valrek-sol/analog-perceptron-gf180mcu/pex/disclosure.md

okay this pex script started with me
manually writing the script and injecting to magic and netgen
got tired,

and i wanted to finish this project properly with full pex results

not possible with my other commitments.

want to learn tcl and python-matplot full power later.

so, just used claude to make a tcl file 
it did! wonderfully so. i couldnt have done this myself. obv supplied initial scripts i made and had to have a small back and forth.

so ai is used in this pex script alone

the rest of the work is all me and my worn out hands toiling away 

but i wanted to give credit to ai where it was due.

wanted to let people know that this pex sscript is not my skill level yet!

focus of this project is a tapeout, and i was selected!

learning full-custom analog design on a non-standard block and FOSS was the goal.

that is done!

next goals related are to actually learn tcl and python-matplot its so powerful. look at what it just did?

just 800 lines of tcl, and it does that! wow!
