valrek-sol/analog-perceptron-gf180mcu/pex/out/summary.md

# PEX / LVS summary — perceptron (gf180mcuD)

Generated by `pex/pex.tcl`. Provenance: [`env.txt`](env.txt).
