valrek-sol/analog-perceptron-gf180mcu/docs/images/black_perceptron_block_diagram.png

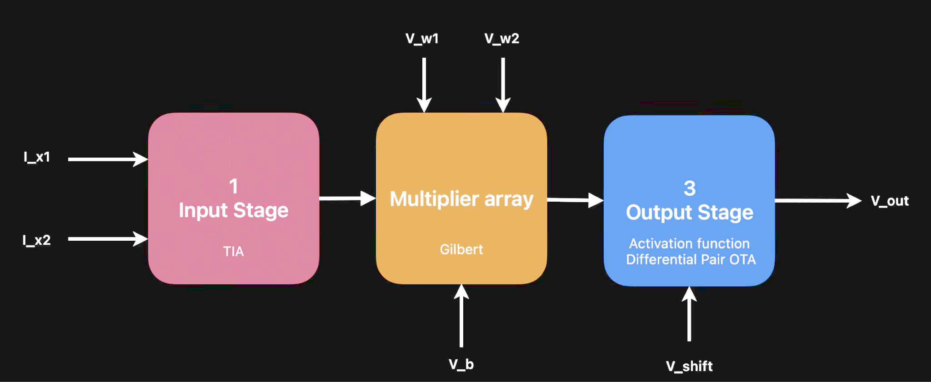
docs/images/black_perceptron_block_diagram.png
