valrek-sol/analog-perceptron-gf180mcu/docs/images/black_perceptron_sketch.png

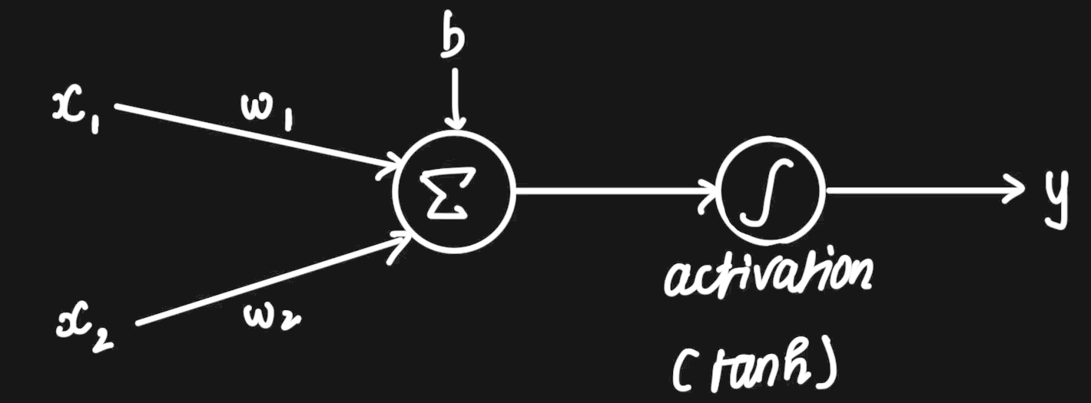
docs/images/black_perceptron_sketch.png
