valrek-sol/analog-perceptron-gf180mcu/layout/visual/black_cg_amp_tia.png

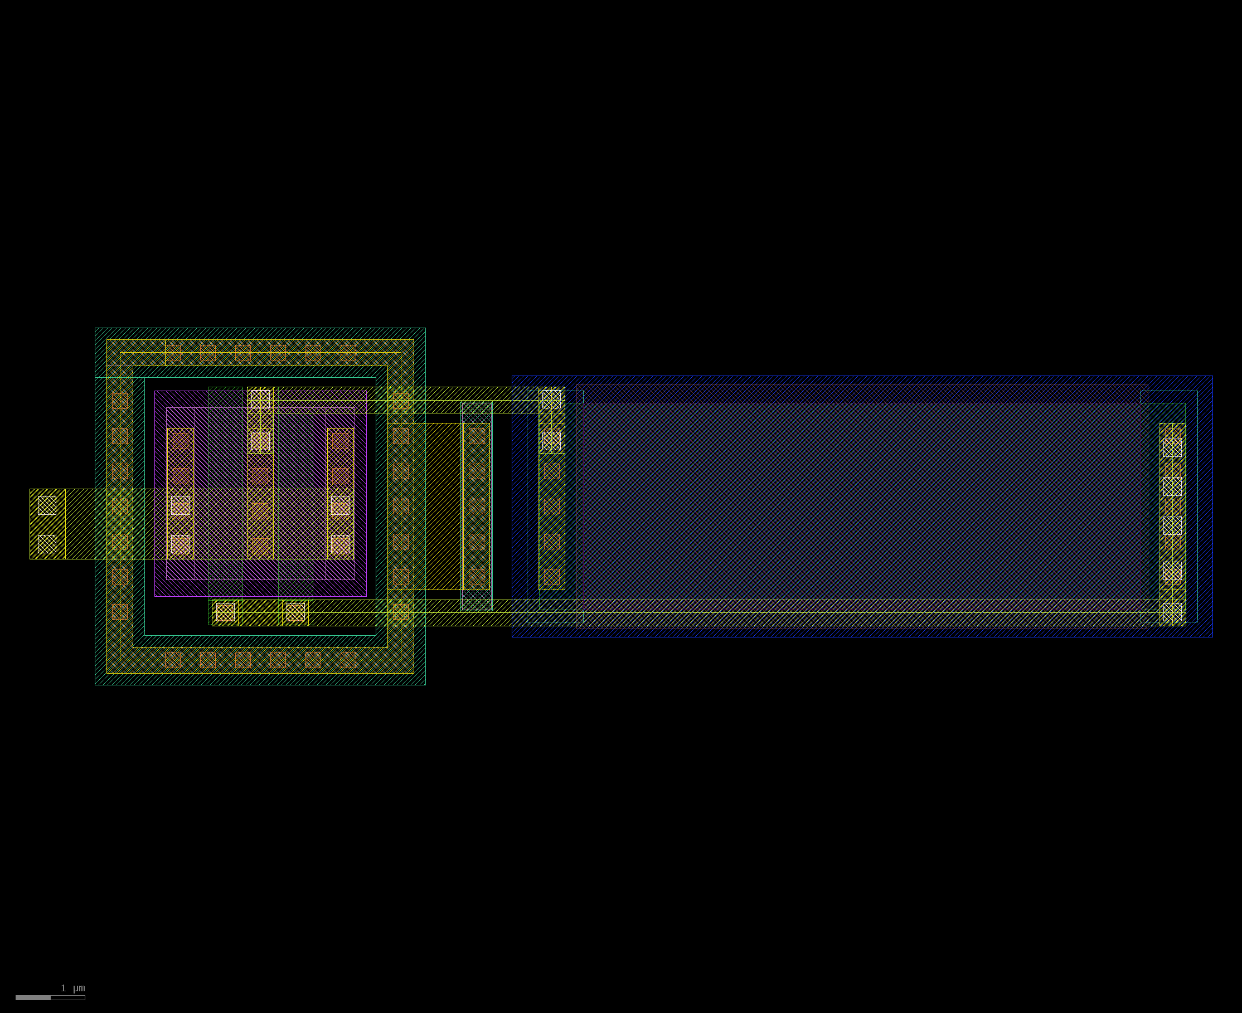
layout/visual/black_cg_amp_tia.png
