valrek-sol/analog-perceptron-gf180mcu/layout/visual/black_gilbert_multiplier_current.png

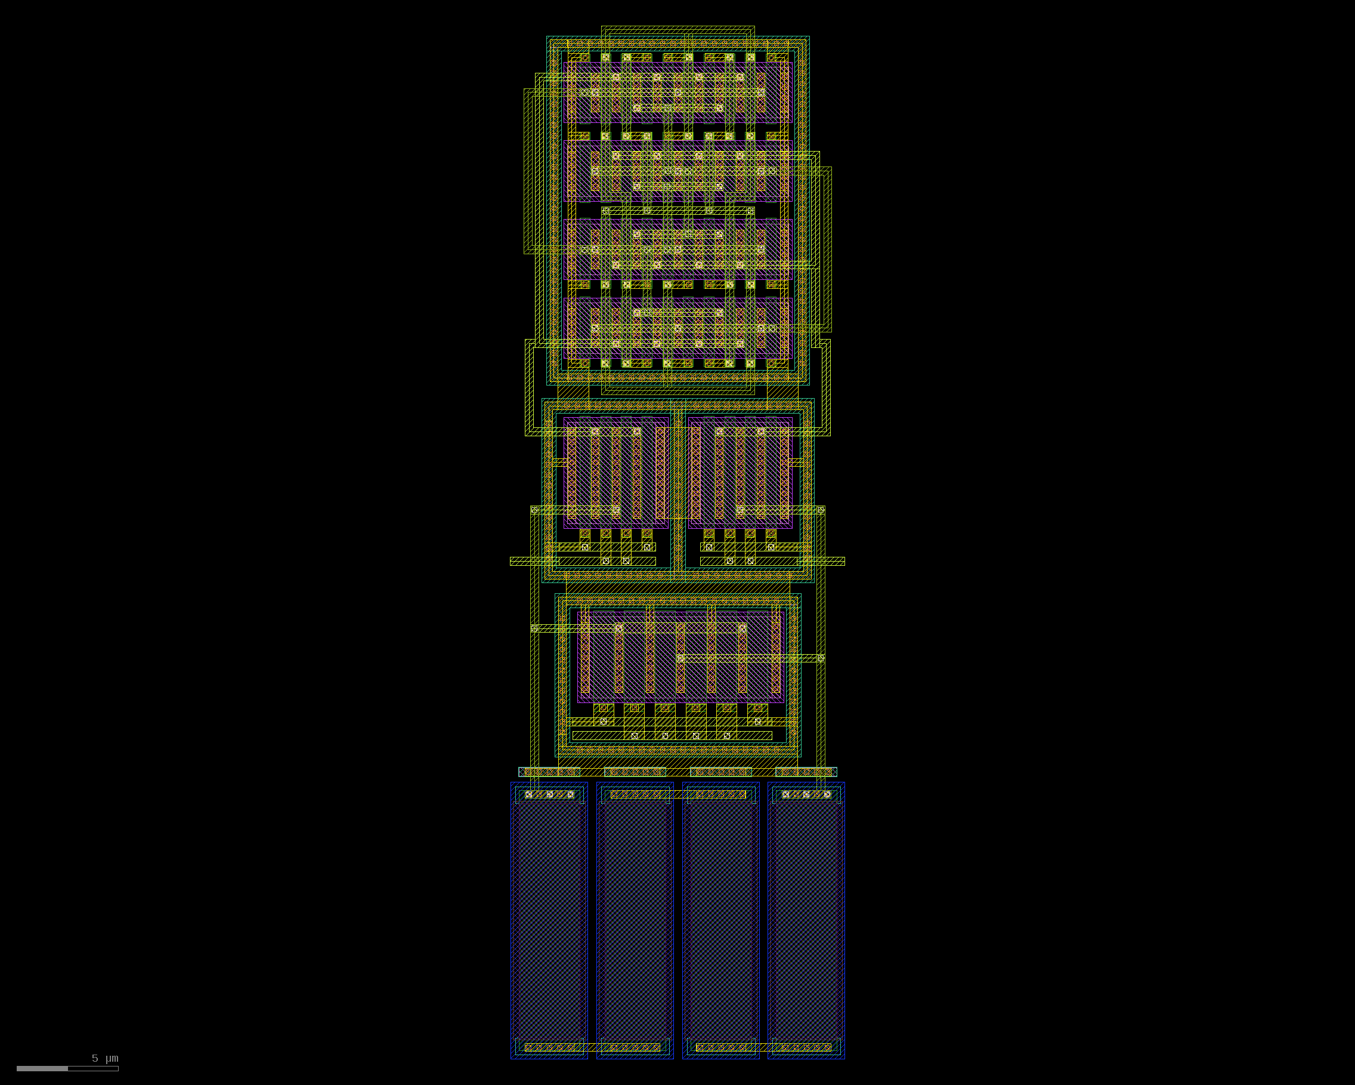
layout/visual/black_gilbert_multiplier_current.png
