valrek-sol/analog-perceptron-gf180mcu/layout/visual/black_gilbert_multiplier_current_detail.png

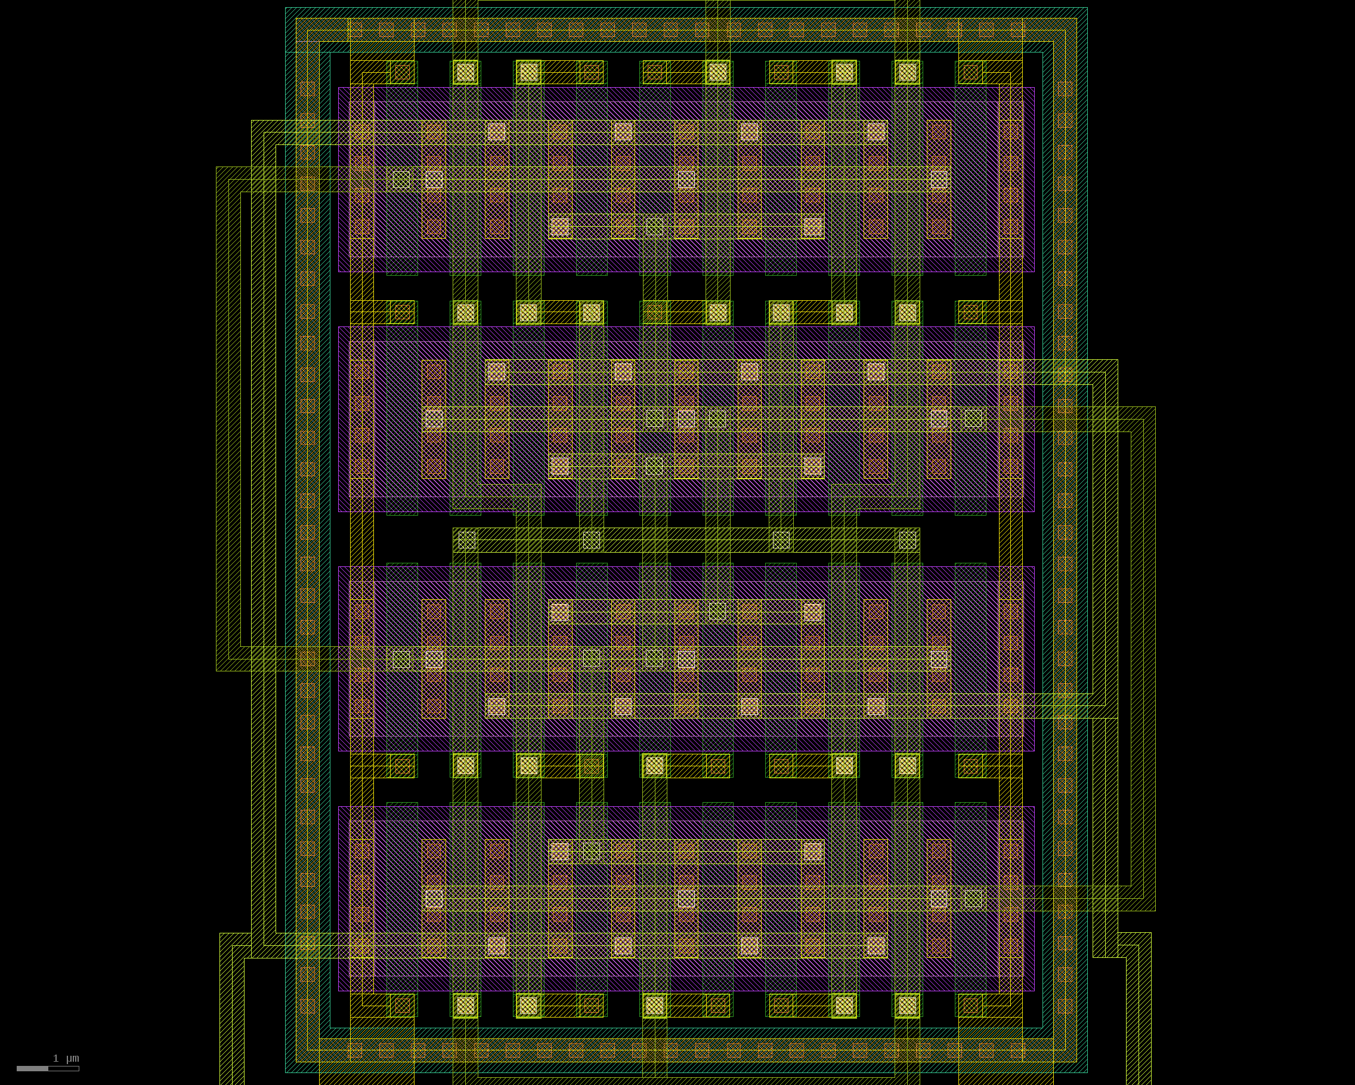
layout/visual/black_gilbert_multiplier_current_detail.png
