valrek-sol/analog-perceptron-gf180mcu/layout/visual/black_io_secondary_5p0.png

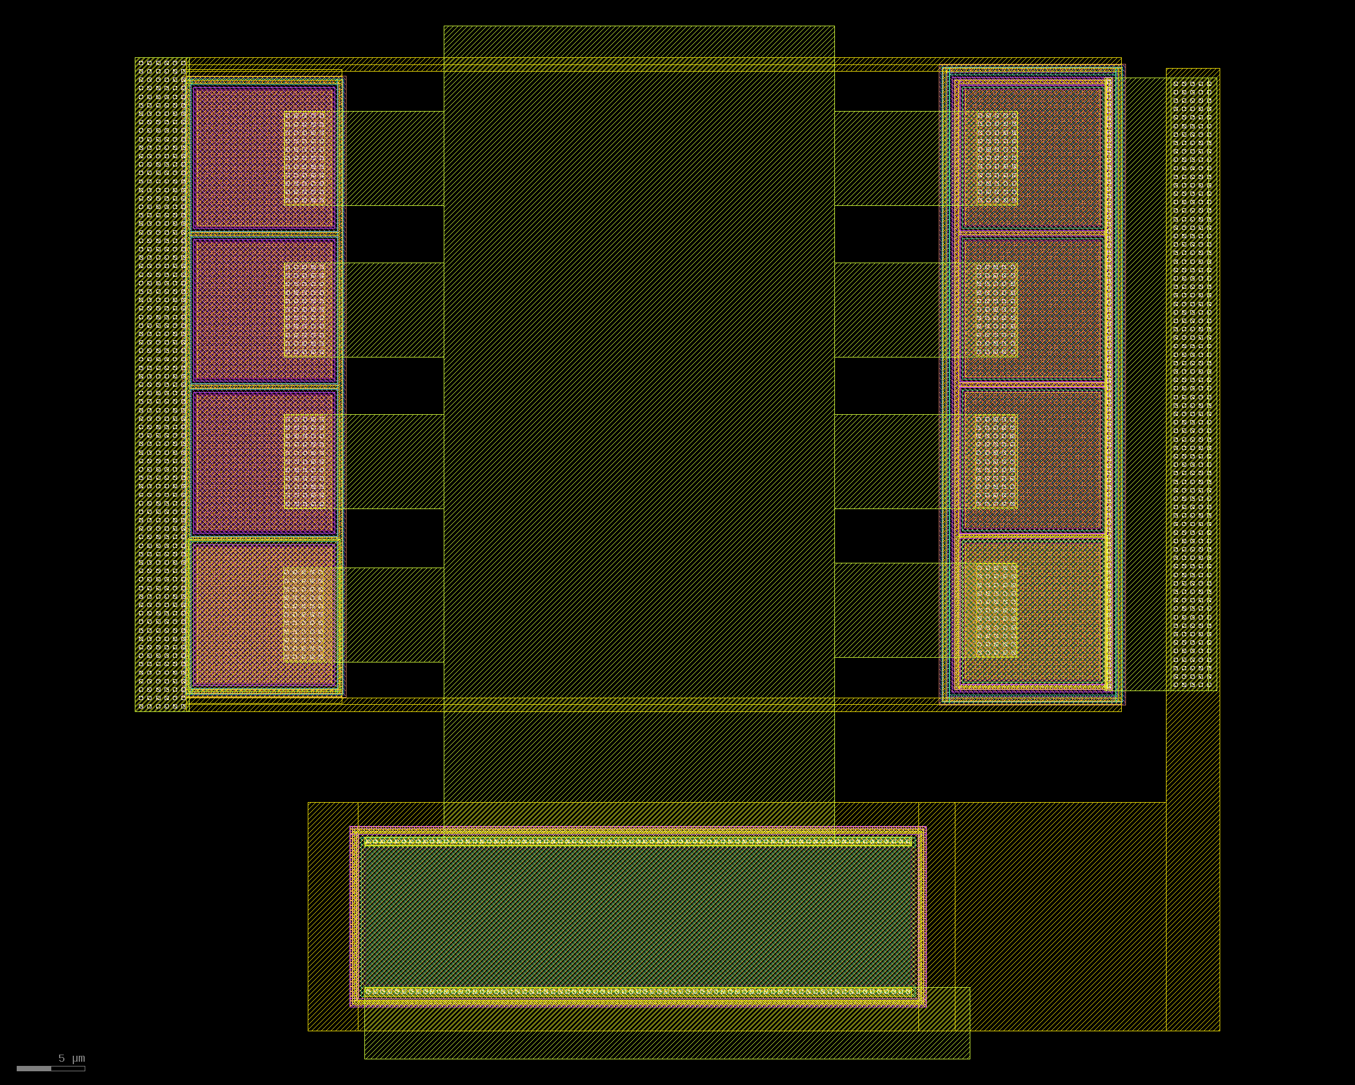
layout/visual/black_io_secondary_5p0.png
