valrek-sol/analog-perceptron-gf180mcu/layout/visual/black_perceptron.png

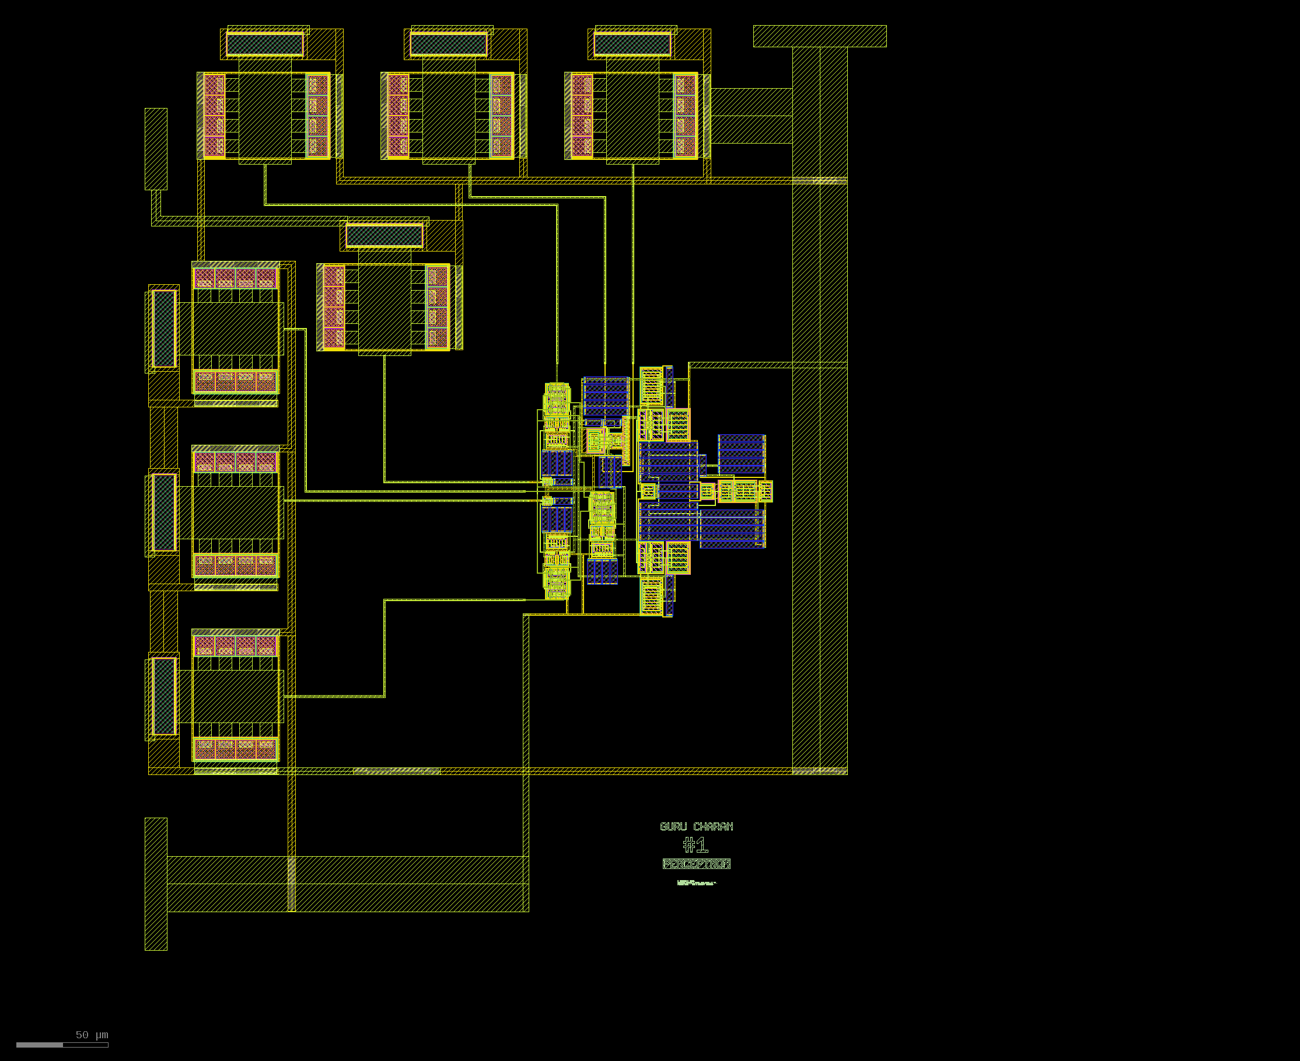
layout/visual/black_perceptron.png
