valrek-sol/analog-perceptron-gf180mcu/layout/visual/black_perceptron_core.png

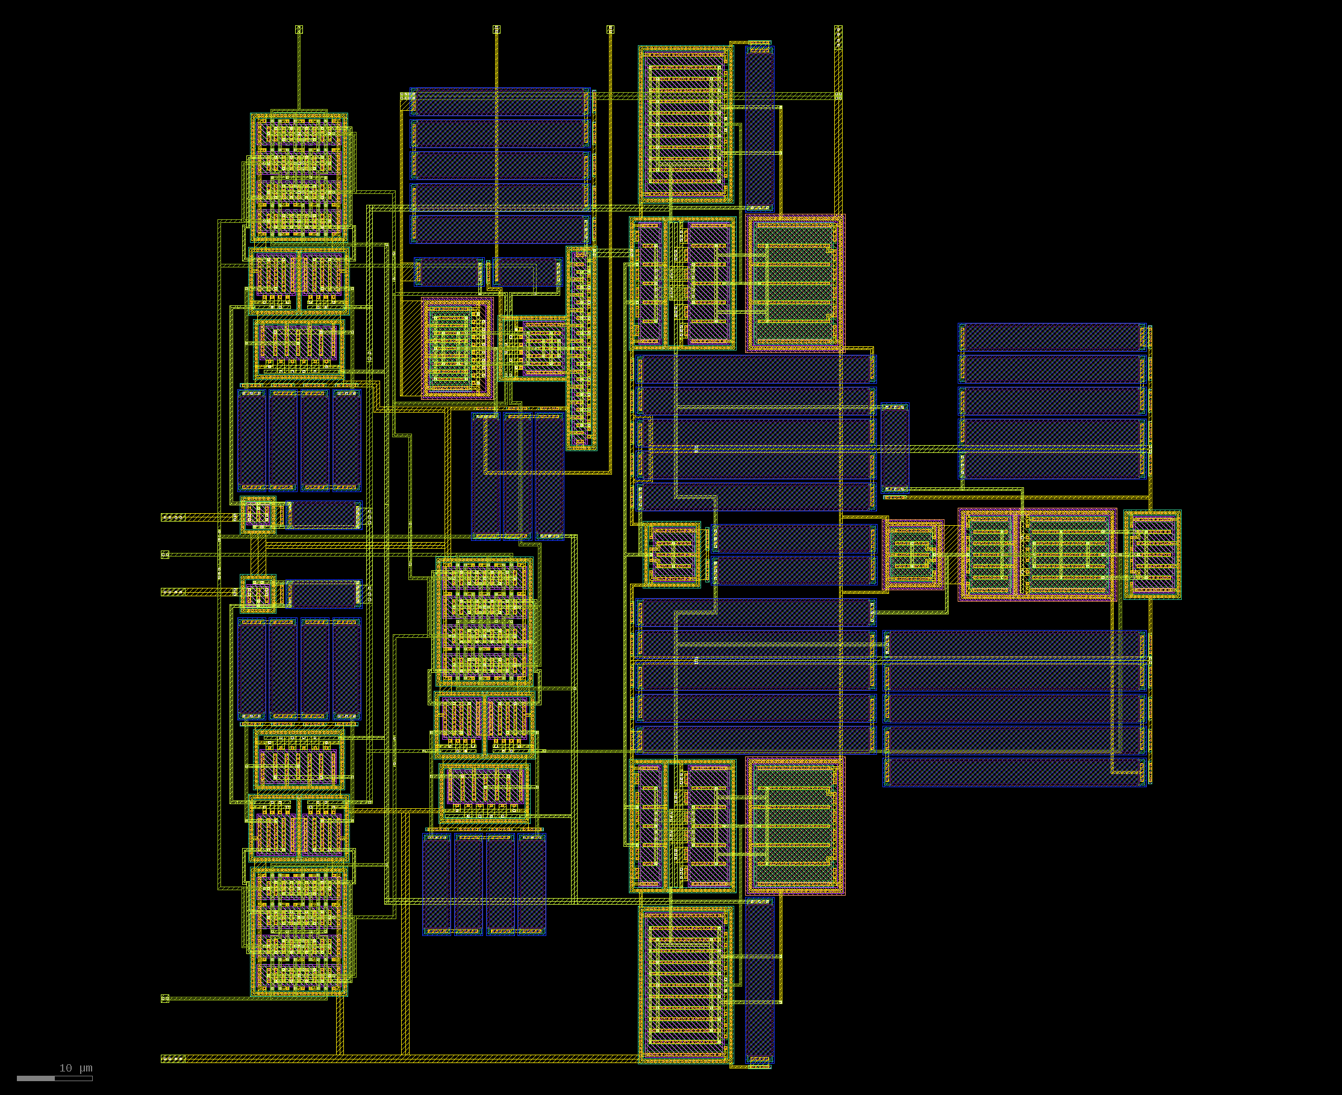
layout/visual/black_perceptron_core.png
