valrek-sol/analog-perceptron-gf180mcu/layout/visual/black_tanh_ota.png

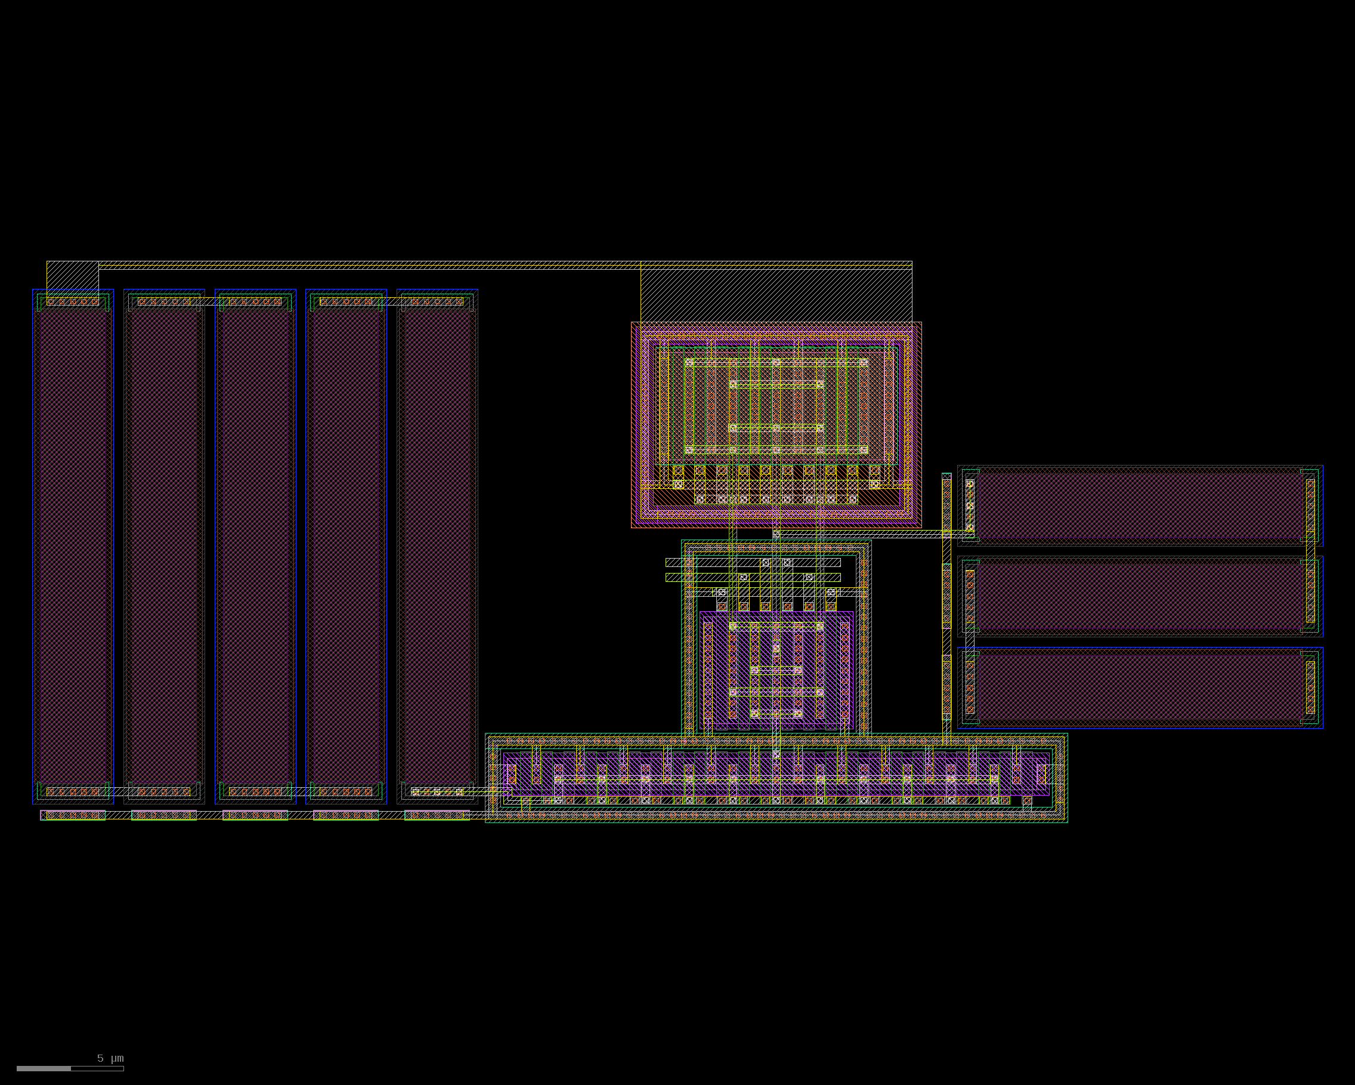
layout/visual/black_tanh_ota.png
