valrek-sol/analog-perceptron-gf180mcu/layout/visual/black_voltage_reference.png

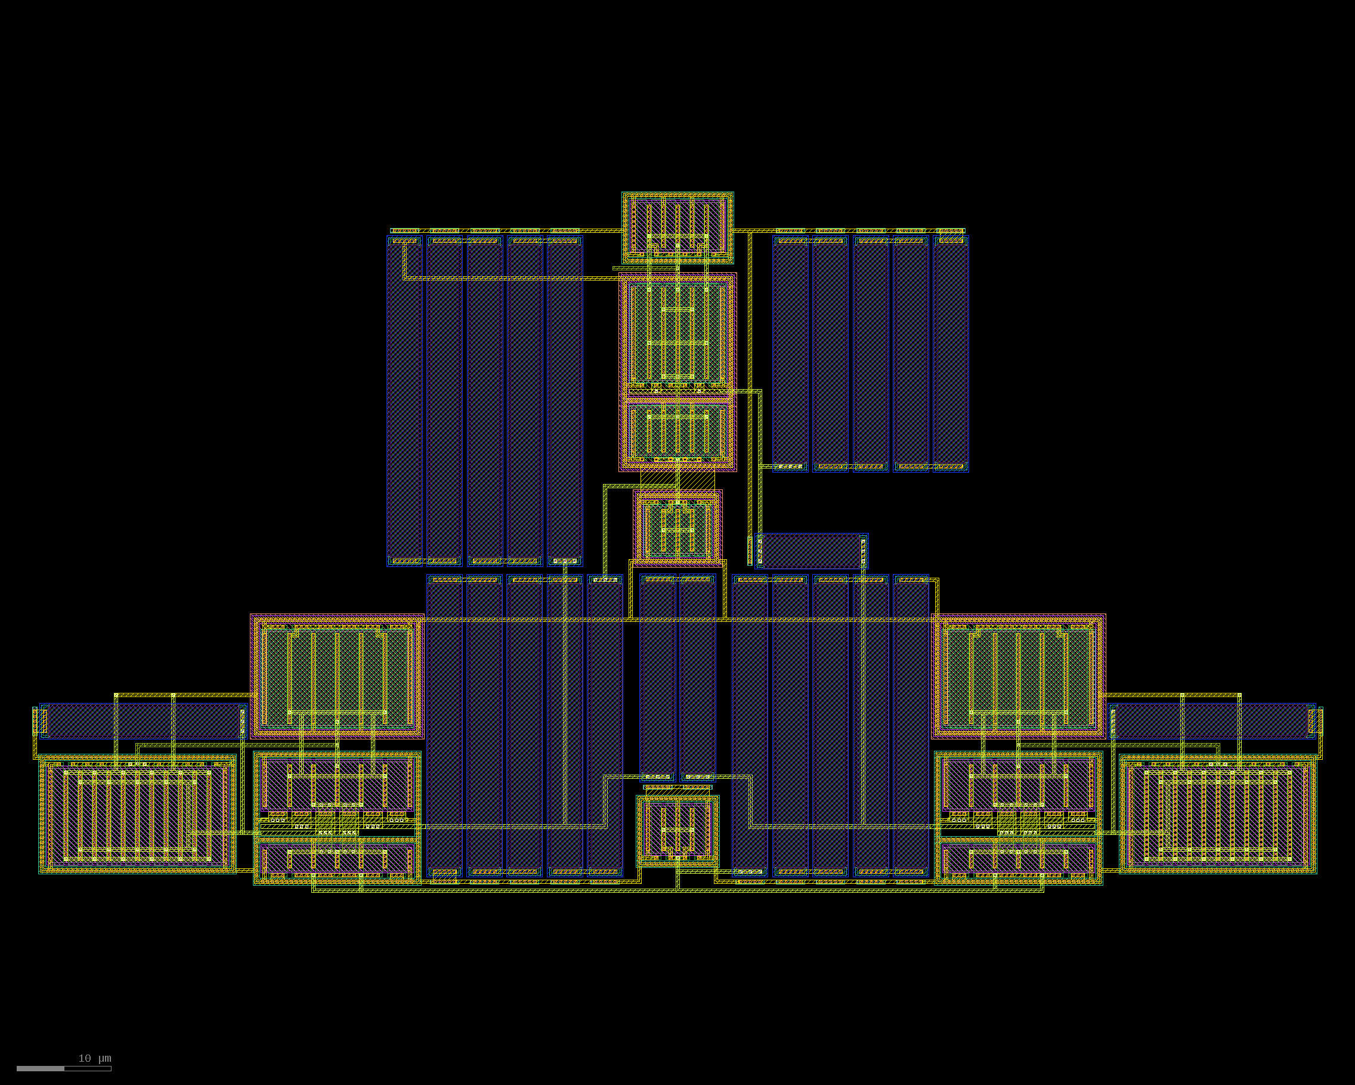
layout/visual/black_voltage_reference.png
