valrek-sol/analog-perceptron-gf180mcu/layout/visual/cg_amp_tia.png

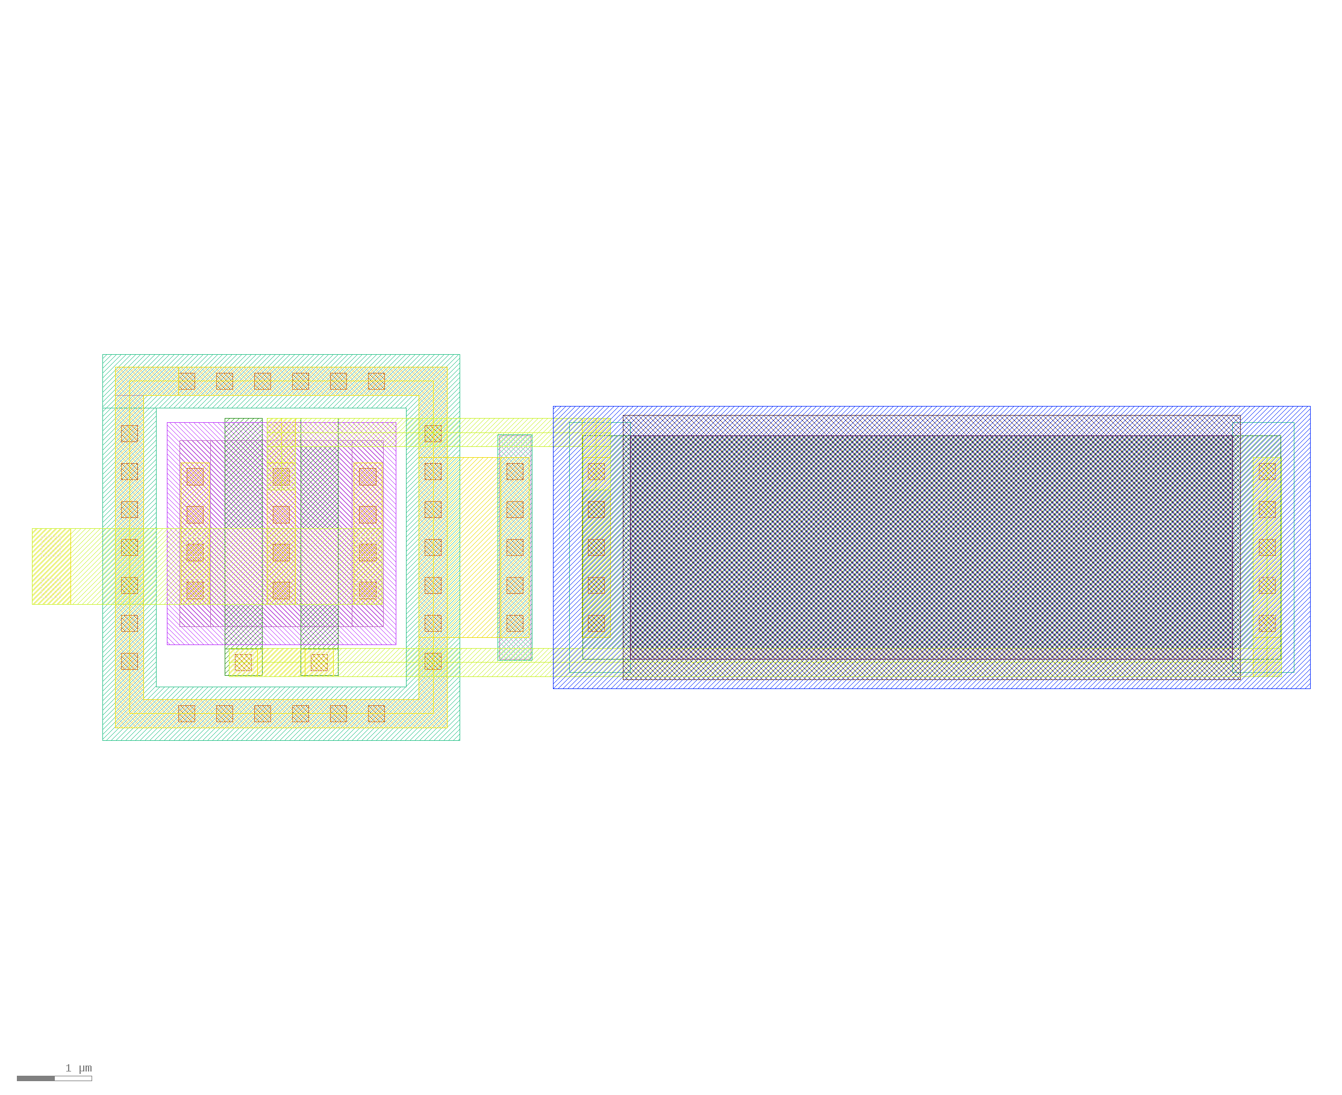
layout/visual/cg_amp_tia.png
