valrek-sol/analog-perceptron-gf180mcu/layout/visual/gilbert_multiplier_current.png

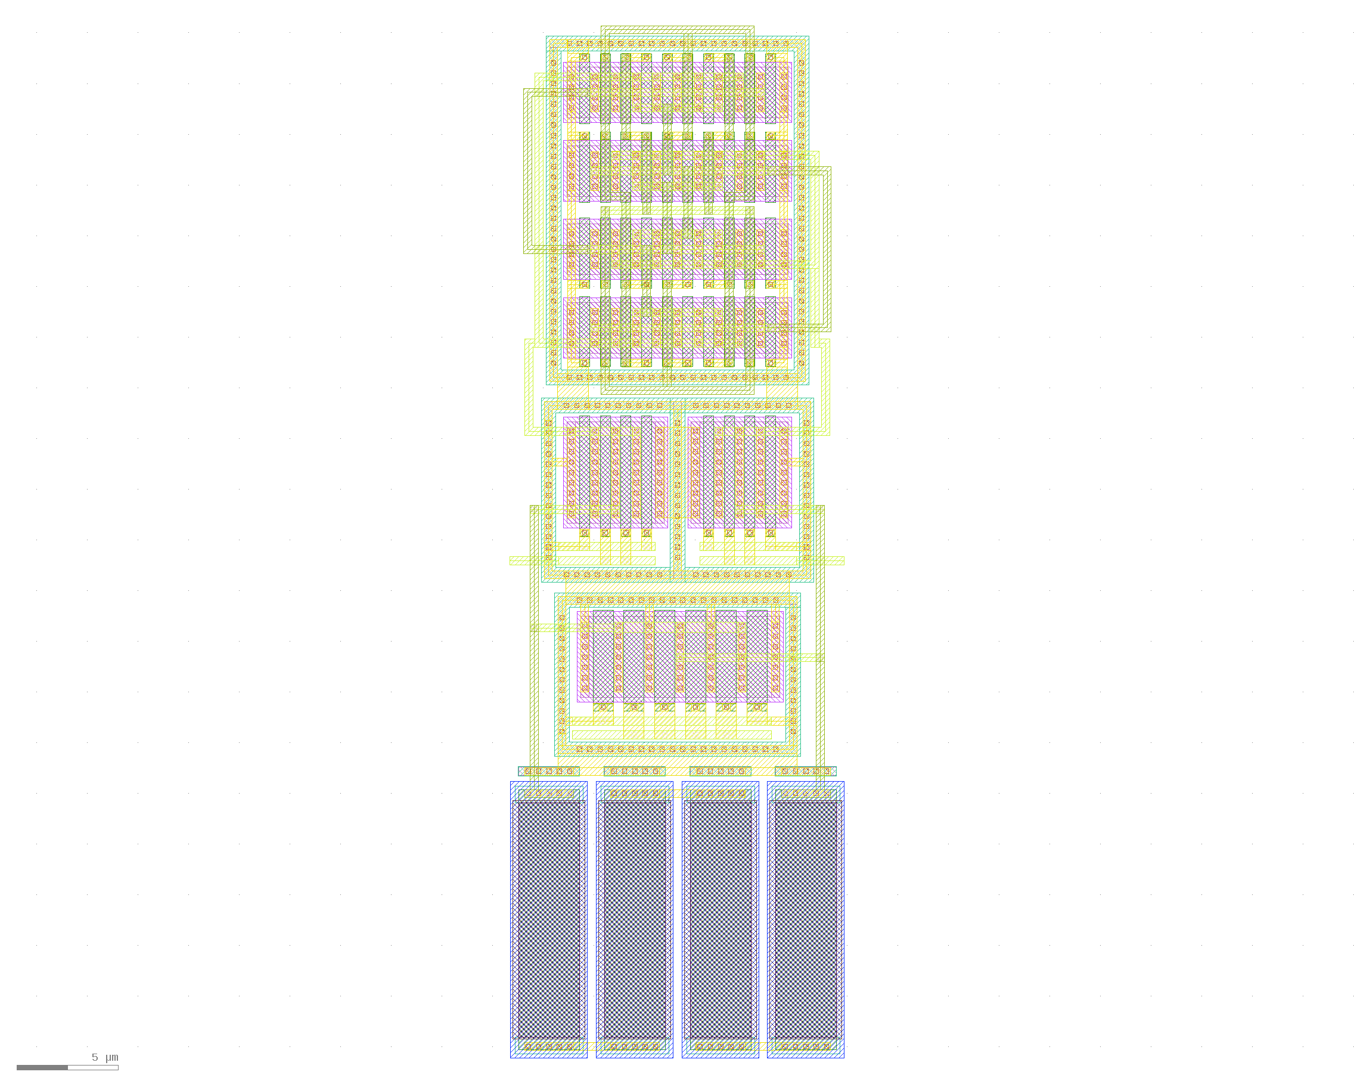
layout/visual/gilbert_multiplier_current.png
