valrek-sol/analog-perceptron-gf180mcu/layout/visual/io_secondary_5p0.png

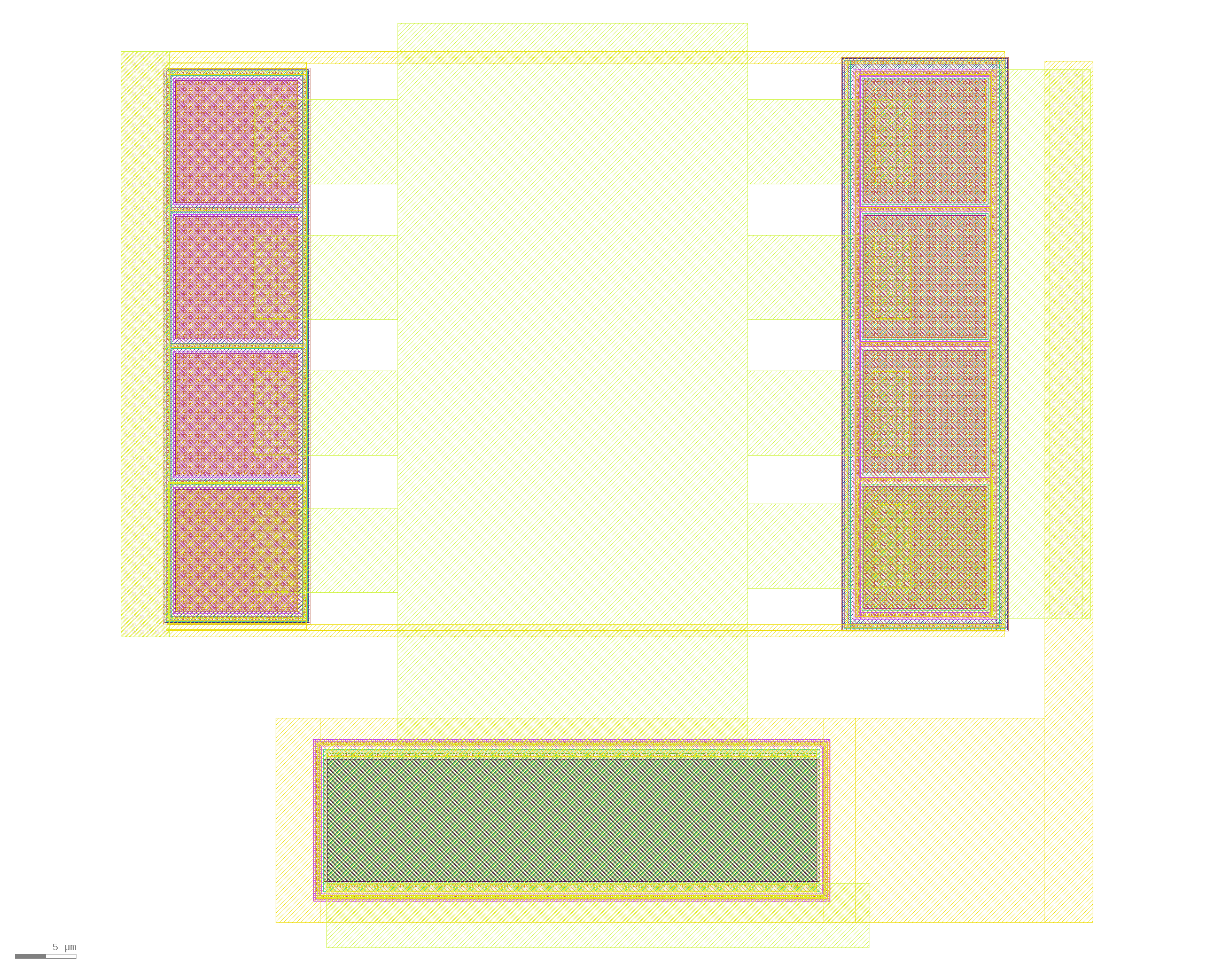
layout/visual/io_secondary_5p0.png
