valrek-sol/analog-perceptron-gf180mcu/layout/visual/perceptron.png

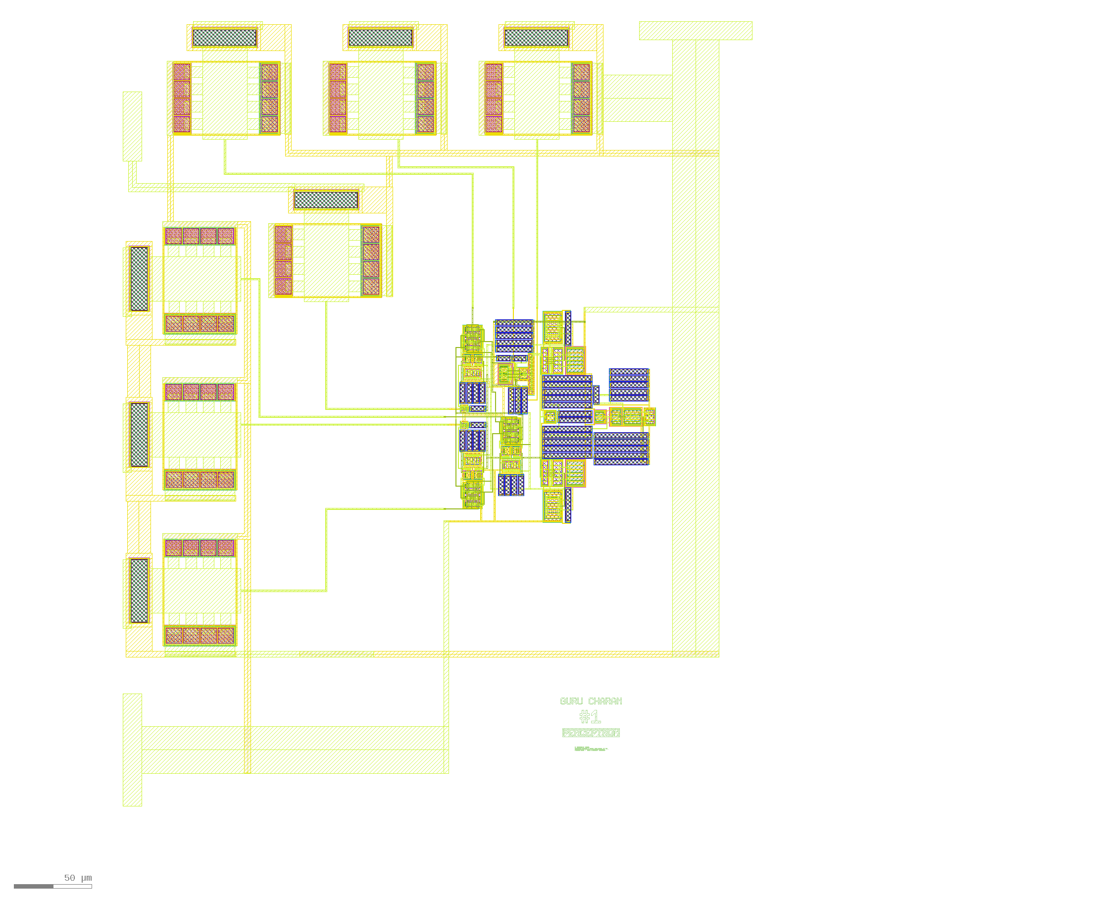
layout/visual/perceptron.png
