valrek-sol/analog-perceptron-gf180mcu/layout/visual/tanh_ota.png

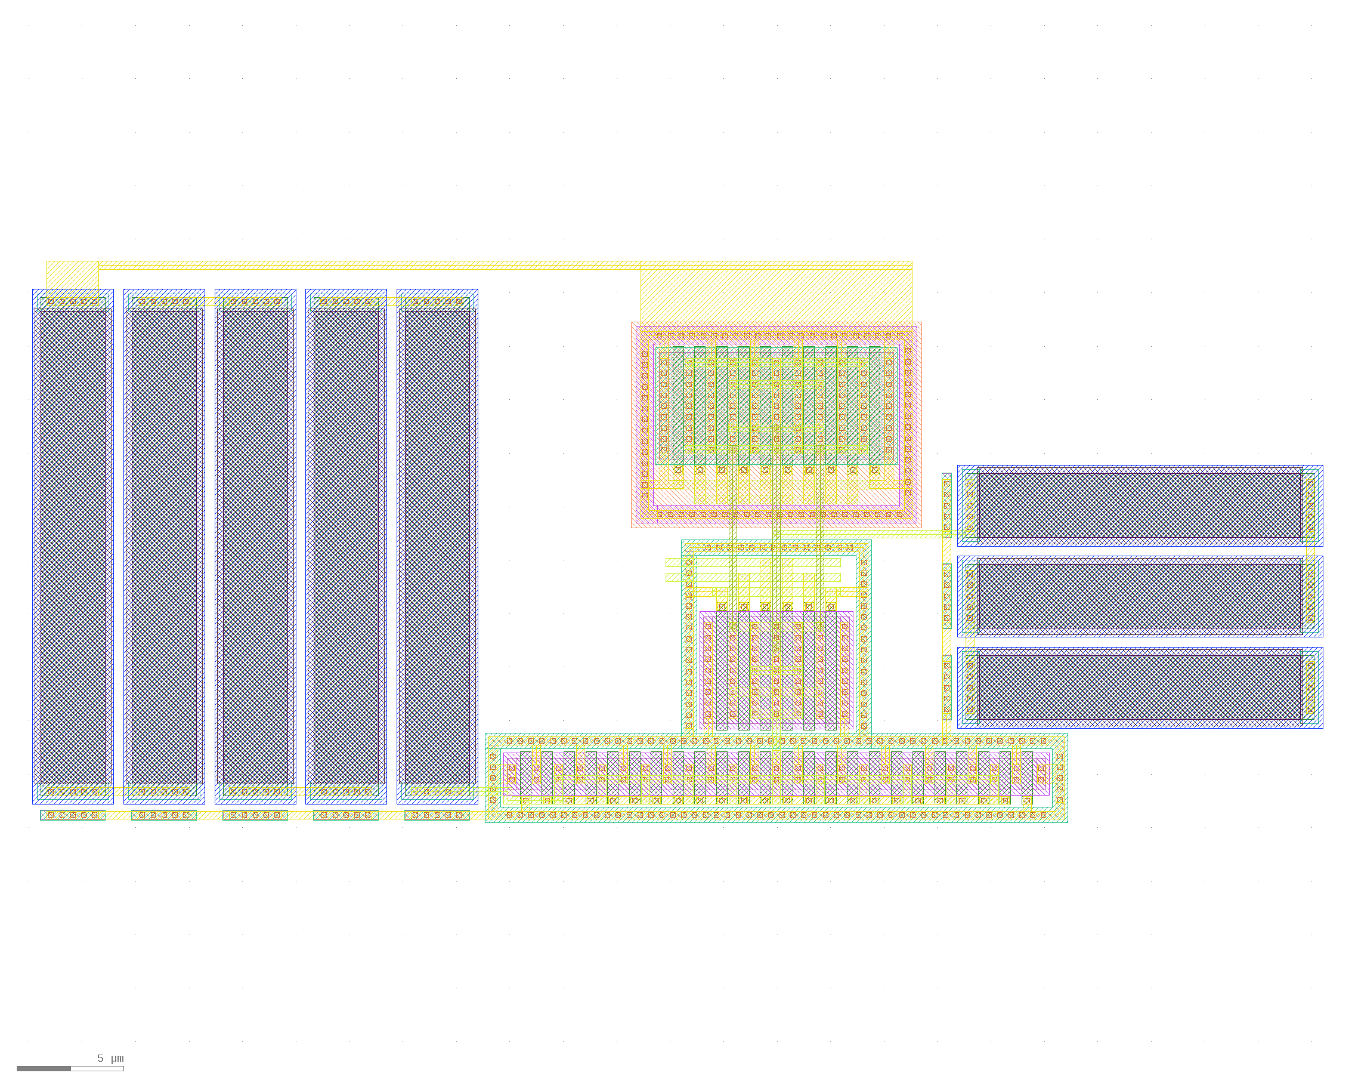
layout/visual/tanh_ota.png
