valrek-sol/analog-perceptron-gf180mcu/layout/visual/voltage_reference.png

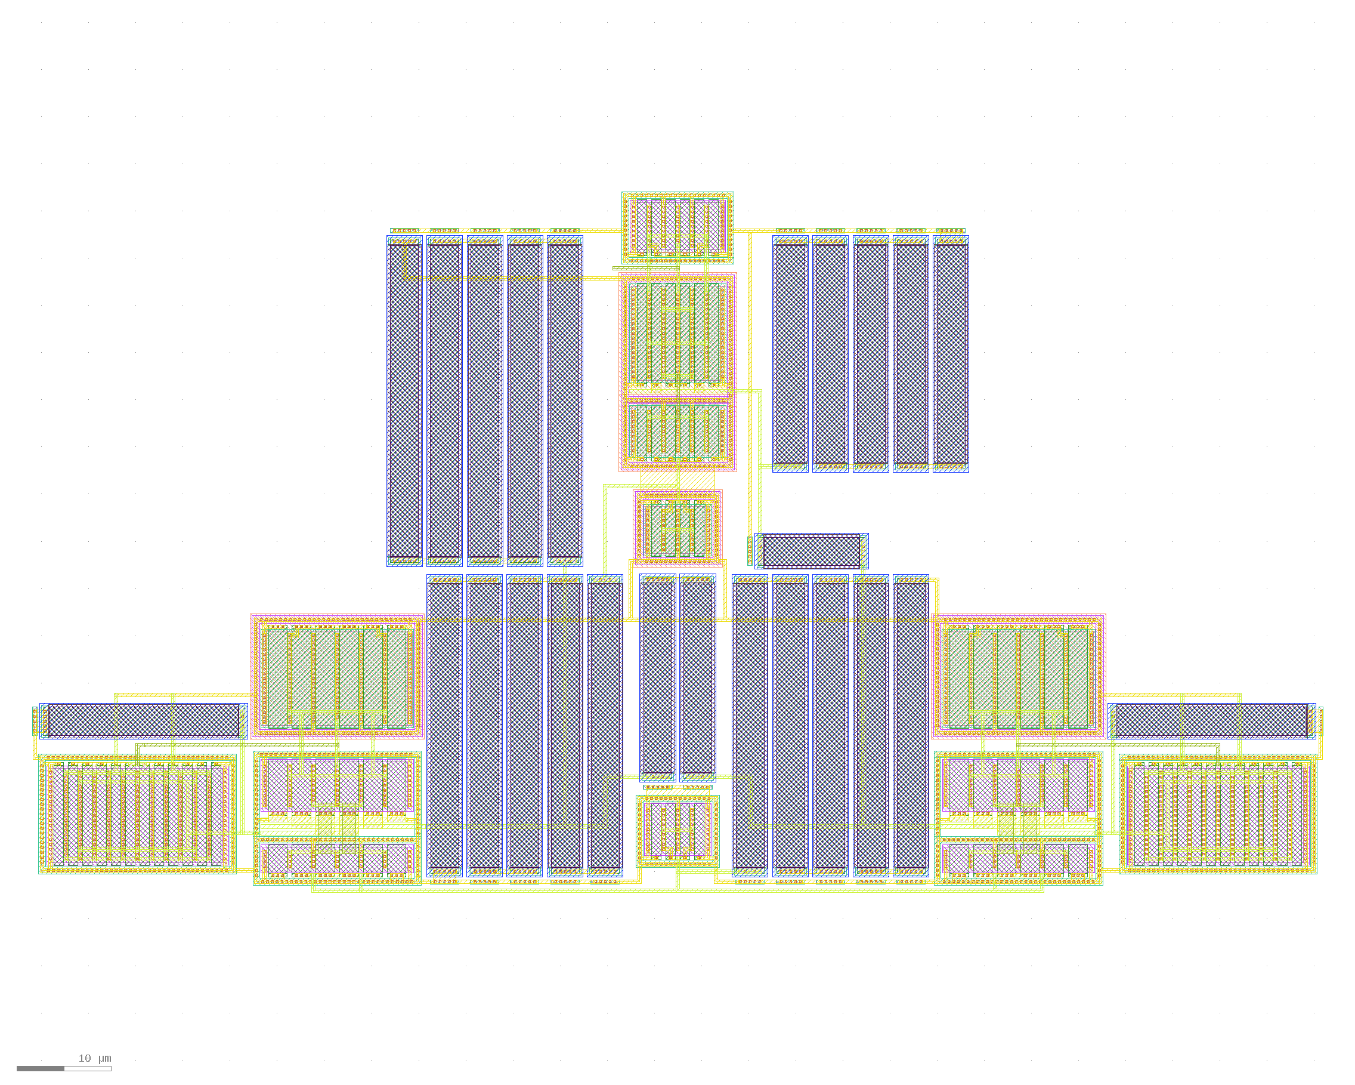
layout/visual/voltage_reference.png
