valrek-sol/analog-perceptron-gf180mcu/pex/out/sim/compare/tb_perceptron/3d_sensors.png

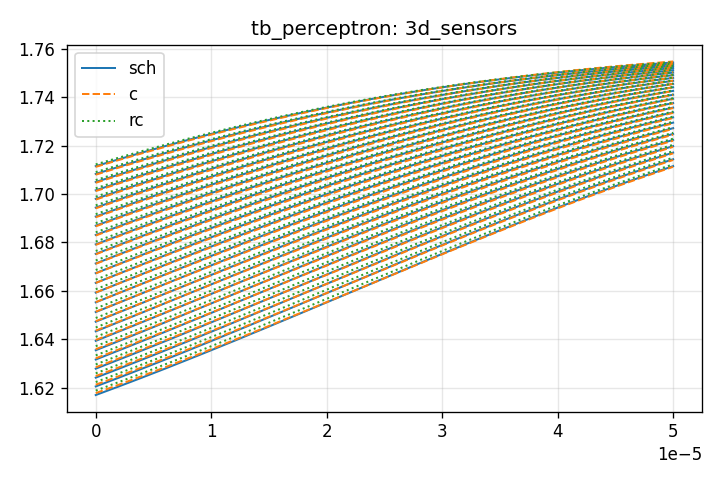
pex/out/sim/compare/tb_perceptron/3d_sensors.png
