valrek-sol/analog-perceptron-gf180mcu/pex/out/sim/compare/tb_perceptron/perceptron_graph1_weights.png

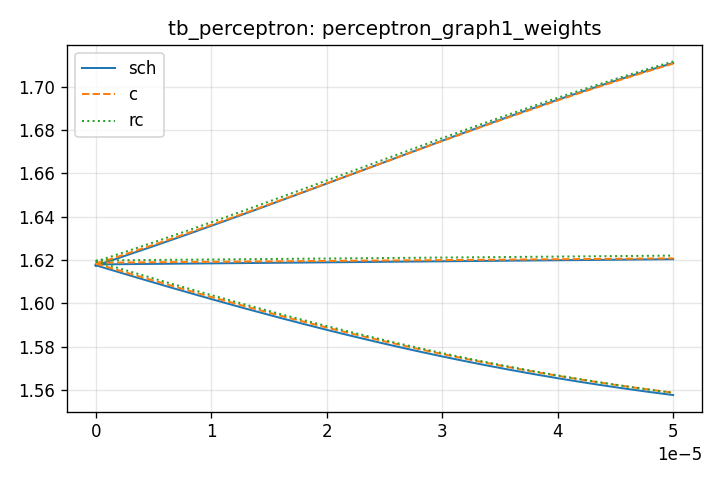
pex/out/sim/compare/tb_perceptron/perceptron_graph1_weights.png
