valrek-sol/analog-perceptron-gf180mcu/pex/out/sim/compare/tb_perceptron_core/3d_sensors.png

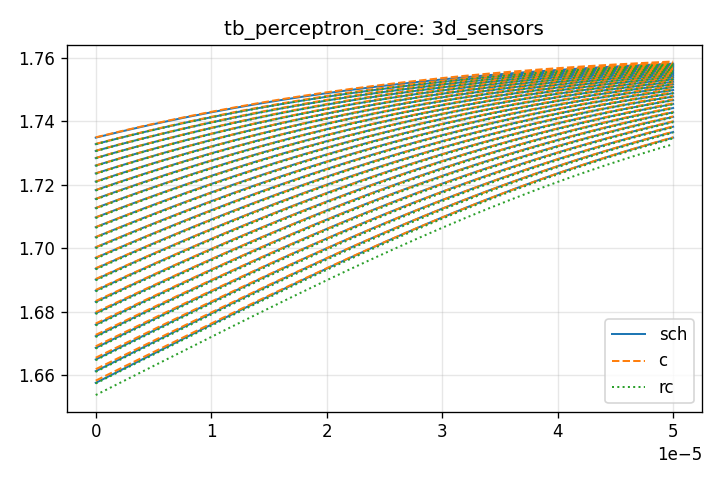
pex/out/sim/compare/tb_perceptron_core/3d_sensors.png
