valrek-sol/analog-perceptron-gf180mcu/pex/out/sim/compare/tb_perceptron_core/opsweep_perceptron_chain_ix2.png

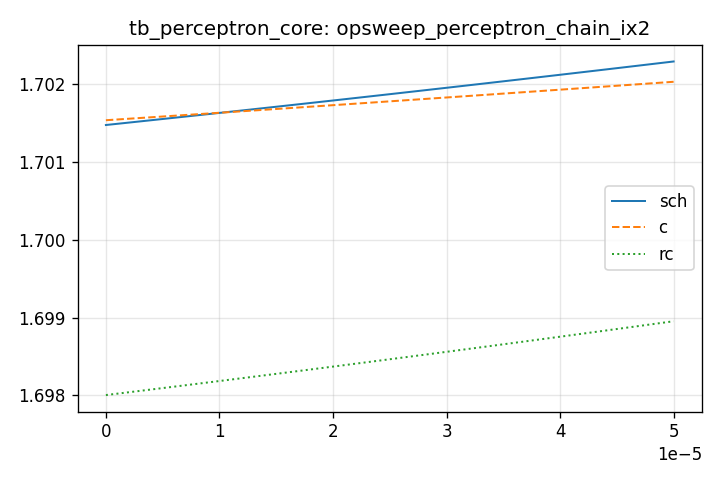
pex/out/sim/compare/tb_perceptron_core/opsweep_perceptron_chain_ix2.png
