valrek-sol/analog-perceptron-gf180mcu/pex/out/sim/compare/tb_perceptron_core/perceptron_graph3_bias.png

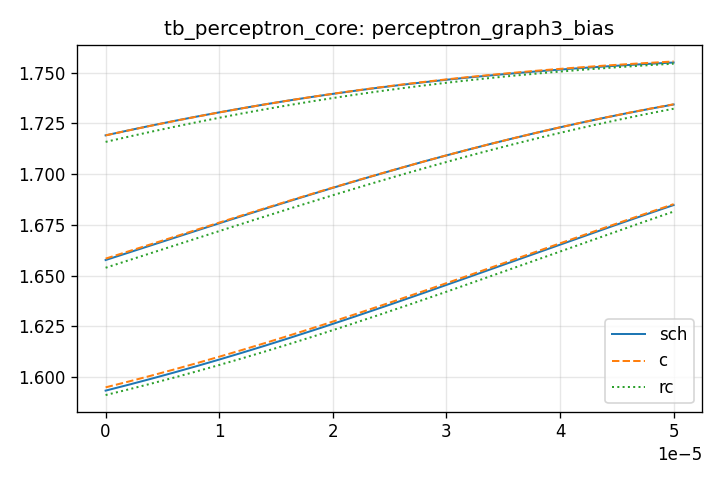
pex/out/sim/compare/tb_perceptron_core/perceptron_graph3_bias.png
