valrek-sol/analog-perceptron-gf180mcu/pex/out/sim/compare/tb_perceptron_core/perceptron_graph4_vshift.png

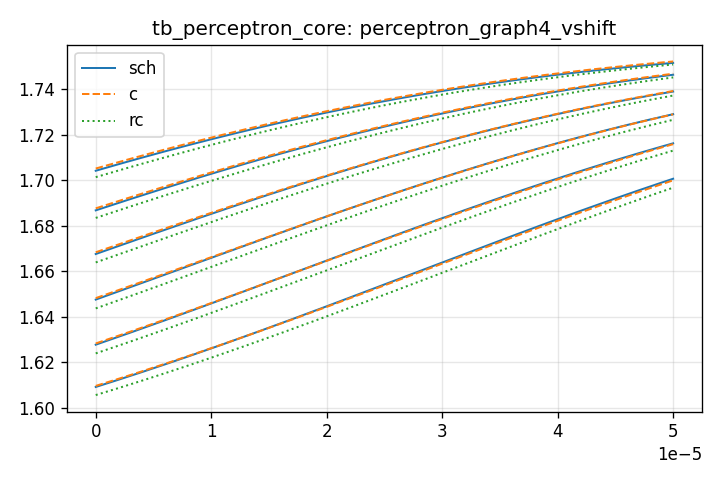
pex/out/sim/compare/tb_perceptron_core/perceptron_graph4_vshift.png
