valrek-sol/analog-perceptron-gf180mcu/pex/out/sim/compare/tb_realistic_perceptron_core/real_perceptron_graph2_sensors.png

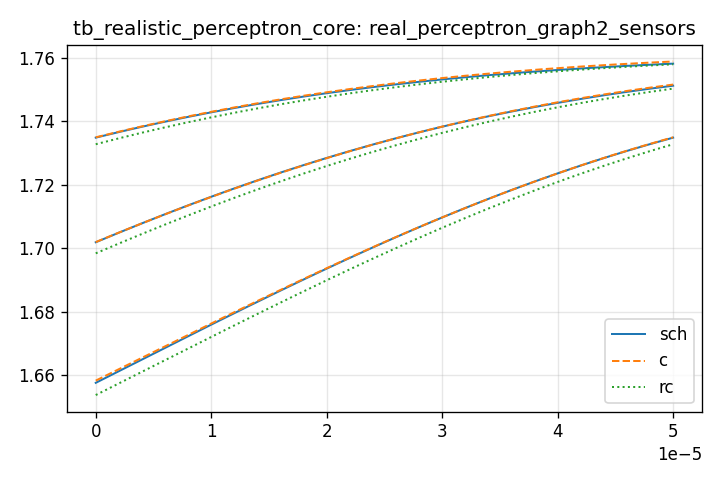
pex/out/sim/compare/tb_realistic_perceptron_core/real_perceptron_graph2_sensors.png
