valrek-sol/analog-perceptron-gf180mcu/pex/out/sim/compare/tb_realistic_perceptron_core/real_tran_perceptron.png

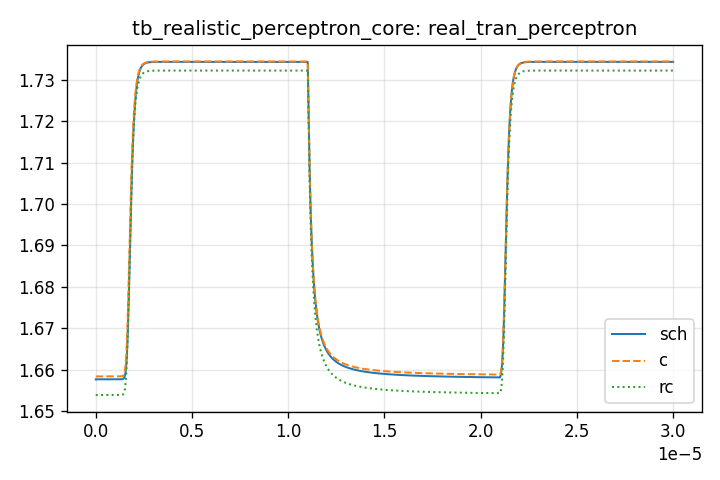
pex/out/sim/compare/tb_realistic_perceptron_core/real_tran_perceptron.png
