valrek-sol/analog-perceptron-gf180mcu/pex/out/sim/tb_perceptron_c/plots/plots_generated/05_perceptron_weights.png

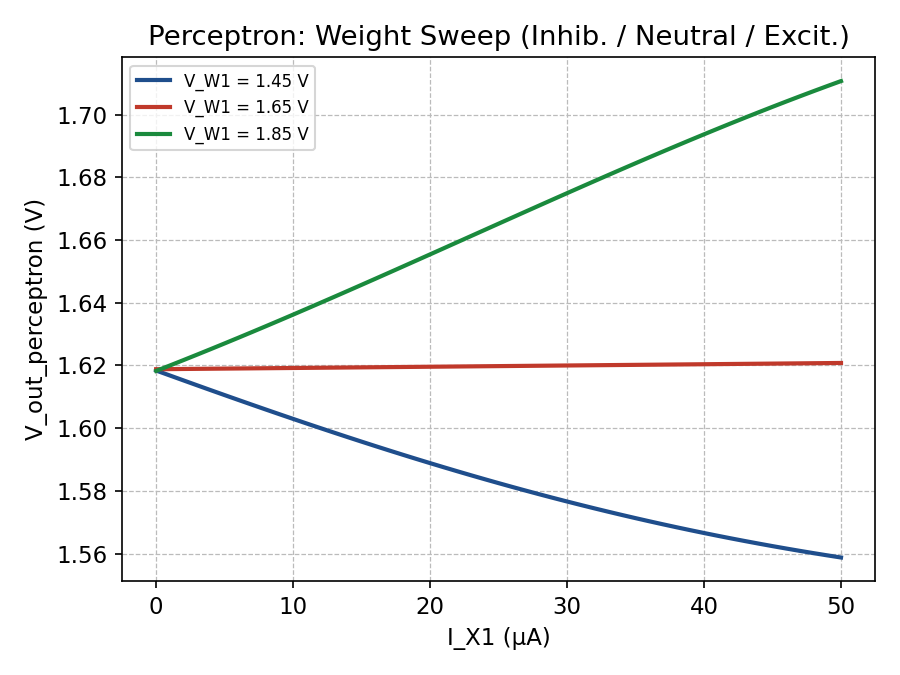
pex/out/sim/tb_perceptron_c/plots/plots_generated/05_perceptron_weights.png
