valrek-sol/analog-perceptron-gf180mcu/pex/out/sim/tb_perceptron_c/plots/plots_generated/07_perceptron_bias.png

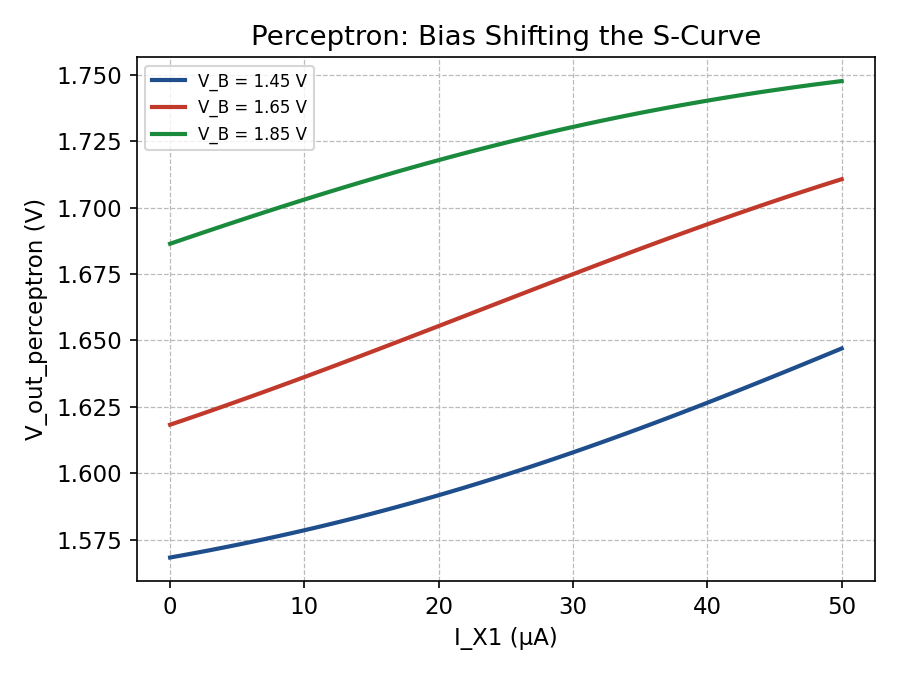
pex/out/sim/tb_perceptron_c/plots/plots_generated/07_perceptron_bias.png
