valrek-sol/analog-perceptron-gf180mcu/pex/out/sim/tb_perceptron_c/plots/plots_generated/08_perceptron_3d_sensors.png

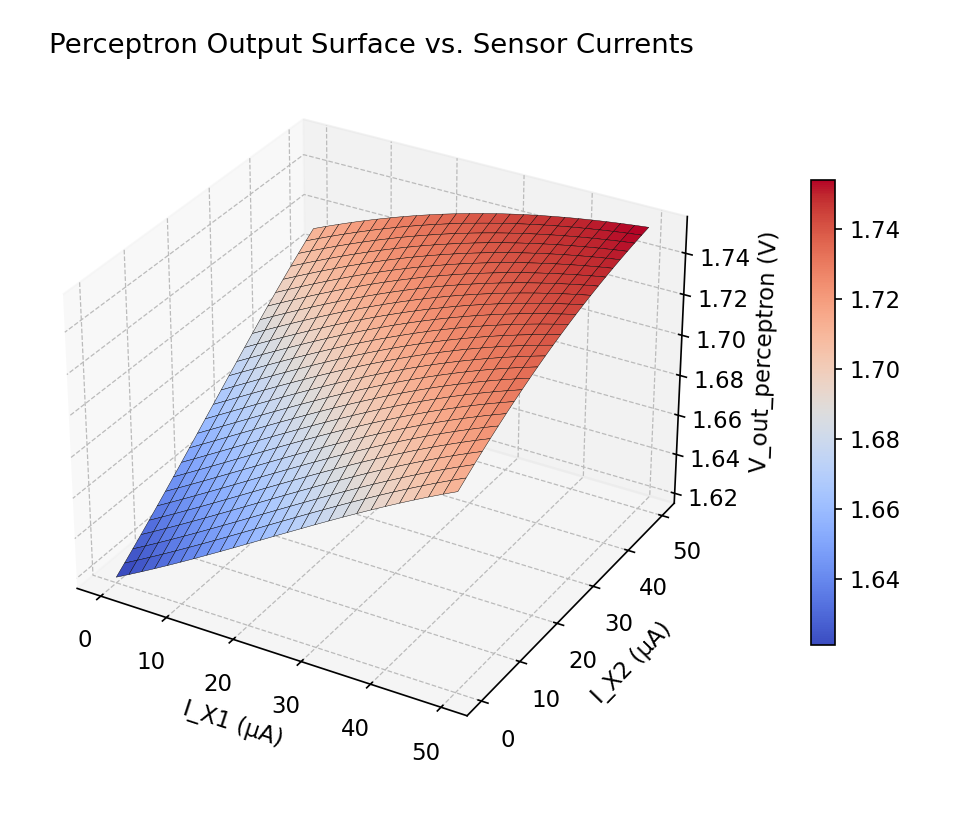
pex/out/sim/tb_perceptron_c/plots/plots_generated/08_perceptron_3d_sensors.png
