valrek-sol/analog-perceptron-gf180mcu/pex/out/sim/tb_perceptron_core_c/plots/plots_generated/06_perceptron_sensors.png

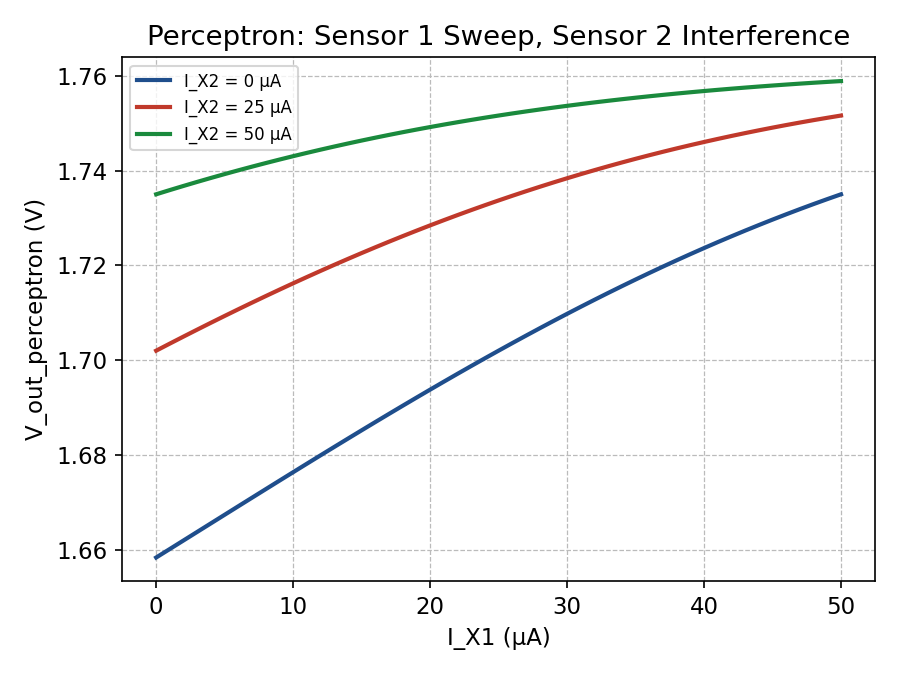
pex/out/sim/tb_perceptron_core_c/plots/plots_generated/06_perceptron_sensors.png
