valrek-sol/analog-perceptron-gf180mcu/pex/out/sim/tb_perceptron_sch/plots/plots_generated/10_perceptron_vshift.png

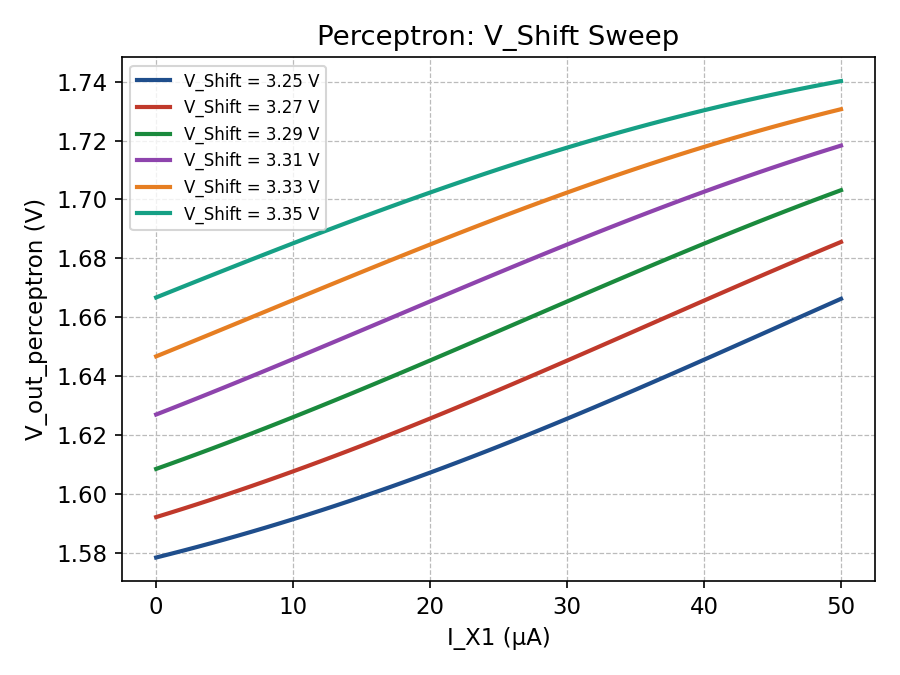
pex/out/sim/tb_perceptron_sch/plots/plots_generated/10_perceptron_vshift.png
