valrek-sol/analog-perceptron-gf180mcu/pex/out/sim/tb_realistic_perceptron_core_c/plots/plots_generated_real/08_real_3d_weights.png

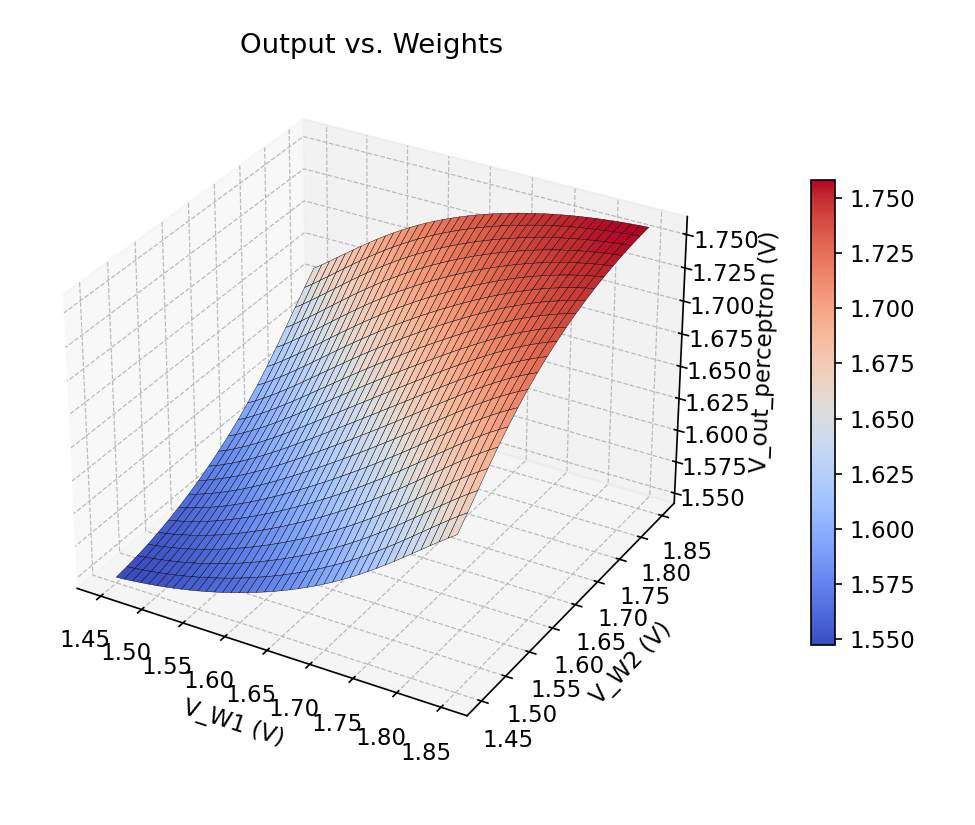
pex/out/sim/tb_realistic_perceptron_core_c/plots/plots_generated_real/08_real_3d_weights.png
