valrek-sol/analog-perceptron-gf180mcu/pex/out/sim/tb_realistic_perceptron_core_sch/plots/plots_generated_real/02_real_ac_response.png

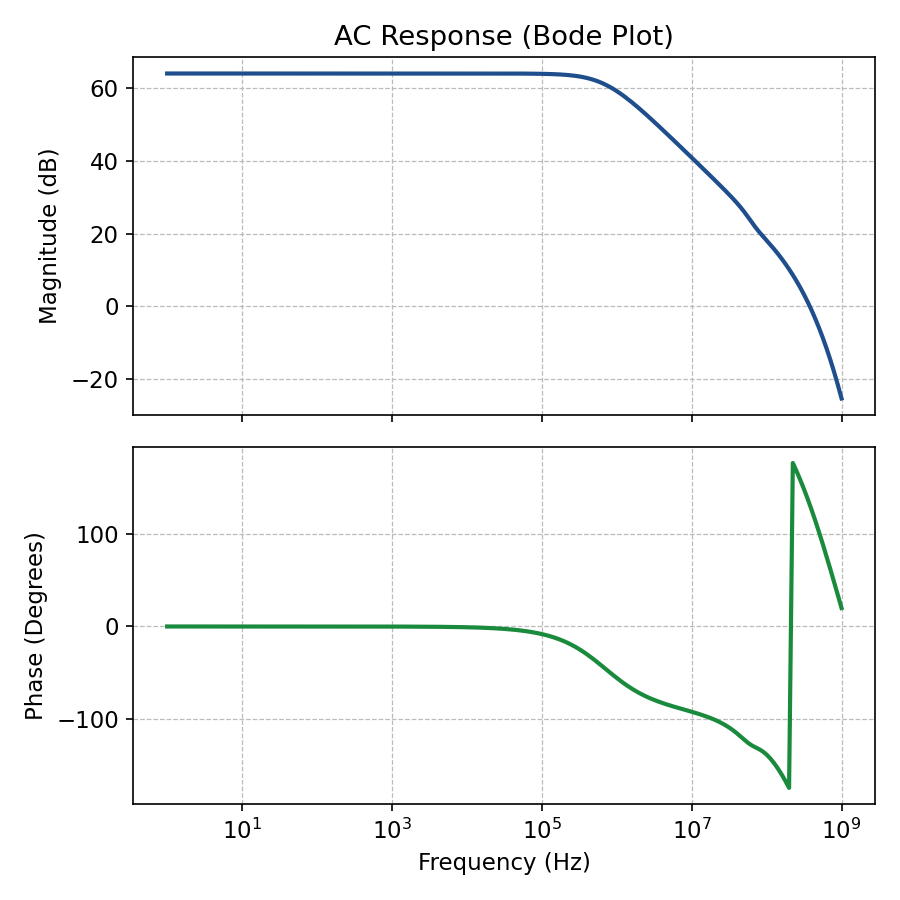
pex/out/sim/tb_realistic_perceptron_core_sch/plots/plots_generated_real/02_real_ac_response.png
