valrek-sol/analog-perceptron-gf180mcu/plots/opsweep_generated/opsweep_01_tia_vov.png

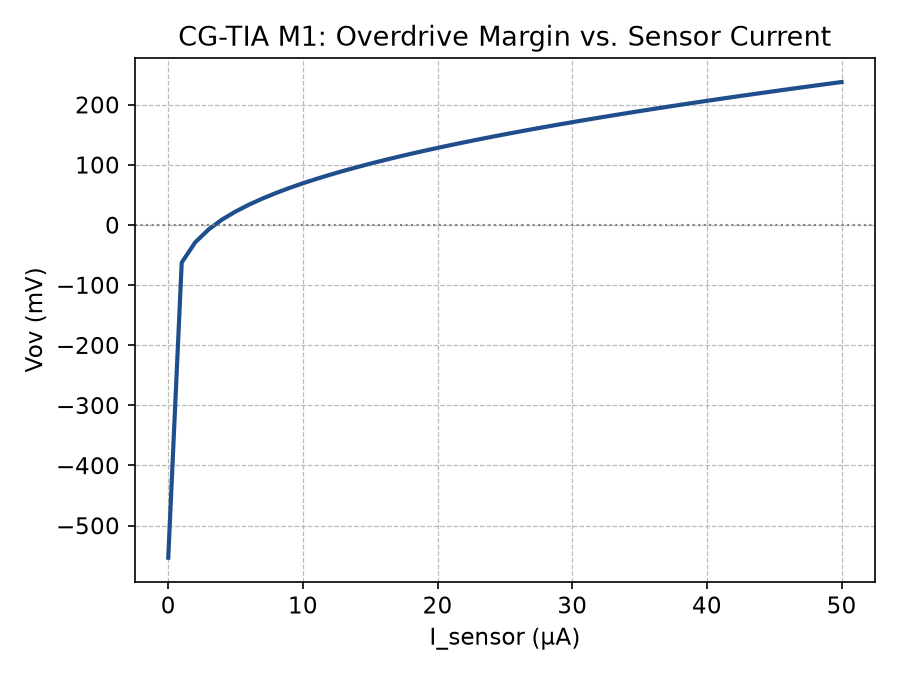
plots/opsweep_generated/opsweep_01_tia_vov.png
