valrek-sol/analog-perceptron-gf180mcu/plots/opsweep_generated/opsweep_02_gilbert_vov.png

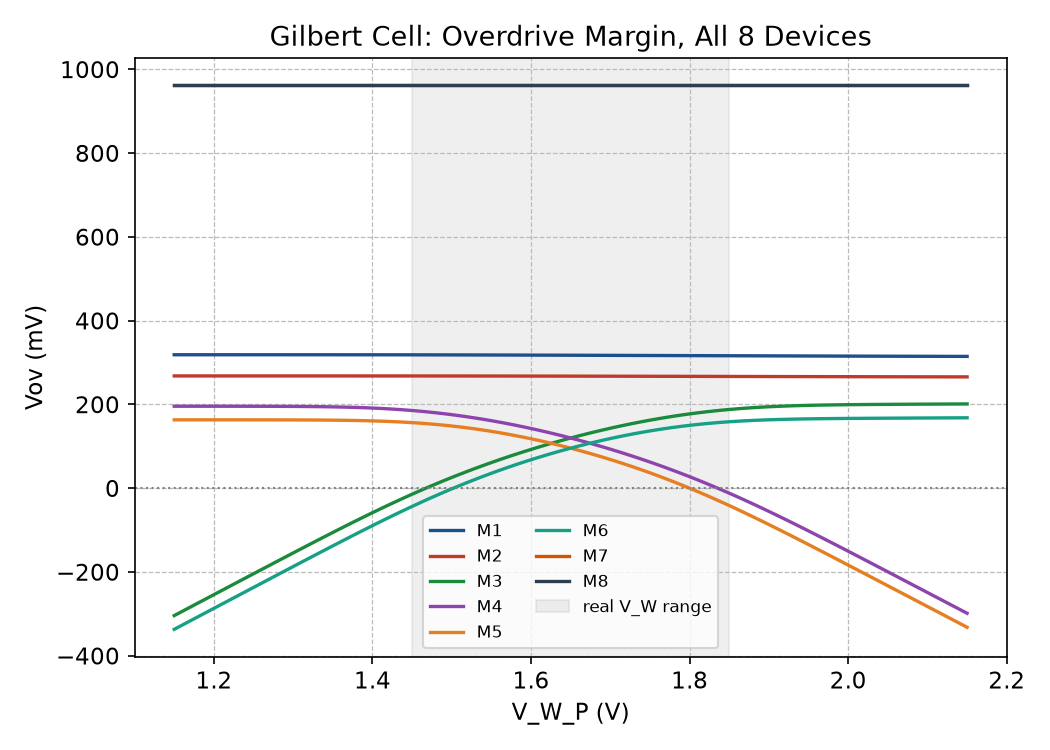
plots/opsweep_generated/opsweep_02_gilbert_vov.png
