valrek-sol/analog-perceptron-gf180mcu/plots/opsweep_generated/opsweep_03_tanh_vov.png

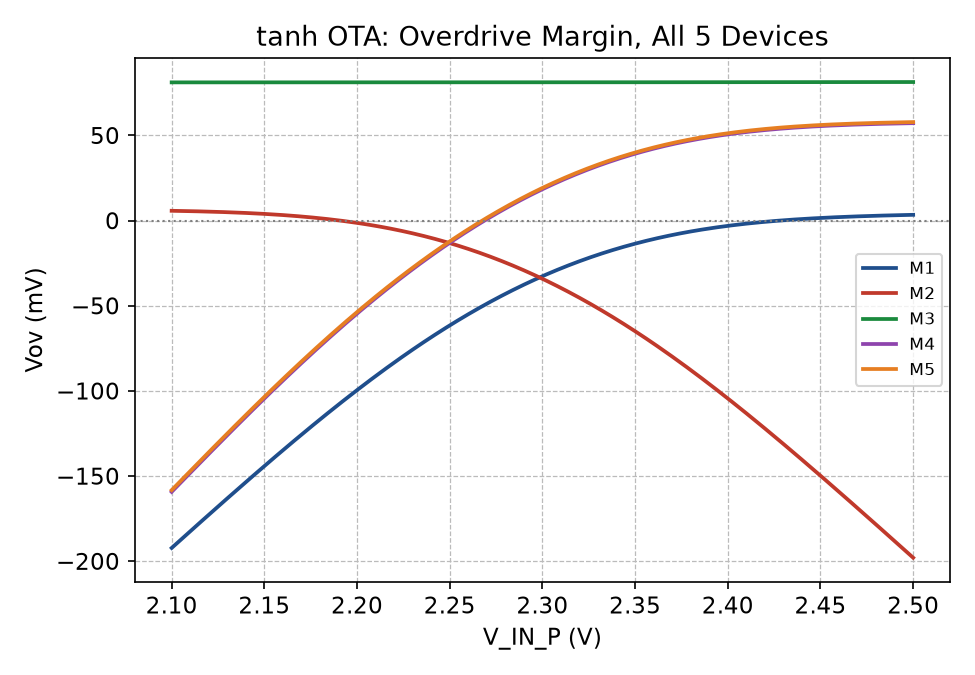
plots/opsweep_generated/opsweep_03_tanh_vov.png
