valrek-sol/analog-perceptron-gf180mcu/plots/opsweep_generated/opsweep_04_chain_vov.png

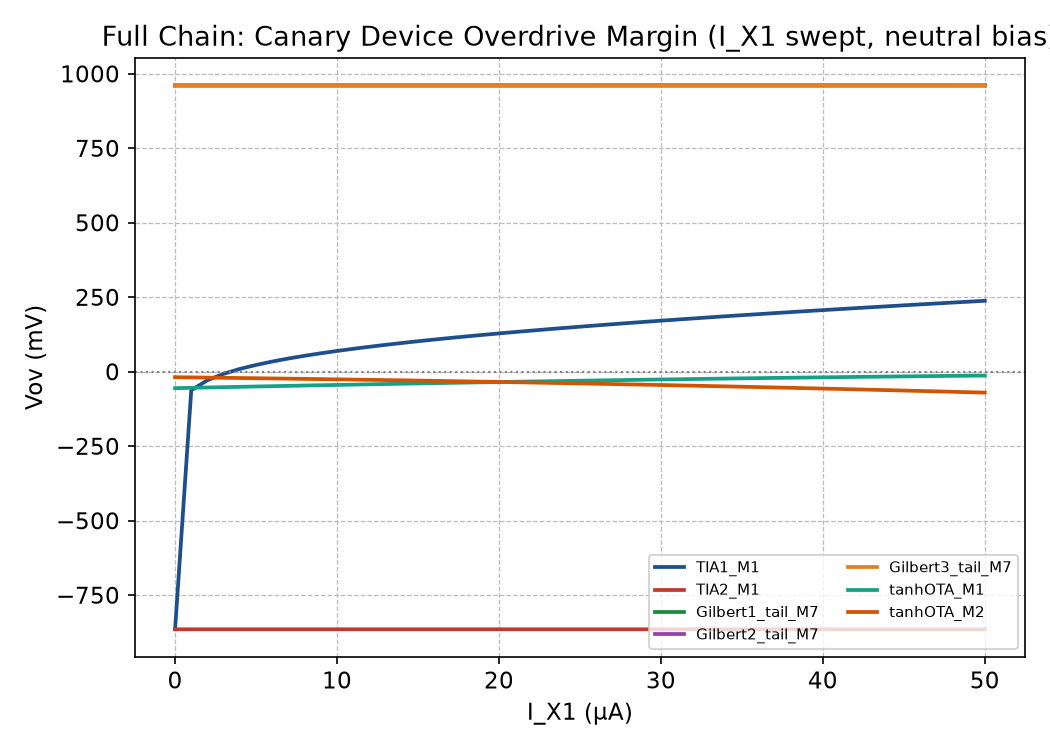
plots/opsweep_generated/opsweep_04_chain_vov.png
