valrek-sol/analog-perceptron-gf180mcu/plots/opsweep_generated/opsweep_05_chain_ix2_vov.png

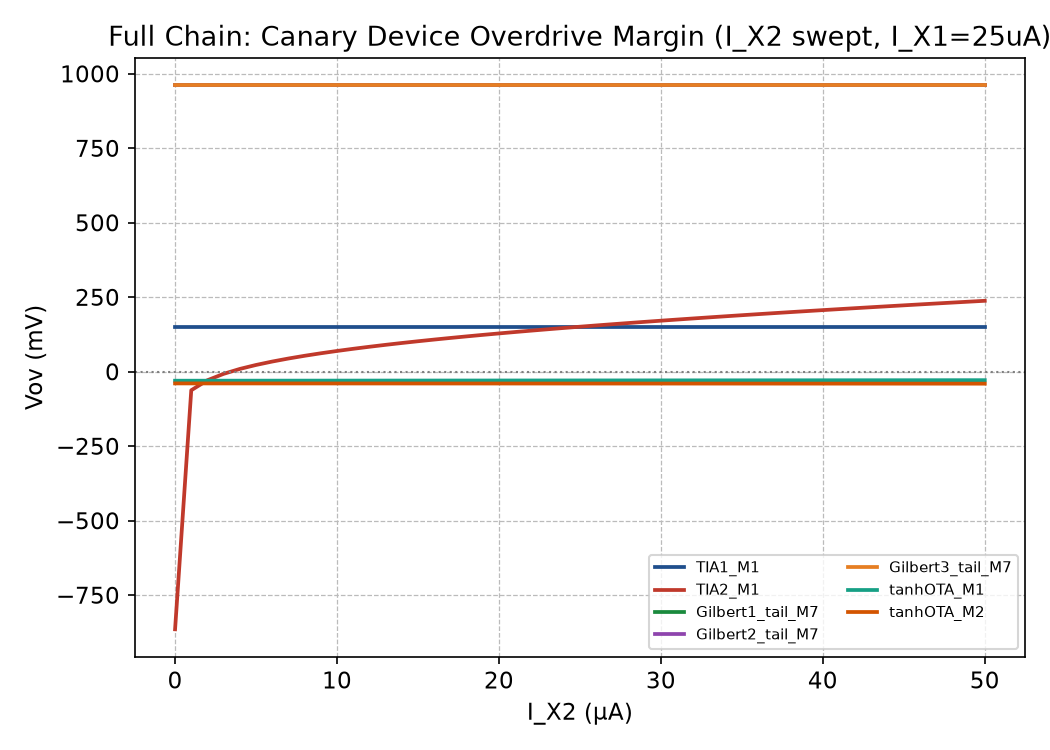
plots/opsweep_generated/opsweep_05_chain_ix2_vov.png
