valrek-sol/analog-perceptron-gf180mcu/plots/plots_generated/01_tia_linear.png

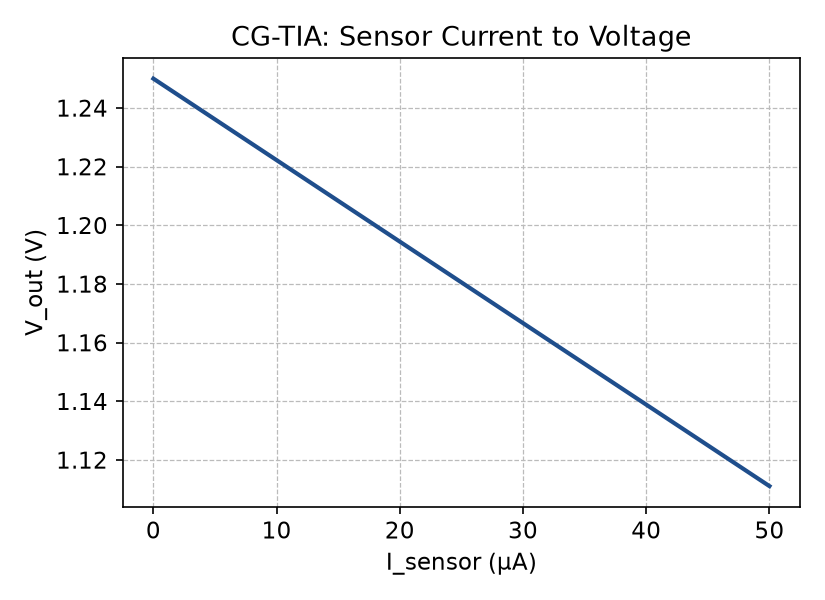
plots/plots_generated/01_tia_linear.png
