valrek-sol/analog-perceptron-gf180mcu/plots/plots_generated/02_gilbert_single.png

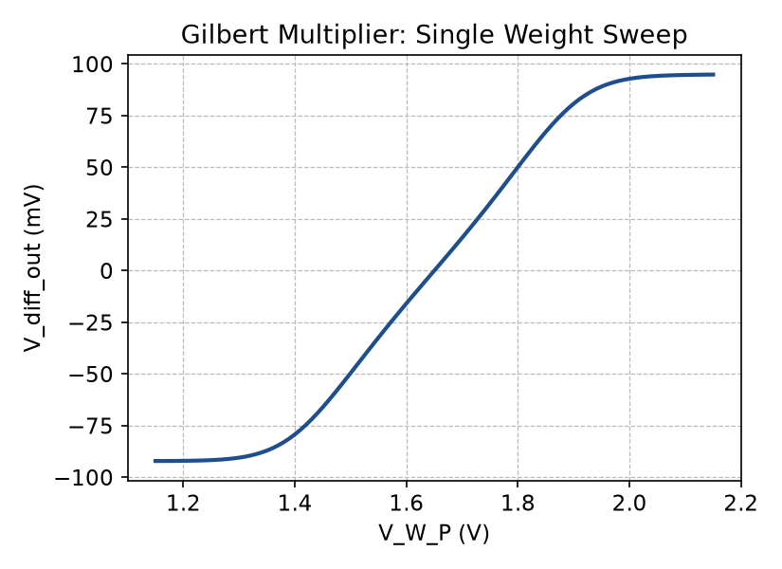
plots/plots_generated/02_gilbert_single.png
