valrek-sol/analog-perceptron-gf180mcu/plots/plots_generated/03_gilbert_family.png

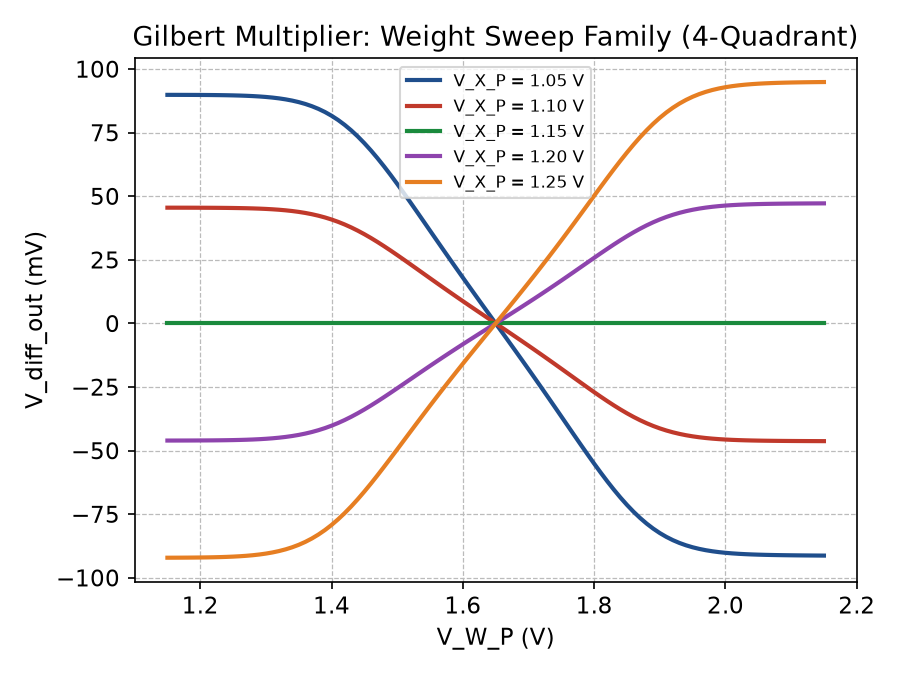
plots/plots_generated/03_gilbert_family.png
