valrek-sol/analog-perceptron-gf180mcu/plots/plots_generated/04_tanh_ota.png

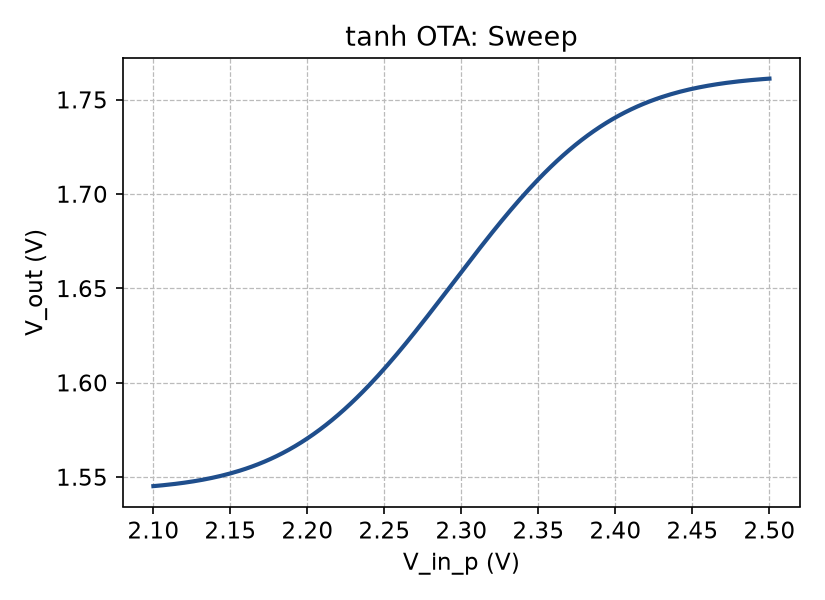
plots/plots_generated/04_tanh_ota.png
