valrek-sol/analog-perceptron-gf180mcu/plots/plots_generated_real/02_real_ac_response.png

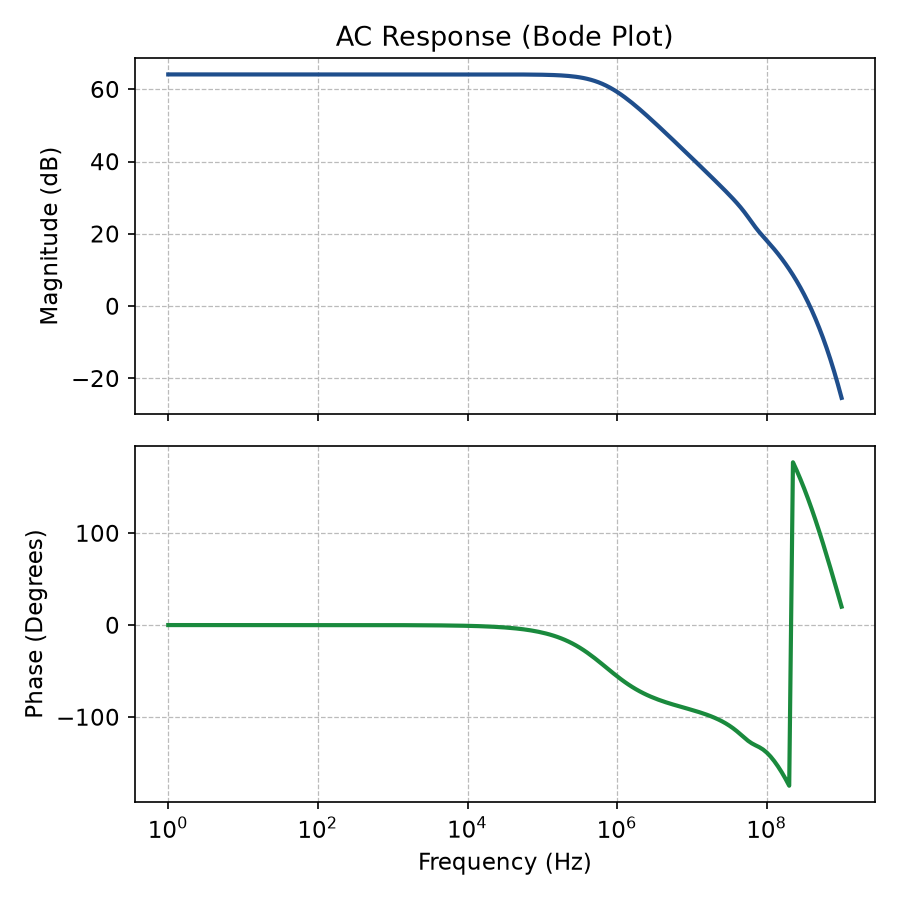
plots/plots_generated_real/02_real_ac_response.png
