valrek-sol/analog-perceptron-gf180mcu/schematics/diagrams/black_cg_amp_tia.png

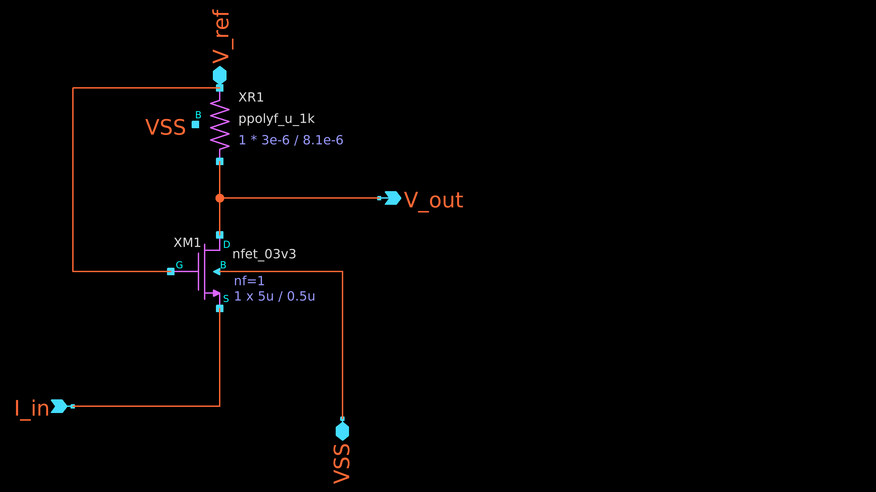
schematics/diagrams/black_cg_amp_tia.png
