valrek-sol/analog-perceptron-gf180mcu/schematics/diagrams/black_gilbert_multiplier_current.png

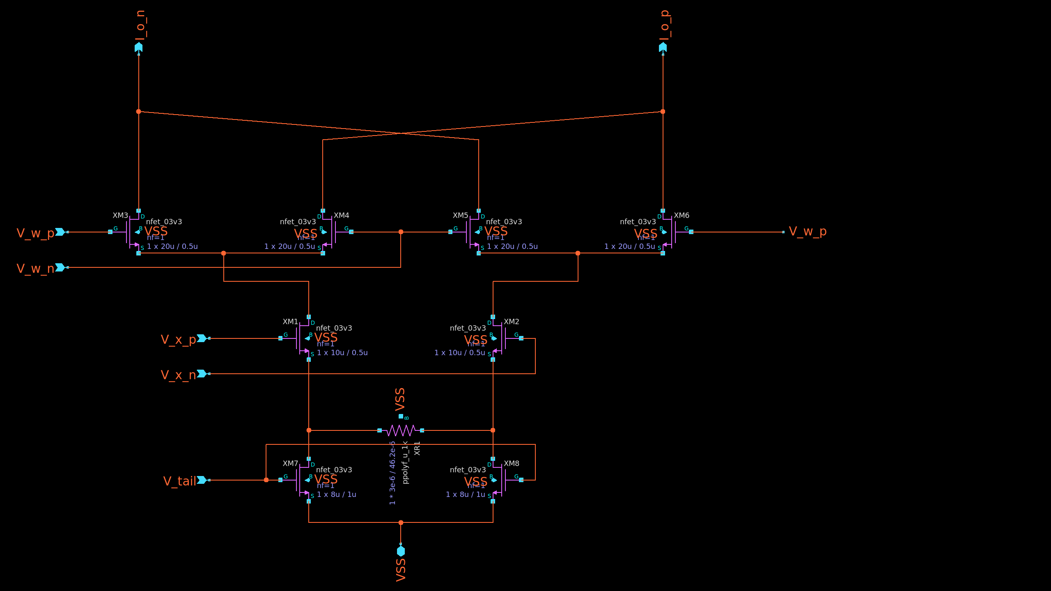
schematics/diagrams/black_gilbert_multiplier_current.png
