valrek-sol/analog-perceptron-gf180mcu/schematics/diagrams/black_perceptron.png

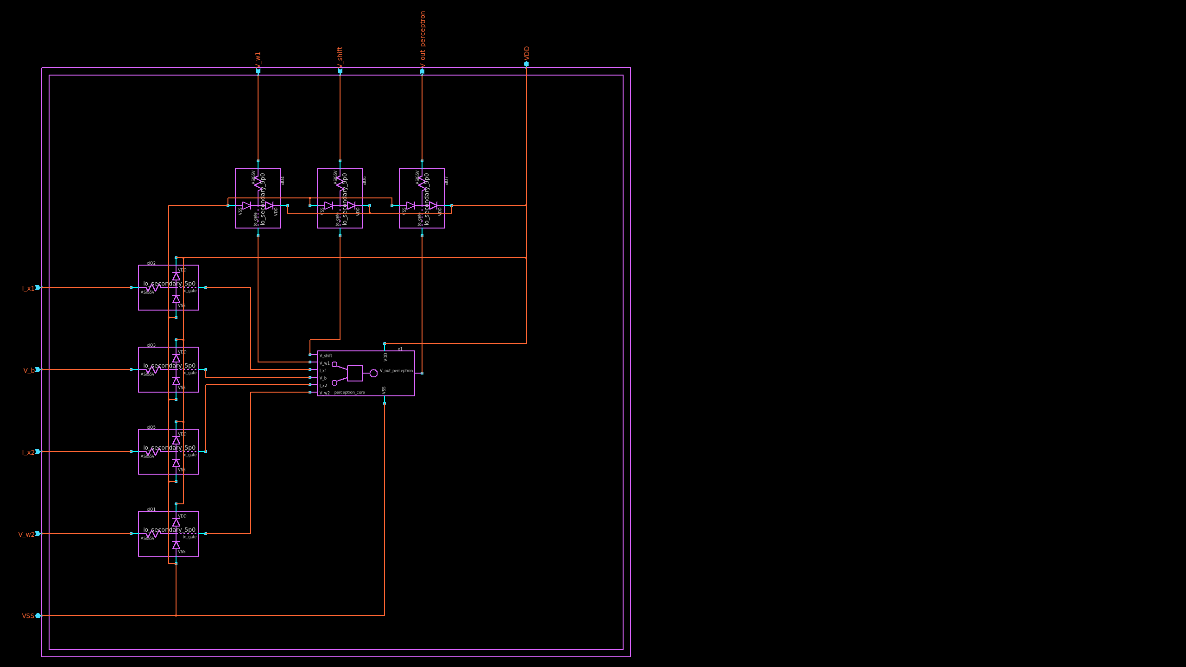
schematics/diagrams/black_perceptron.png
