valrek-sol/analog-perceptron-gf180mcu/schematics/diagrams/black_perceptron_core.png

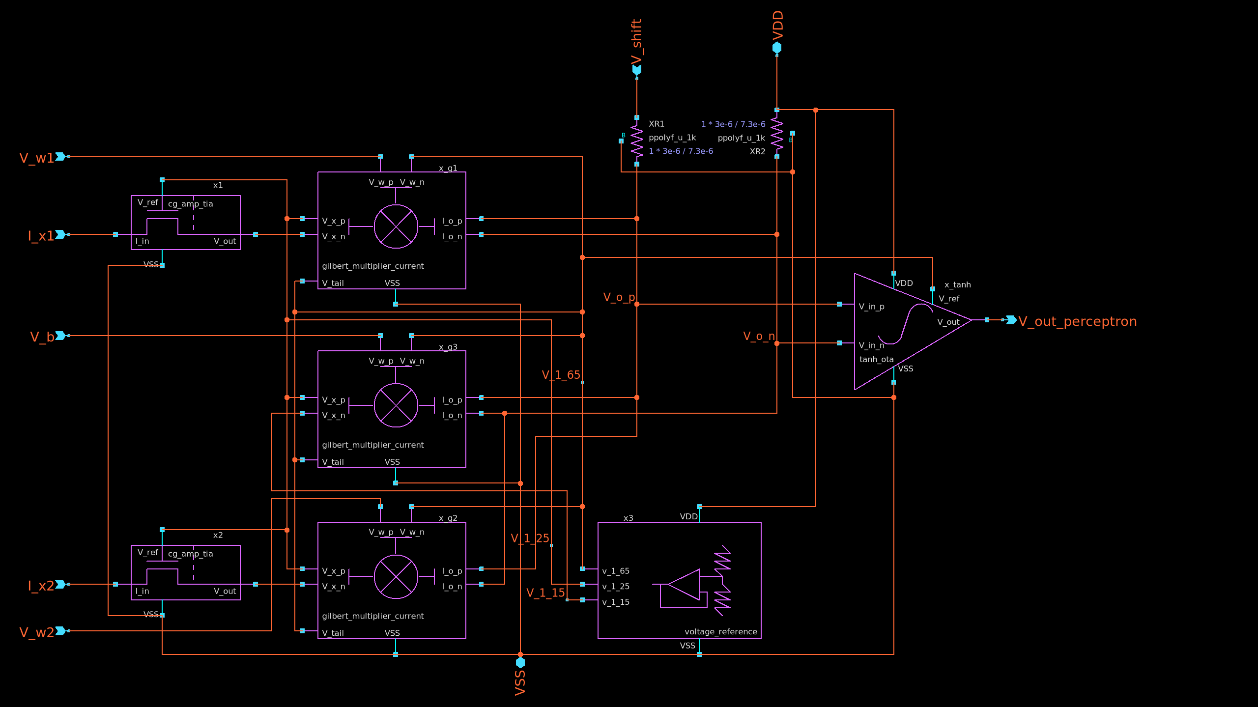
schematics/diagrams/black_perceptron_core.png
