valrek-sol/analog-perceptron-gf180mcu/schematics/diagrams/black_tanh_ota.png

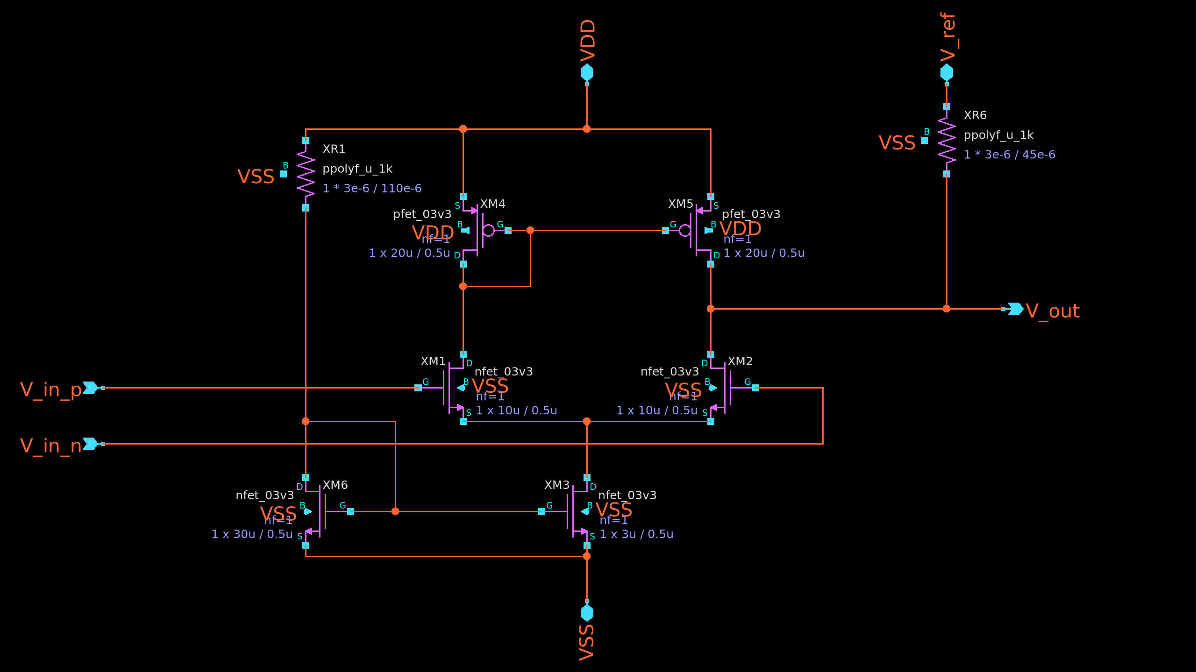
schematics/diagrams/black_tanh_ota.png
