valrek-sol/analog-perceptron-gf180mcu/schematics/diagrams/black_voltage_reference.png

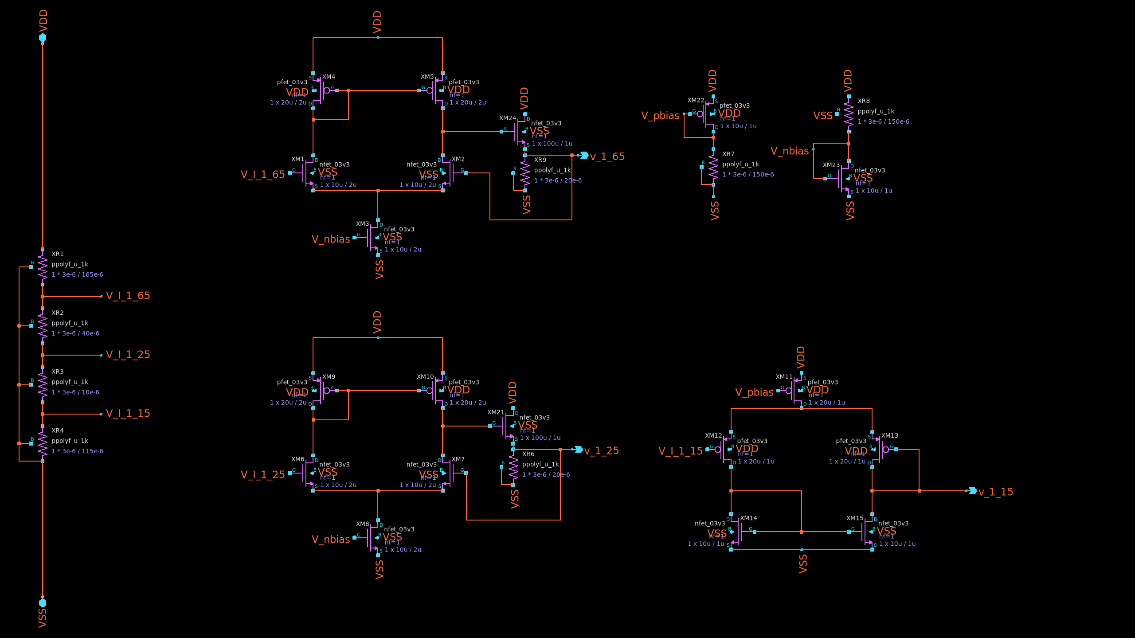
schematics/diagrams/black_voltage_reference.png
