valrek-sol/analog-perceptron-gf180mcu/schematics/diagrams/cg_amp_tia.png

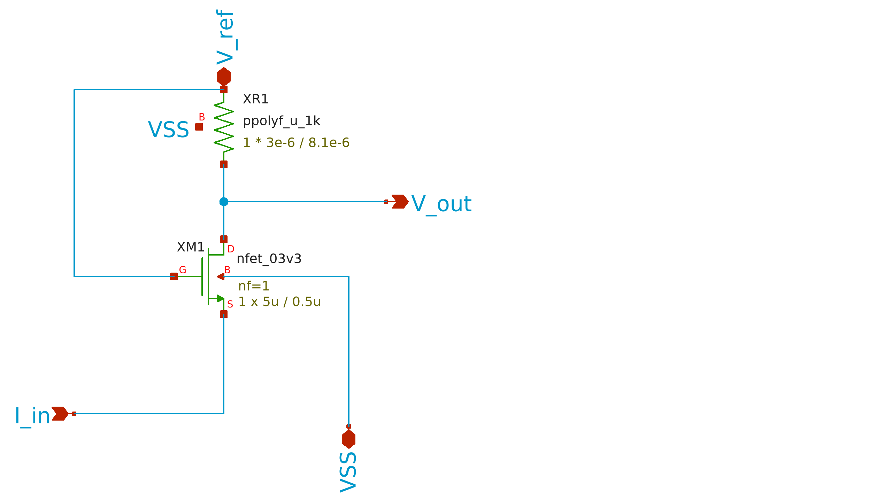
schematics/diagrams/cg_amp_tia.png
