valrek-sol/analog-perceptron-gf180mcu/schematics/diagrams/gilbert_multiplier_current.png

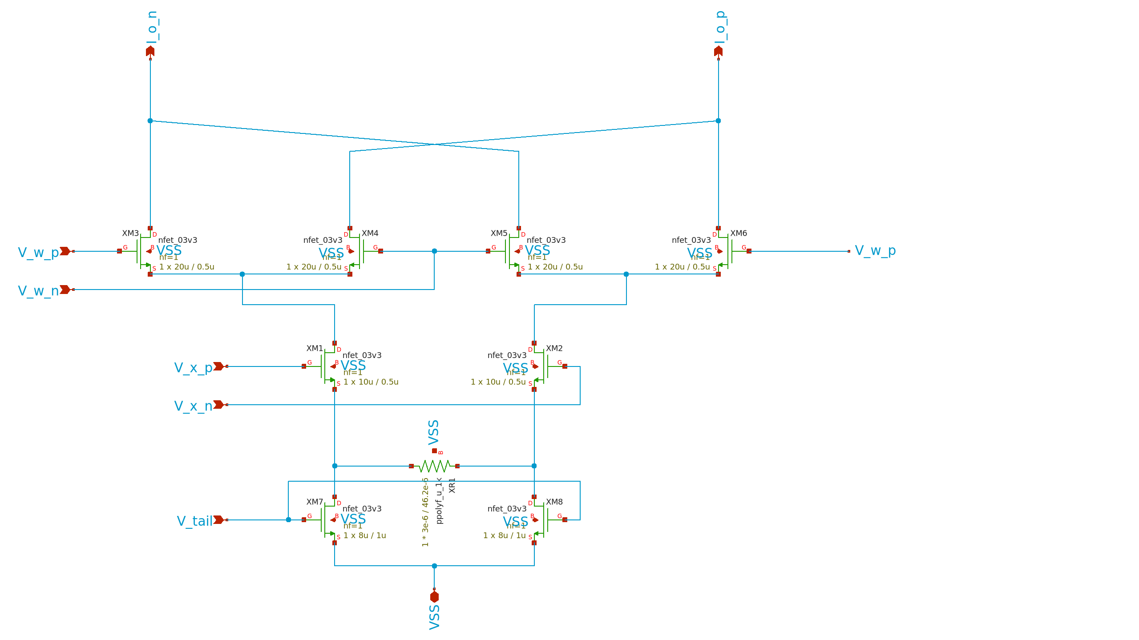
schematics/diagrams/gilbert_multiplier_current.png
