valrek-sol/analog-perceptron-gf180mcu/schematics/diagrams/perceptron.png

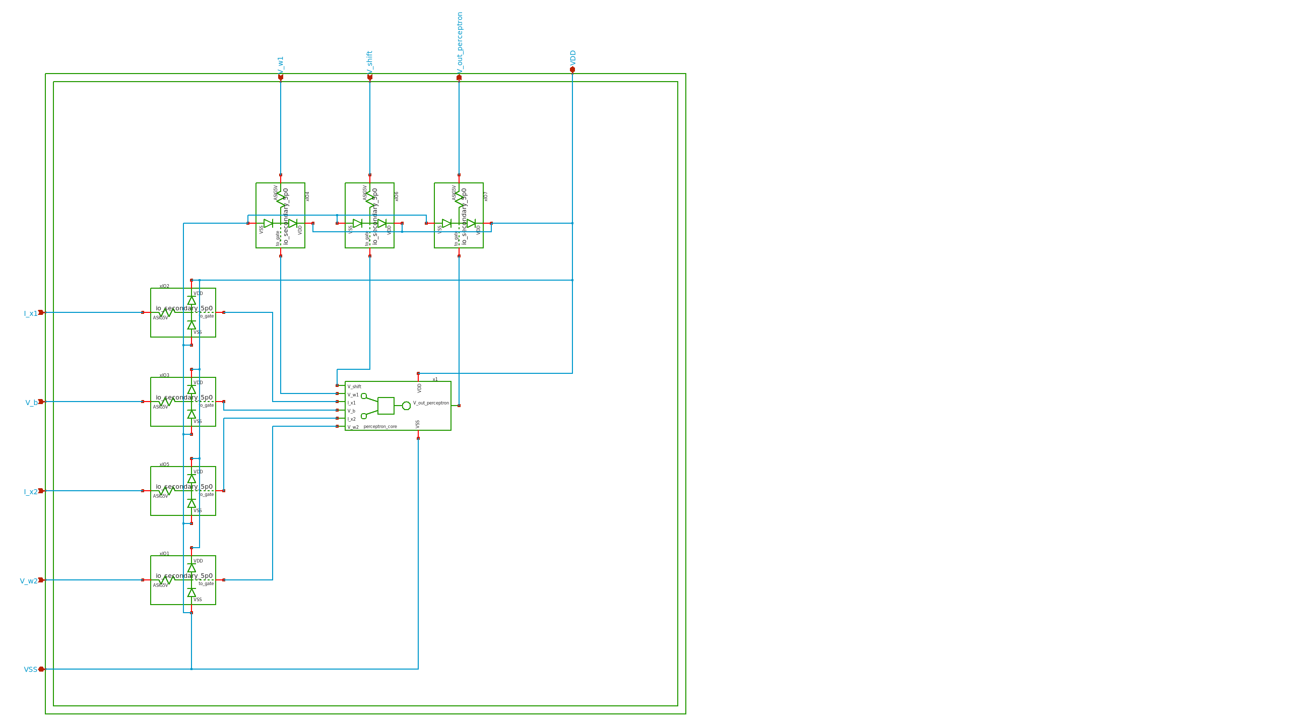
schematics/diagrams/perceptron.png
