valrek-sol/analog-perceptron-gf180mcu/schematics/diagrams/perceptron_core.png

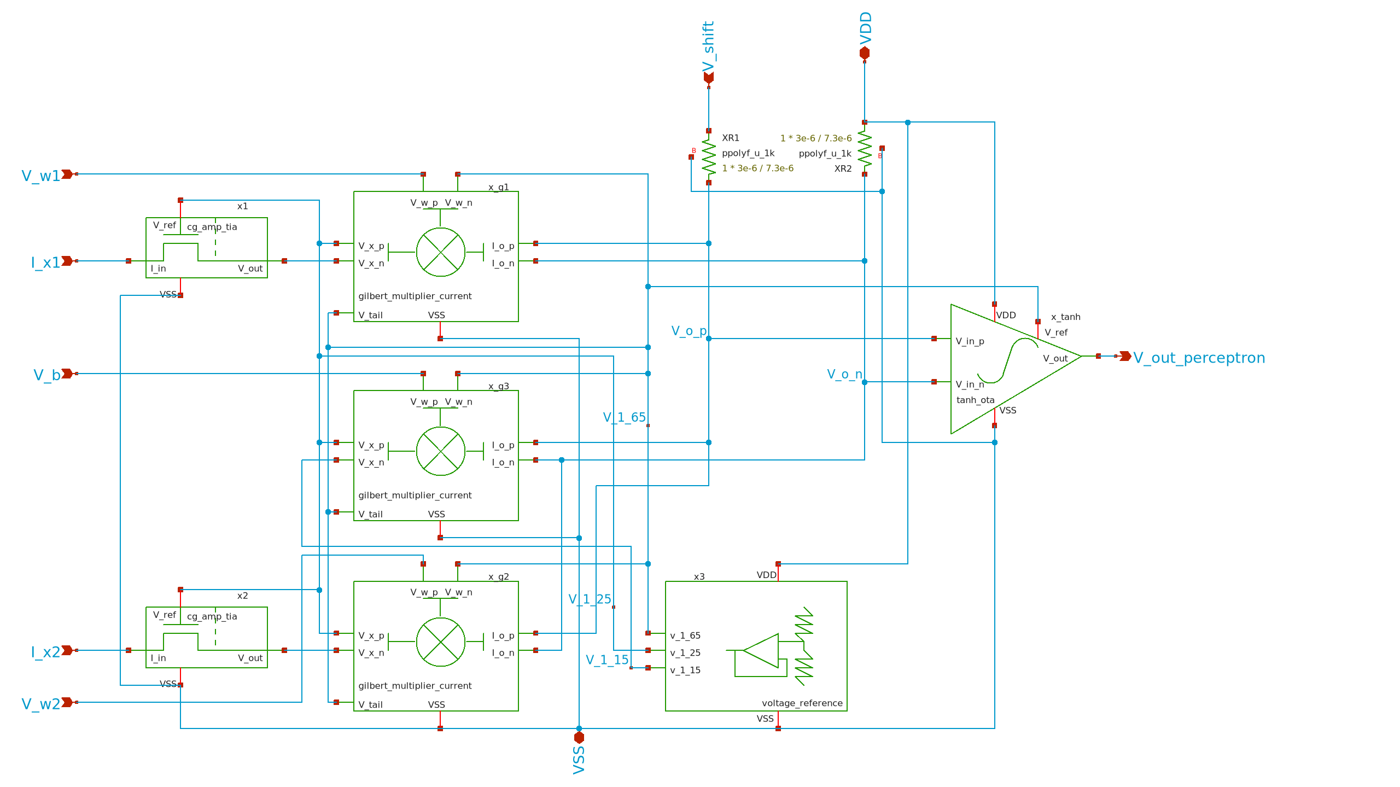
schematics/diagrams/perceptron_core.png
