valrek-sol/analog-perceptron-gf180mcu/schematics/diagrams/tanh_ota.png

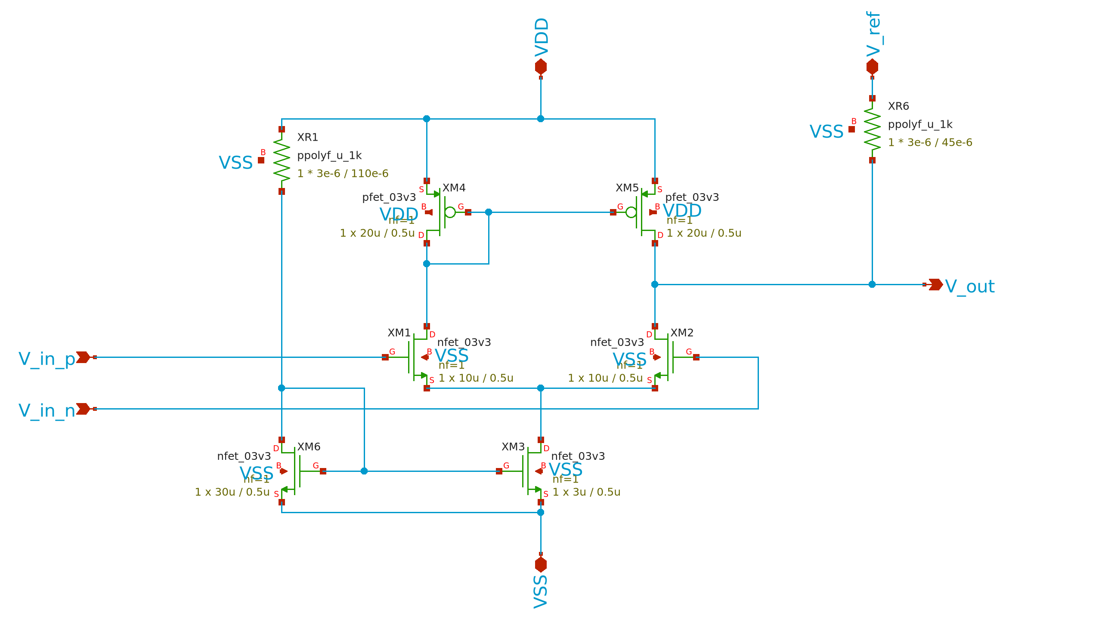
schematics/diagrams/tanh_ota.png
