valrek-sol/analog-perceptron-gf180mcu/schematics/diagrams/voltage_reference.png

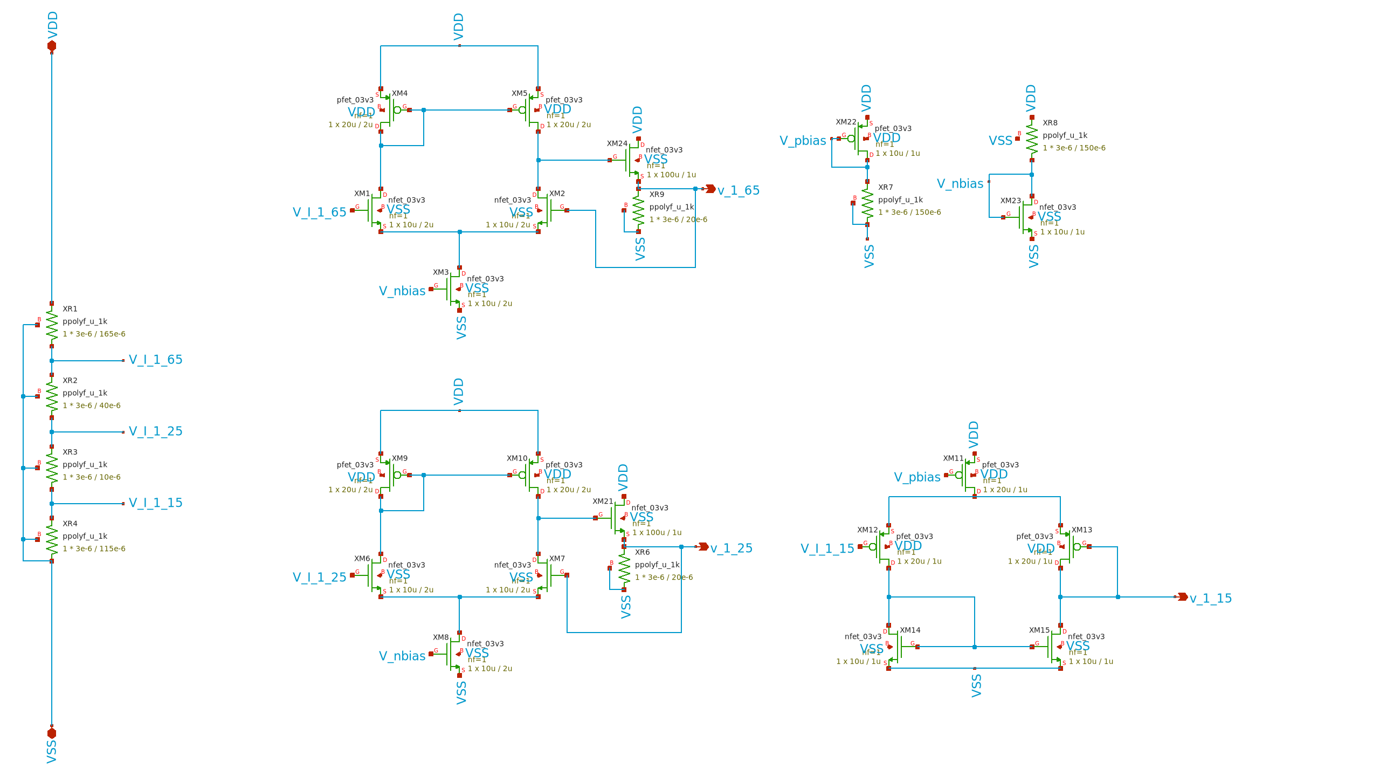
schematics/diagrams/voltage_reference.png
