valrek-sol/analog-perceptron-gf180mcu/schematics/diagrams/perceptron.pdf

# analog-perceptron-gf180mcu/schematics/perceptron.sch

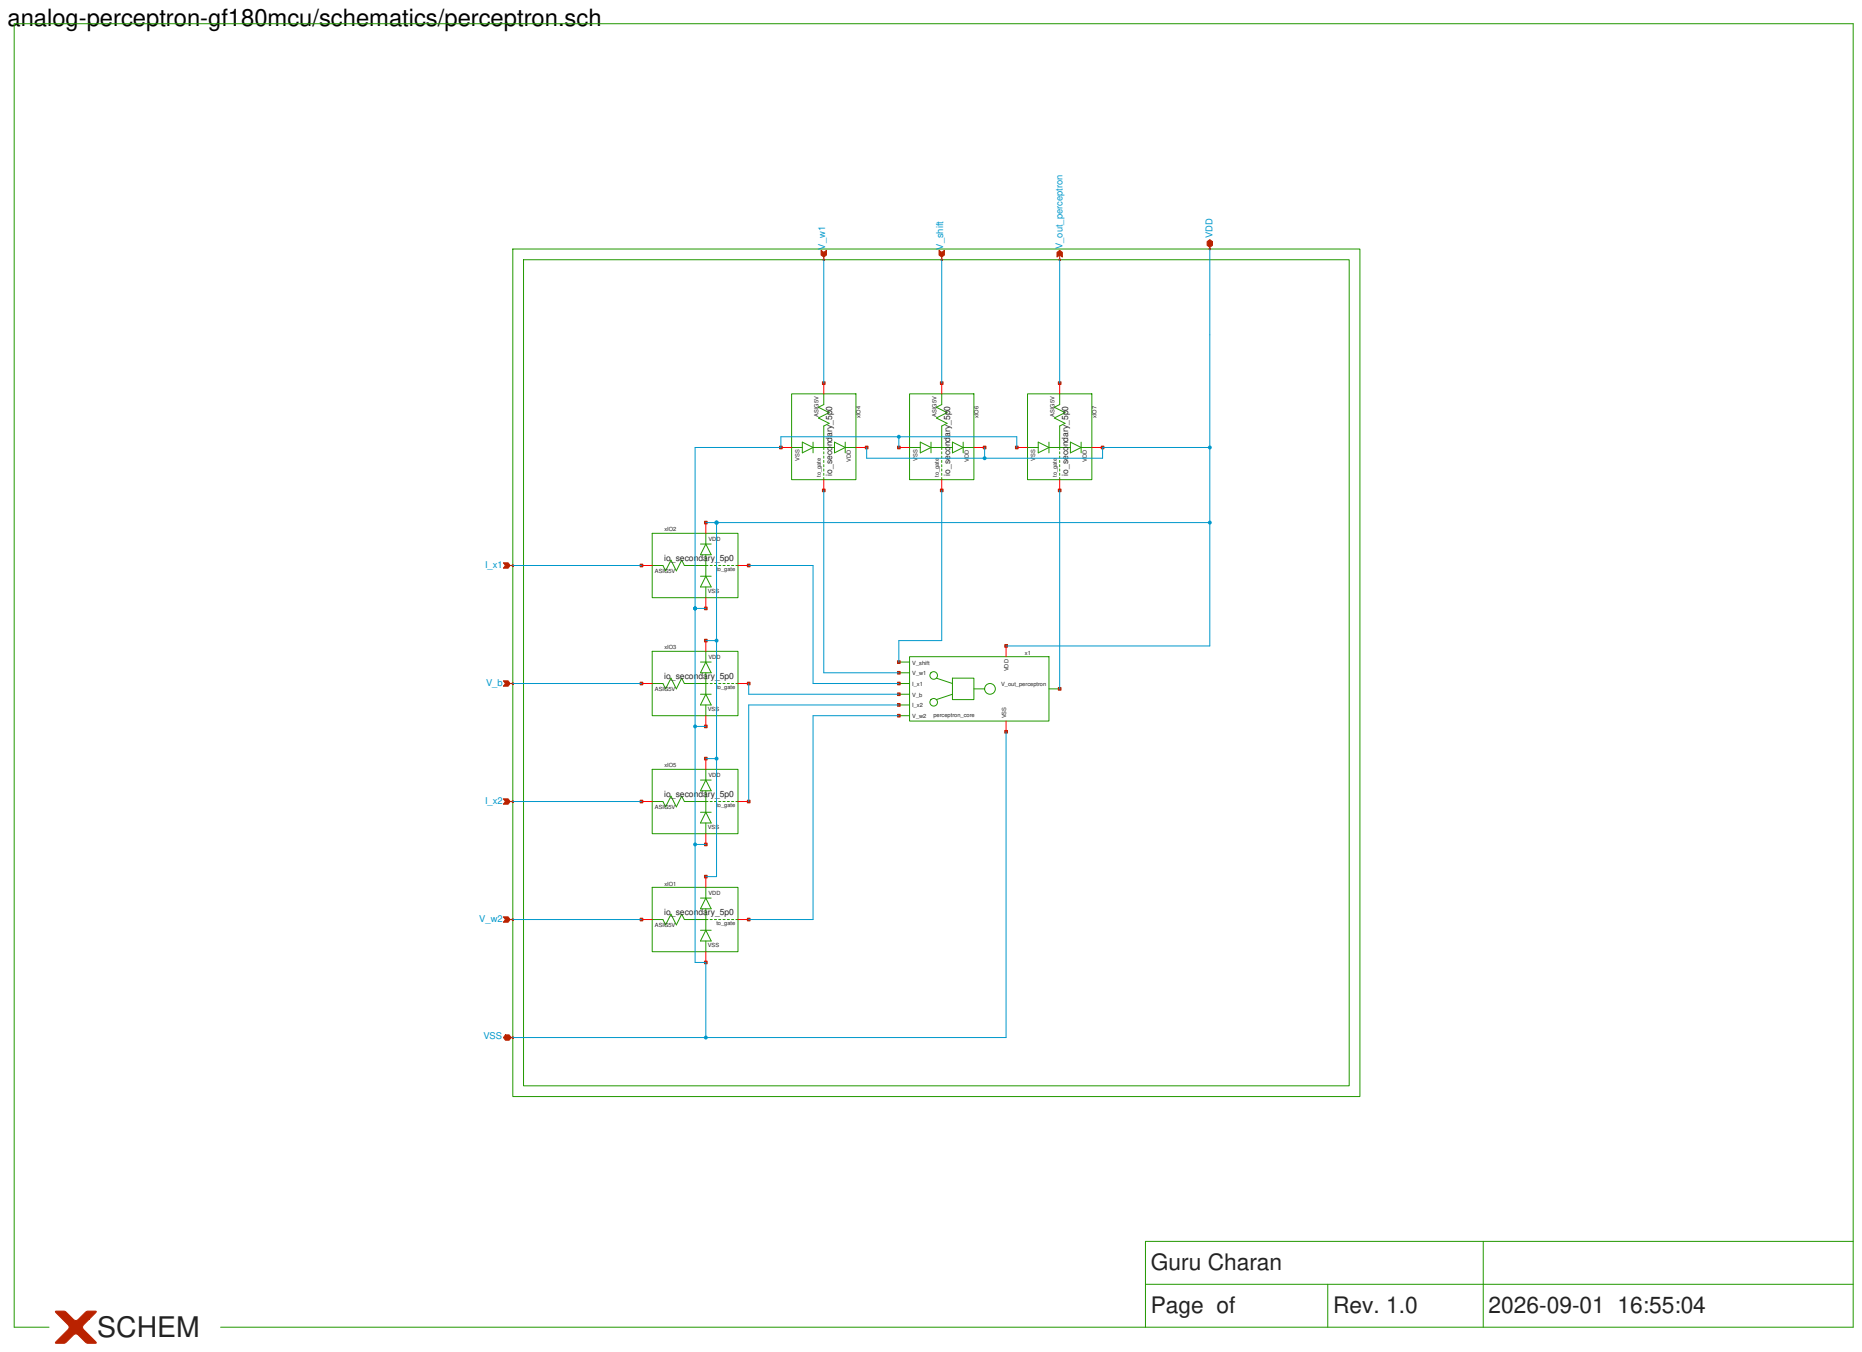
[picture p84: page 1]
perceptron_core; VDD; V_shift; V_out_perceptron; VSS; to_gate ASIG5V; io_secondary_5p0; xIO5; xIO1; xIO2; xIO3; xIO4; xIO6; xIO7; Guru Charan; Page of; Rev. 1.0; SCHEM

# analog-perceptron-gf180mcu/schematics/perceptron_core.sch

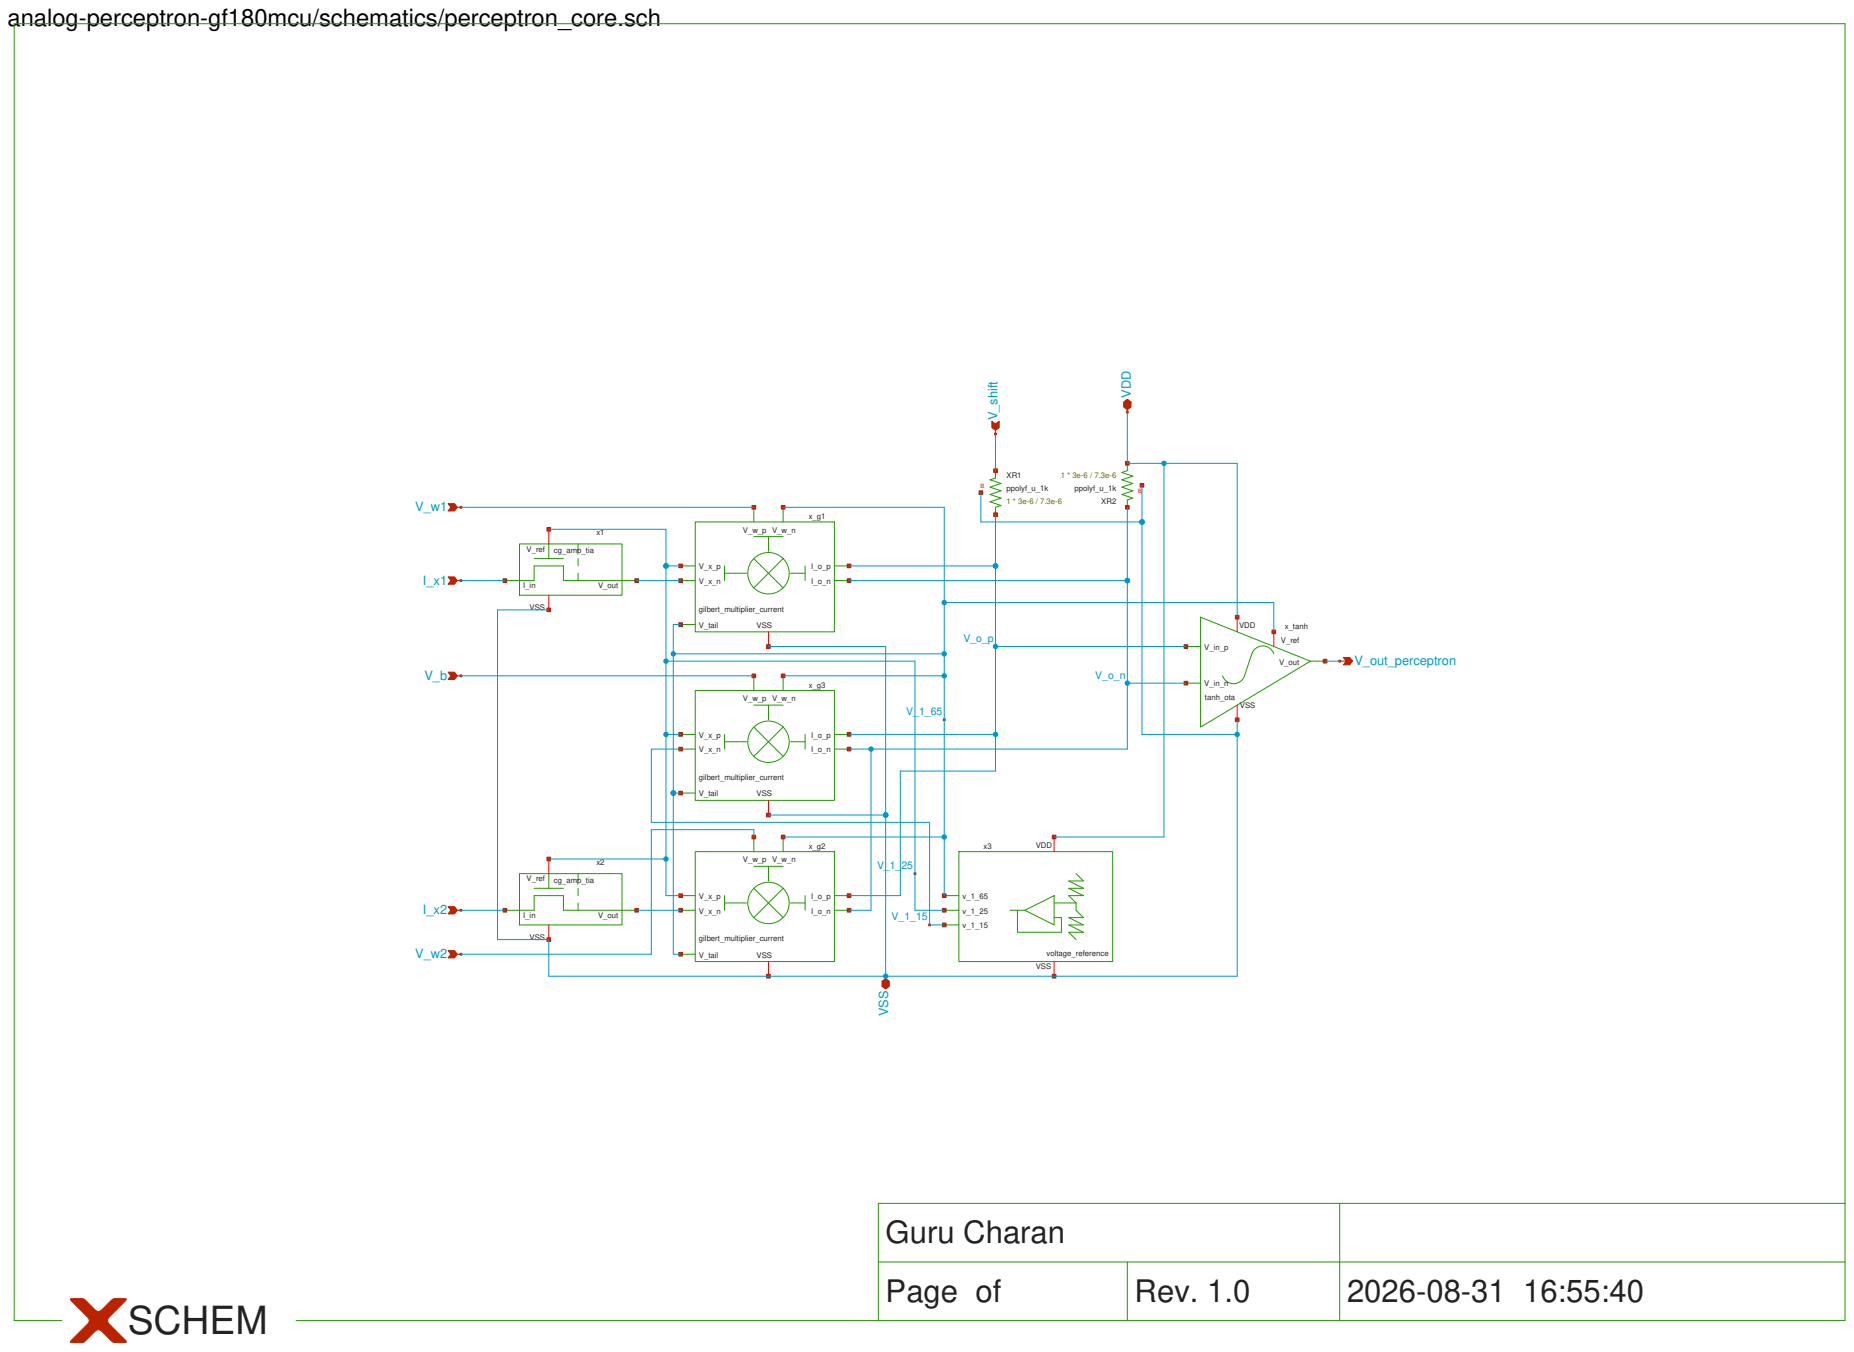
[picture p85: page 2]
gilbert_multiplier_current; V_tail; VSS; tanh_ota; VDD; x_tanh; V_ref; V_out; ppolyf_u_1k B; V_out_perceptron; ppolyf_u_1k; V_shift; voltage_reference; cg_amp_tia; V_outI_in; Guru Charan

# analog-perceptron-gf180mcu/schematics/io_secondary_5p0.sch

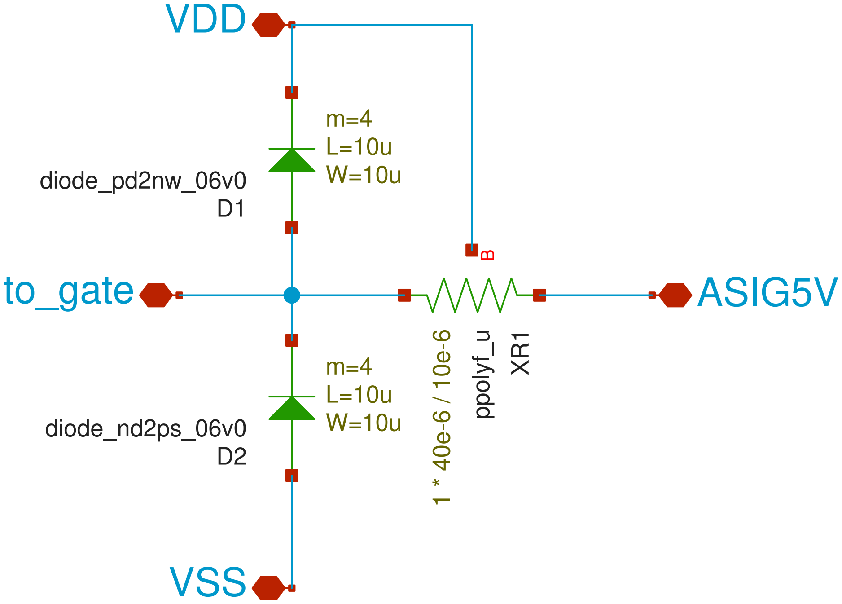
[picture p86: figure]
diode_pd2nw_06v0; ppolyf_u; VSS; VDD; to_gate; ASIG5V; diode_nd2ps_06v0

# analog-perceptron-gf180mcu/schematics/gilbert_multiplier_current.sch

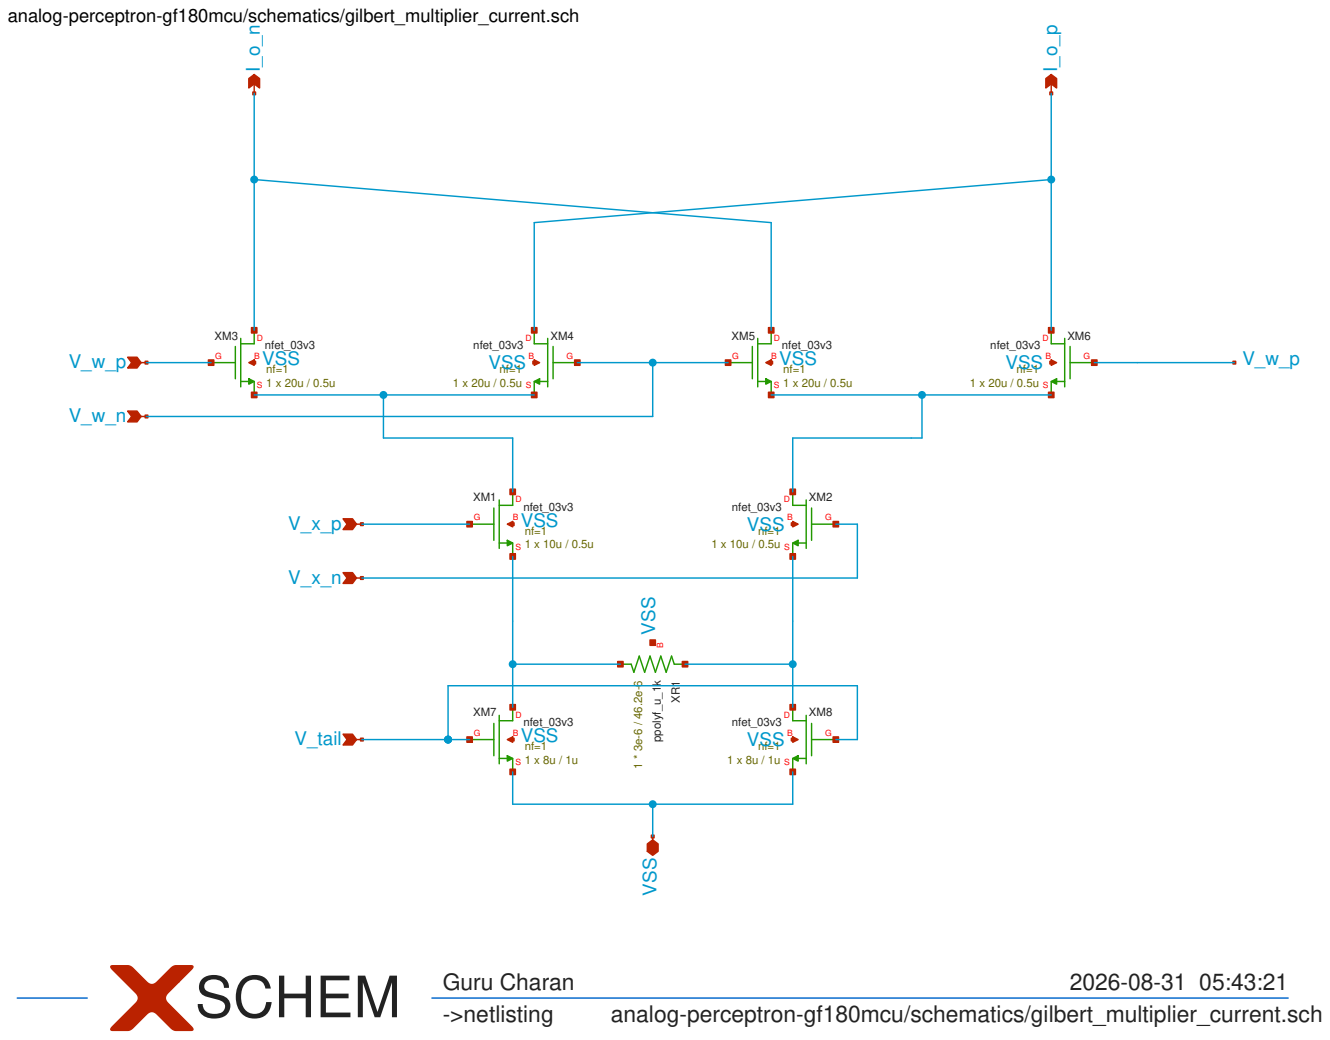
[picture p87: page 4]
nfet_03v3; V_tail; VSS; ppolyf_u_1k B; VSS VSS; ->netlisting; analog-perceptron-gf180mcu/schematics/gilbert_multiplier_current.sch; Guru Charan; 2026-08-31 05:43:21 SCHEM

# analog-perceptron-gf180mcu/schematics/tanh_ota.sch

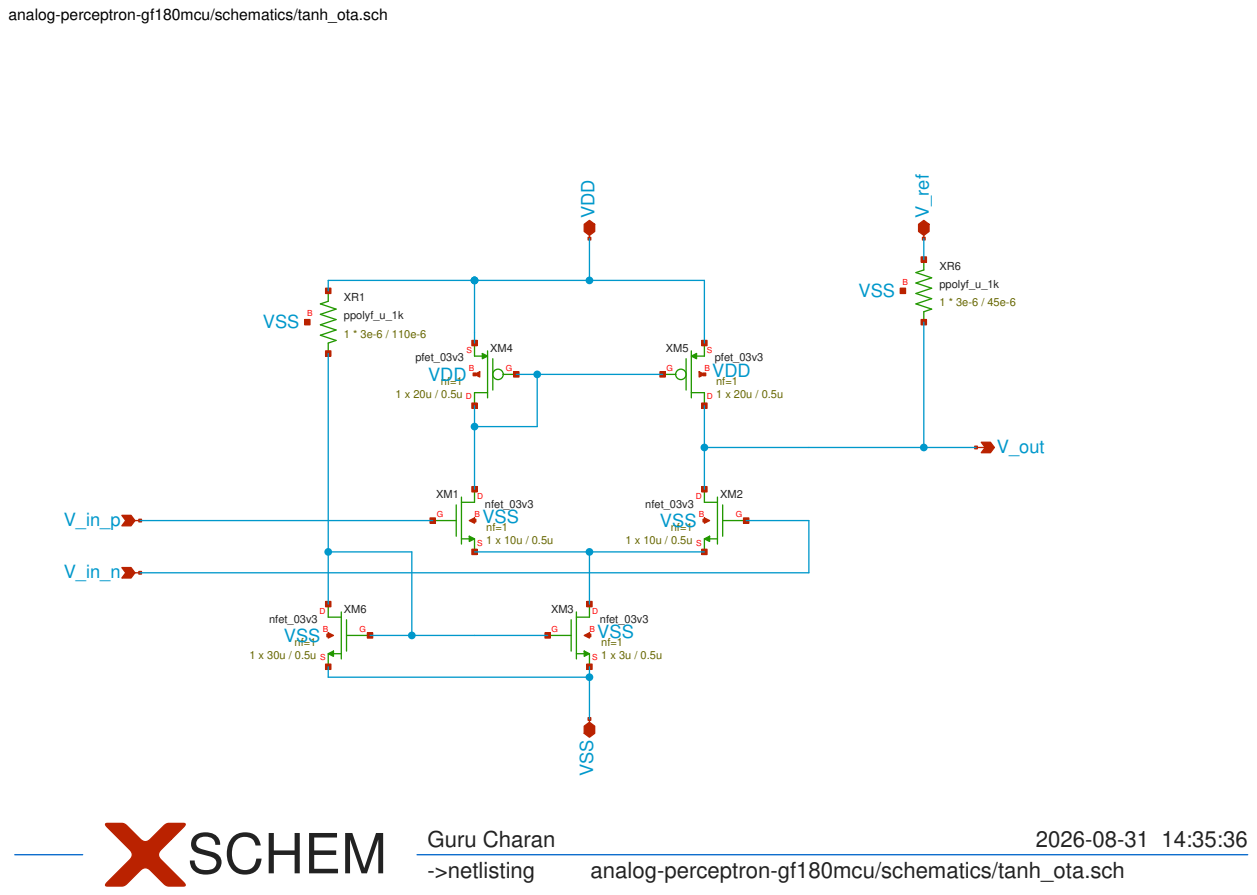
[picture p88: page 5]
nfet_03v3; pfet_03v3; VDD VSS; VSS; VDD; V_out; V_ref; ppolyf_u_1k B; ->netlisting; analog-perceptron-gf180mcu/schematics/tanh_ota.sch; Guru Charan; 2026-08-31 14:35:36 SCHEM

# analog-perceptron-gf180mcu/schematics/voltage_reference.sch

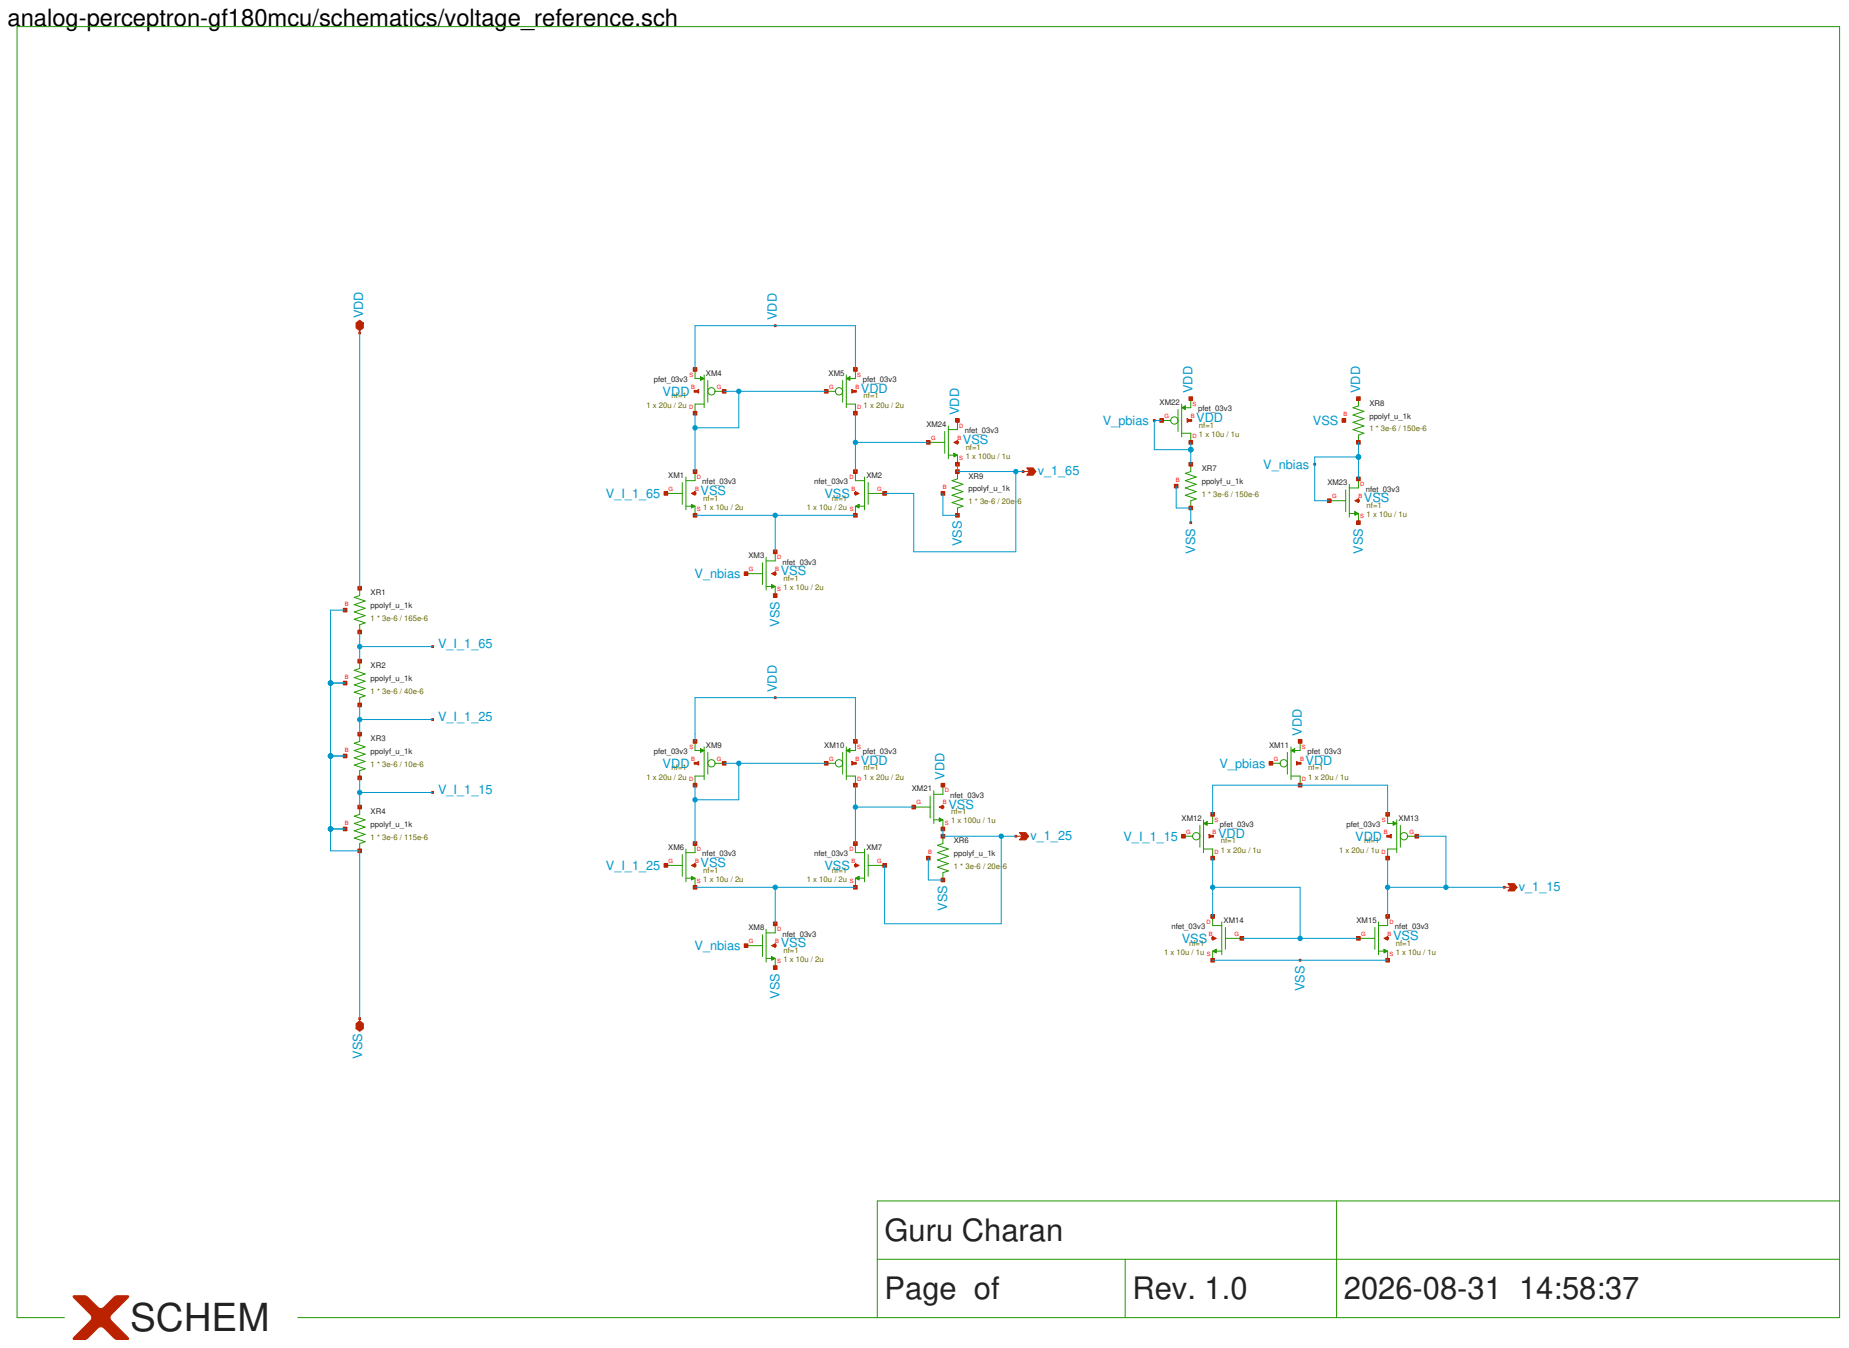
[picture p89: page 6]
ppolyf_u_1k B; VDD VSS; pfet_03v3; nfet_03v3; VDD; VSS; VSS VDD; V_pbias; V_nbias; VSS VSS; Guru Charan

# analog-perceptron-gf180mcu/schematics/cg_amp_tia.sch

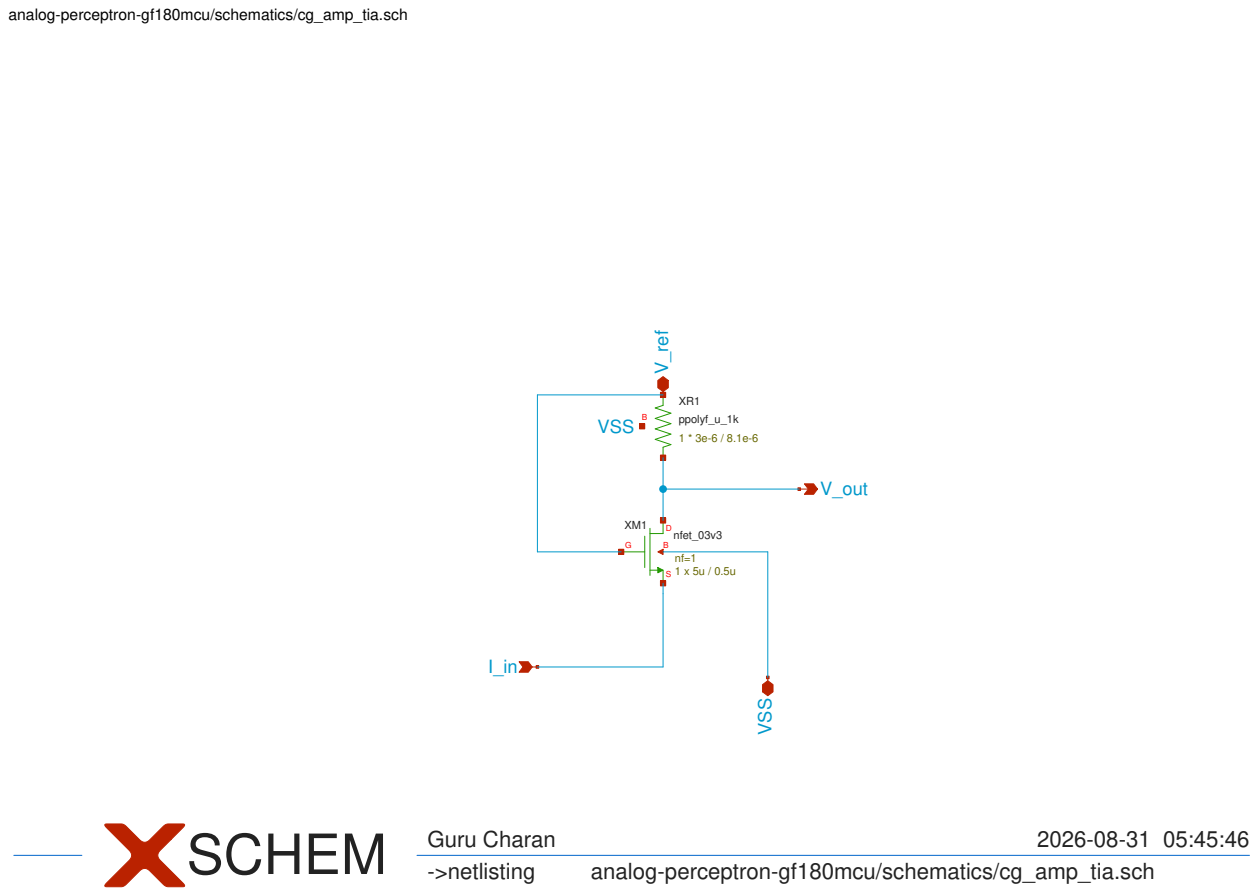
[picture p90: page 7]
nfet_03v3; ppolyf_u_1k B; V_ref; VSS; V_out; ->netlisting; analog-perceptron-gf180mcu/schematics/cg_amp_tia.sch; Guru Charan; 2026-08-31 05:45:46 SCHEM
