valrek-sol/analog-perceptron-gf180mcu/lvs/spice/tb_realistic_perceptron_core.spice

** sch_path: /foss/designs/analog-perceptron-gf180mcu/lvs/schematics/tb_realistic_perceptron_core.sch
.subckt tb_realistic_perceptron_core

V_SUPPLY net7 0 3.3
V_Shift net1 0 3.3
Cs1 net5 0 70p
Cs2 net3 0 70p
Cl net7 0 50p
Rl net7 0 1M
I_X1 net3 0 25u
I_X2 net5 0 25u
V_W1 net2 0 1.85
V_W2 net6 0 1.65
V_B net4 0 1.65
x1 net7 net1 net2 net3 V_out_perceptron net4 net5 net6 0 perceptron_core
**** begin user architecture code


.control
  * --- start from neutral ---
  alter V_W1 = 1.65
  alter V_W2 = 1.65
  alter V_B  = 1.65
  alter I_X1 = 0
  alter I_X2 = 0

  * === Transient Analysis ===
  * Applying a 50uA pulse to I_X1 to observe step response and settling
  alter @I_X1[pulse] = [ 0 50u 1u 10n 10n 10u 20u ]
  alter I_X2 = 0
  alter V_W1 = 1.85
  alter V_W2 = 1.65
  alter V_B  = 1.65
  tran 10n 30u
  wrdata /foss/designs/analog-perceptron-gf180mcu/plots/real_tran_perceptron.txt v(V_out_perceptron)
  alter @I_X1[pulse] = [ 0 0 0 0 0 0 0 ] $ Clear pulse after tran

  * === AC Analysis (Stability & Bandwidth) ===
  * Injecting AC signal into I_X1
  alter I_X1 = 25u
  alter @I_X1[acmag] = 1
  alter V_W1 = 1.85
  ac dec 20 1 1G
  * wrdata exports real and imaginary parts for AC.
  wrdata /foss/designs/analog-perceptron-gf180mcu/plots/real_ac_perceptron.txt v(V_out_perceptron)
  alter @I_X1[acmag] = 0 $ Clear AC magnitude
  alter I_X1 = 0

  * === Return to global environment before loops ===
  reset
  setplot const

  * === Graph 1: Weight sweep (inhibitory / neutral / excitatory) ===
  alter I_X2 = 0
  alter V_W2 = 1.65
  alter V_B  = 1.65
  let n = 0
  dowhile n <= 2
    let vw1 = 1.45 + n * 0.2
    alter V_W1 = vw1
    dc I_X1 0 50u 1u
    wrdata /foss/designs/analog-perceptron-gf180mcu/plots/real_perceptron_graph1_weights.txt v(V_out_perceptron)
    set appendwrite
    let n = n + 1
  end
  unset appendwrite
  alter V_W1 = 1.65

  * === Graph 2: Sensor 1 sweep, Sensor 2 interference ===
  alter V_W1 = 1.85
  alter V_W2 = 1.85
  alter V_B  = 1.65
  let n = 0
  dowhile n <= 2
    let ix2 = n * 25u
    alter I_X2 = ix2
    dc I_X1 0 50u 1u
    wrdata /foss/designs/analog-perceptron-gf180mcu/plots/real_perceptron_graph2_sensors.txt v(V_out_perceptron)
    set appendwrite
    let n = n + 1
  end
  unset appendwrite
  alter V_W1 = 1.65
  alter V_W2 = 1.65
  alter I_X2 = 0

  * === Graph 3: Bias shifting ===
  alter I_X2 = 0
  alter V_W1 = 1.85
  let n = 0
  dowhile n <= 2
    let vb = 1.45 + n * 0.2
    alter V_B = vb
    dc I_X1 0 50u 1u
    wrdata /foss/designs/analog-perceptron-gf180mcu/plots/real_perceptron_graph3_bias.txt v(V_out_perceptron)
    set appendwrite
    let n = n + 1
  end
  unset appendwrite
  alter V_W1 = 1.65
  alter V_B  = 1.65

  * === Graph 4: V_Shift sweep (reference-rail sensitivity / corner check) ===
  alter I_X2 = 0
  alter V_W1 = 1.85
  alter V_B  = 1.65
  let n = 0
  dowhile n <= 5
    let vshift = 3.25 + n * 0.02
    alter V_Shift = vshift
    dc I_X1 0 50u 1u
    wrdata /foss/designs/analog-perceptron-gf180mcu/plots/real_perceptron_graph4_vshift.txt v(V_out_perceptron)
    set appendwrite
    let n = n + 1
  end
  unset appendwrite
  alter V_Shift = 3.3
  alter V_W1 = 1.65

  * === 3D Dataset A: I_X1 x I_X2 -> V_out ===
  alter V_W1 = 1.85
  alter V_W2 = 1.85
  alter V_B  = 1.65
  let n = 0
  dowhile n <= 25
    let ix2b = n * 2u
    alter I_X2 = ix2b
    dc I_X1 0 50u 1u
    wrdata /foss/designs/analog-perceptron-gf180mcu/plots/real_3d_sensors.txt v(V_out_perceptron)
    set appendwrite
    let n = n + 1
  end
  unset appendwrite
  alter V_W1 = 1.65
  alter V_W2 = 1.65
  alter I_X2 = 0

  * === 3D Dataset B: V_W1 x V_W2 -> V_out ===
  alter I_X1 = 50u
  alter I_X2 = 50u
  alter V_B  = 1.65
  let n = 0
  dowhile n <= 20
    let vw2 = 1.45 + n * 0.02
    alter V_W2 = vw2
    dc V_W1 1.45 1.85 0.01
    wrdata /foss/designs/analog-perceptron-gf180mcu/plots/real_3d_weights.txt v(V_out_perceptron)
    set appendwrite
    let n = n + 1
  end
  unset appendwrite
  alter V_W1 = 1.65
  alter V_W2 = 1.65
  alter V_B  = 1.65
  alter I_X1 = 0
  alter I_X2 = 0

  * === OP-SWEEP DIAGNOSTIC: all devices ===
  alter V_W1 = 1.85
  alter V_W2 = 1.65
  alter V_B  = 1.65
  alter I_X2 = 0
  save all @m.x1.x1.xm1.m0[vgs] @m.x1.x1.xm1.m0[vth] @m.x1.x1.xm1.m0[id] @m.x1.x2.xm1.m0[vgs] @m.x1.x2.xm1.m0[vth] @m.x1.x2.xm1.m0[id] @m.x1.x_g1.xm7.m0[vgs] @m.x1.x_g1.xm7.m0[vth] @m.x1.x_g1.xm7.m0[id] @m.x1.x_g2.xm7.m0[vgs] @m.x1.x_g2.xm7.m0[vth] @m.x1.x_g2.xm7.m0[id] @m.x1.x_g3.xm7.m0[vgs] @m.x1.x_g3.xm7.m0[vth] @m.x1.x_g3.xm7.m0[id] @m.x1.x_tanh.xm1.m0[vgs] @m.x1.x_tanh.xm1.m0[vth] @m.x1.x_tanh.xm1.m0[id] @m.x1.x_tanh.xm2.m0[vgs] @m.x1.x_tanh.xm2.m0[vth] @m.x1.x_tanh.xm2.m0[id]
  dc I_X1 0 50u 1u
  wrdata /foss/designs/analog-perceptron-gf180mcu/plots/real_opsweep_perceptron_chain.txt v(V_out_perceptron) @m.x1.x1.xm1.m0[vgs] @m.x1.x1.xm1.m0[vth] @m.x1.x1.xm1.m0[id] @m.x1.x2.xm1.m0[vgs] @m.x1.x2.xm1.m0[vth] @m.x1.x2.xm1.m0[id] @m.x1.x_g1.xm7.m0[vgs] @m.x1.x_g1.xm7.m0[vth] @m.x1.x_g1.xm7.m0[id] @m.x1.x_g2.xm7.m0[vgs] @m.x1.x_g2.xm7.m0[vth] @m.x1.x_g2.xm7.m0[id] @m.x1.x_g3.xm7.m0[vgs] @m.x1.x_g3.xm7.m0[vth] @m.x1.x_g3.xm7.m0[id] @m.x1.x_tanh.xm1.m0[vgs] @m.x1.x_tanh.xm1.m0[vth] @m.x1.x_tanh.xm1.m0[id] @m.x1.x_tanh.xm2.m0[vgs] @m.x1.x_tanh.xm2.m0[vth] @m.x1.x_tanh.xm2.m0[id]
  alter V_W1 = 1.65
  alter V_W2 = 1.65
  alter V_B  = 1.65
  alter I_X1 = 0
  alter I_X2 = 0

  * === OP-SWEEP DIAGNOSTIC #2: all devices, I_X2 swept ===
  alter V_W1 = 1.85
  alter V_W2 = 1.65
  alter V_B  = 1.65
  alter I_X1 = 25u
  save all @m.x1.x1.xm1.m0[vgs] @m.x1.x1.xm1.m0[vth] @m.x1.x1.xm1.m0[id] @m.x1.x2.xm1.m0[vgs] @m.x1.x2.xm1.m0[vth] @m.x1.x2.xm1.m0[id] @m.x1.x_g1.xm7.m0[vgs] @m.x1.x_g1.xm7.m0[vth] @m.x1.x_g1.xm7.m0[id] @m.x1.x_g2.xm7.m0[vgs] @m.x1.x_g2.xm7.m0[vth] @m.x1.x_g2.xm7.m0[id] @m.x1.x_g3.xm7.m0[vgs] @m.x1.x_g3.xm7.m0[vth] @m.x1.x_g3.xm7.m0[id] @m.x1.x_tanh.xm1.m0[vgs] @m.x1.x_tanh.xm1.m0[vth] @m.x1.x_tanh.xm1.m0[id] @m.x1.x_tanh.xm2.m0[vgs] @m.x1.x_tanh.xm2.m0[vth] @m.x1.x_tanh.xm2.m0[id]
  dc I_X2 0 50u 1u
  wrdata /foss/designs/analog-perceptron-gf180mcu/plots/real_opsweep_perceptron_chain_ix2.txt v(V_out_perceptron) @m.x1.x1.xm1.m0[vgs] @m.x1.x1.xm1.m0[vth] @m.x1.x1.xm1.m0[id] @m.x1.x2.xm1.m0[vgs] @m.x1.x2.xm1.m0[vth] @m.x1.x2.xm1.m0[id] @m.x1.x_g1.xm7.m0[vgs] @m.x1.x_g1.xm7.m0[vth] @m.x1.x_g1.xm7.m0[id] @m.x1.x_g2.xm7.m0[vgs] @m.x1.x_g2.xm7.m0[vth] @m.x1.x_g2.xm7.m0[id] @m.x1.x_g3.xm7.m0[vgs] @m.x1.x_g3.xm7.m0[vth] @m.x1.x_g3.xm7.m0[id] @m.x1.x_tanh.xm1.m0[vgs] @m.x1.x_tanh.xm1.m0[vth] @m.x1.x_tanh.xm1.m0[id] @m.x1.x_tanh.xm2.m0[vgs] @m.x1.x_tanh.xm2.m0[vth] @m.x1.x_tanh.xm2.m0[id]
.endc



.include /foss/pdks/gf180mcuD/libs.tech/ngspice/design.ngspice
.lib /foss/pdks/gf180mcuD/libs.tech/ngspice/sm141064.ngspice typical
* .lib /foss/pdks/gf180mcuD/libs.tech/ngspice/sm141064.ngspice res_typical
.lib /foss/pdks/gf180mcuD/libs.tech/ngspice/sm141064.ngspice res_statistical
.temp 27

**** end user architecture code
.ends

* expanding   symbol:  analog-perceptron-gf180mcu/lvs/schematics/perceptron_core.sym # of pins=9
** sym_path: /foss/designs/analog-perceptron-gf180mcu/lvs/schematics/perceptron_core.sym
** sch_path: /foss/designs/analog-perceptron-gf180mcu/lvs/schematics/perceptron_core.sch
.subckt perceptron_core VDD V_shift V_w1 I_x1 V_out_perceptron V_b I_x2 V_w2 VSS
*.PININFO VDD:B VSS:B I_x1:I I_x2:I V_w1:I V_w2:I V_b:I V_out_perceptron:O V_shift:I
XR1 V_o_p V_shift VSS ppolyf_u_1k r_width=3e-6 r_length=7.3e-6
XR2 VDD V_o_n VSS ppolyf_u_1k r_width=3e-6 r_length=7.3e-6
x1 V_1_25 net2 I_x1 VSS cg_amp_tia
x2 V_1_25 net1 I_x2 VSS cg_amp_tia
x_g1 V_o_p V_o_n V_w1 V_1_65 V_1_25 net2 V_1_65 VSS gilbert_multiplier_current
x_g2 V_o_p V_o_n V_w2 V_1_65 V_1_25 net1 V_1_65 VSS gilbert_multiplier_current
x_g3 V_o_p V_o_n V_b V_1_65 V_1_25 V_1_15 V_1_65 VSS gilbert_multiplier_current
x3 VDD V_1_65 V_1_25 V_1_15 VSS voltage_reference
x4 VDD V_1_65 V_out_perceptron V_o_p V_o_n VSS tanh_ota
.ends


* expanding   symbol:  analog-perceptron-gf180mcu/lvs/schematics/cg_amp_tia.sym # of pins=4
** sym_path: /foss/designs/analog-perceptron-gf180mcu/lvs/schematics/cg_amp_tia.sym
** sch_path: /foss/designs/analog-perceptron-gf180mcu/lvs/schematics/cg_amp_tia.sch
.subckt cg_amp_tia V_ref V_out I_in VSS
*.PININFO V_ref:B VSS:B I_in:I V_out:O
XM1 V_out V_ref I_in VSS nfet_03v3 L=0.5u W=5u nf=1 ad='int((nf+1)/2) * W/nf * 0.18u' as='int((nf+2)/2) * W/nf * 0.18u' pd='2*int((nf+1)/2) * (W/nf + 0.18u)'
+ ps='2*int((nf+2)/2) * (W/nf + 0.18u)' nrd='0.18u / W' nrs='0.18u / W' sa=0 sb=0 sd=0
XR1 V_out V_ref VSS ppolyf_u_1k r_width=3e-6 r_length=8.1e-6
.ends


* expanding   symbol:  analog-perceptron-gf180mcu/lvs/schematics/gilbert_multiplier_current.sym # of pins=8
** sym_path: /foss/designs/analog-perceptron-gf180mcu/lvs/schematics/gilbert_multiplier_current.sym
** sch_path: /foss/designs/analog-perceptron-gf180mcu/lvs/schematics/gilbert_multiplier_current.sch
.subckt gilbert_multiplier_current I_o_p I_o_n V_w_p V_w_n V_x_p V_x_n V_tail VSS
*.PININFO V_x_p:I V_x_n:I V_tail:I VSS:B V_w_p:I V_w_n:I I_o_n:O I_o_p:O
XM1 net1 V_x_p net3 VSS nfet_03v3 L=0.5u W=10u nf=1 ad='int((nf+1)/2) * W/nf * 0.18u' as='int((nf+2)/2) * W/nf * 0.18u' pd='2*int((nf+1)/2) * (W/nf + 0.18u)'
+ ps='2*int((nf+2)/2) * (W/nf + 0.18u)' nrd='0.18u / W' nrs='0.18u / W' sa=0 sb=0 sd=0
XM2 net2 V_x_n net4 VSS nfet_03v3 L=0.5u W=10u nf=1 ad='int((nf+1)/2) * W/nf * 0.18u' as='int((nf+2)/2) * W/nf * 0.18u' pd='2*int((nf+1)/2) * (W/nf + 0.18u)'
+ ps='2*int((nf+2)/2) * (W/nf + 0.18u)' nrd='0.18u / W' nrs='0.18u / W' sa=0 sb=0 sd=0
XM3 I_o_n V_w_p net1 VSS nfet_03v3 L=0.5u W=20u nf=1 ad='int((nf+1)/2) * W/nf * 0.18u' as='int((nf+2)/2) * W/nf * 0.18u' pd='2*int((nf+1)/2) * (W/nf + 0.18u)'
+ ps='2*int((nf+2)/2) * (W/nf + 0.18u)' nrd='0.18u / W' nrs='0.18u / W' sa=0 sb=0 sd=0
XM4 I_o_p V_w_n net1 VSS nfet_03v3 L=0.5u W=20u nf=1 ad='int((nf+1)/2) * W/nf * 0.18u' as='int((nf+2)/2) * W/nf * 0.18u' pd='2*int((nf+1)/2) * (W/nf + 0.18u)'
+ ps='2*int((nf+2)/2) * (W/nf + 0.18u)' nrd='0.18u / W' nrs='0.18u / W' sa=0 sb=0 sd=0
XM5 I_o_n V_w_n net2 VSS nfet_03v3 L=0.5u W=20u nf=1 ad='int((nf+1)/2) * W/nf * 0.18u' as='int((nf+2)/2) * W/nf * 0.18u' pd='2*int((nf+1)/2) * (W/nf + 0.18u)'
+ ps='2*int((nf+2)/2) * (W/nf + 0.18u)' nrd='0.18u / W' nrs='0.18u / W' sa=0 sb=0 sd=0
XM6 I_o_p V_w_p net2 VSS nfet_03v3 L=0.5u W=20u nf=1 ad='int((nf+1)/2) * W/nf * 0.18u' as='int((nf+2)/2) * W/nf * 0.18u' pd='2*int((nf+1)/2) * (W/nf + 0.18u)'
+ ps='2*int((nf+2)/2) * (W/nf + 0.18u)' nrd='0.18u / W' nrs='0.18u / W' sa=0 sb=0 sd=0
XM7 net3 V_tail VSS VSS nfet_03v3 L=1u W=8u nf=1 ad='int((nf+1)/2) * W/nf * 0.18u' as='int((nf+2)/2) * W/nf * 0.18u' pd='2*int((nf+1)/2) * (W/nf + 0.18u)'
+ ps='2*int((nf+2)/2) * (W/nf + 0.18u)' nrd='0.18u / W' nrs='0.18u / W' sa=0 sb=0 sd=0
XM8 net4 V_tail VSS VSS nfet_03v3 L=1u W=8u nf=1 ad='int((nf+1)/2) * W/nf * 0.18u' as='int((nf+2)/2) * W/nf * 0.18u' pd='2*int((nf+1)/2) * (W/nf + 0.18u)'
+ ps='2*int((nf+2)/2) * (W/nf + 0.18u)' nrd='0.18u / W' nrs='0.18u / W' sa=0 sb=0 sd=0
XR1 net3 net4 VSS ppolyf_u_1k r_width=3e-6 r_length=46.2e-6
XM9 I_o_n VSS VSS VSS nfet_03v3 L=0.5u W=5u nf=1 ad='int((nf+1)/2) * W/nf * 0.18u' as='int((nf+2)/2) * W/nf * 0.18u' pd='2*int((nf+1)/2) * (W/nf + 0.18u)'
+ ps='2*int((nf+2)/2) * (W/nf + 0.18u)' nrd='0.18u / W' nrs='0.18u / W' sa=0 sb=0 sd=0
XM10 I_o_p VSS VSS VSS nfet_03v3 L=0.5u W=5u nf=1 ad='int((nf+1)/2) * W/nf * 0.18u' as='int((nf+2)/2) * W/nf * 0.18u' pd='2*int((nf+1)/2) * (W/nf + 0.18u)'
+ ps='2*int((nf+2)/2) * (W/nf + 0.18u)' nrd='0.18u / W' nrs='0.18u / W' sa=0 sb=0 sd=0
XM11 net1 VSS VSS VSS nfet_03v3 L=0.5u W=10u nf=1 ad='int((nf+1)/2) * W/nf * 0.18u' as='int((nf+2)/2) * W/nf * 0.18u' pd='2*int((nf+1)/2) * (W/nf + 0.18u)'
+ ps='2*int((nf+2)/2) * (W/nf + 0.18u)' nrd='0.18u / W' nrs='0.18u / W' sa=0 sb=0 sd=0
XM12 net2 VSS VSS VSS nfet_03v3 L=0.5u W=10u nf=1 ad='int((nf+1)/2) * W/nf * 0.18u' as='int((nf+2)/2) * W/nf * 0.18u' pd='2*int((nf+1)/2) * (W/nf + 0.18u)'
+ ps='2*int((nf+2)/2) * (W/nf + 0.18u)' nrd='0.18u / W' nrs='0.18u / W' sa=0 sb=0 sd=0
XM13 net3 VSS VSS VSS nfet_03v3 L=1u W=8u nf=1 ad='int((nf+1)/2) * W/nf * 0.18u' as='int((nf+2)/2) * W/nf * 0.18u' pd='2*int((nf+1)/2) * (W/nf + 0.18u)'
+ ps='2*int((nf+2)/2) * (W/nf + 0.18u)' nrd='0.18u / W' nrs='0.18u / W' sa=0 sb=0 sd=0
XM15 I_o_p VSS VSS VSS nfet_03v3 L=0.5u W=5u nf=1 ad='int((nf+1)/2) * W/nf * 0.18u' as='int((nf+2)/2) * W/nf * 0.18u' pd='2*int((nf+1)/2) * (W/nf + 0.18u)'
+ ps='2*int((nf+2)/2) * (W/nf + 0.18u)' nrd='0.18u / W' nrs='0.18u / W' sa=0 sb=0 sd=0
XM16 I_o_n VSS VSS VSS nfet_03v3 L=0.5u W=5u nf=1 ad='int((nf+1)/2) * W/nf * 0.18u' as='int((nf+2)/2) * W/nf * 0.18u' pd='2*int((nf+1)/2) * (W/nf + 0.18u)'
+ ps='2*int((nf+2)/2) * (W/nf + 0.18u)' nrd='0.18u / W' nrs='0.18u / W' sa=0 sb=0 sd=0
.ends


* expanding   symbol:  analog-perceptron-gf180mcu/lvs/schematics/voltage_reference.sym # of pins=5
** sym_path: /foss/designs/analog-perceptron-gf180mcu/lvs/schematics/voltage_reference.sym
** sch_path: /foss/designs/analog-perceptron-gf180mcu/lvs/schematics/voltage_reference.sch
.subckt voltage_reference VDD v_1_65 v_1_25 v_1_15 VSS
*.PININFO VDD:B VSS:B v_1_65:O v_1_15:O v_1_25:O
XR1 V_I_1_65 VDD VSS ppolyf_u_1k r_width=3e-6 r_length=165e-6
XR2 V_I_1_25 V_I_1_65 VSS ppolyf_u_1k r_width=3e-6 r_length=40e-6
XR3 V_I_1_15 V_I_1_25 VSS ppolyf_u_1k r_width=3e-6 r_length=10e-6
XR4 VSS V_I_1_15 VSS ppolyf_u_1k r_width=3e-6 r_length=115e-6
XM11 net2 V_pbias VDD VDD pfet_03v3 L=1u W=20u nf=1 ad='int((nf+1)/2) * W/nf * 0.18u' as='int((nf+2)/2) * W/nf * 0.18u' pd='2*int((nf+1)/2) * (W/nf + 0.18u)'
+ ps='2*int((nf+2)/2) * (W/nf + 0.18u)' nrd='0.18u / W' nrs='0.18u / W' sa=0 sb=0 sd=0
XM12 net1 V_I_1_15 net2 VDD pfet_03v3 L=1u W=20u nf=1 ad='int((nf+1)/2) * W/nf * 0.18u' as='int((nf+2)/2) * W/nf * 0.18u' pd='2*int((nf+1)/2) * (W/nf + 0.18u)'
+ ps='2*int((nf+2)/2) * (W/nf + 0.18u)' nrd='0.18u / W' nrs='0.18u / W' sa=0 sb=0 sd=0
XM13 v_1_15 v_1_15 net2 VDD pfet_03v3 L=1u W=20u nf=1 ad='int((nf+1)/2) * W/nf * 0.18u' as='int((nf+2)/2) * W/nf * 0.18u' pd='2*int((nf+1)/2) * (W/nf + 0.18u)'
+ ps='2*int((nf+2)/2) * (W/nf + 0.18u)' nrd='0.18u / W' nrs='0.18u / W' sa=0 sb=0 sd=0
XM14 net1 net1 VSS VSS nfet_03v3 L=1u W=10u nf=1 ad='int((nf+1)/2) * W/nf * 0.18u' as='int((nf+2)/2) * W/nf * 0.18u' pd='2*int((nf+1)/2) * (W/nf + 0.18u)'
+ ps='2*int((nf+2)/2) * (W/nf + 0.18u)' nrd='0.18u / W' nrs='0.18u / W' sa=0 sb=0 sd=0
XM15 v_1_15 net1 VSS VSS nfet_03v3 L=1u W=10u nf=1 ad='int((nf+1)/2) * W/nf * 0.18u' as='int((nf+2)/2) * W/nf * 0.18u' pd='2*int((nf+1)/2) * (W/nf + 0.18u)'
+ ps='2*int((nf+2)/2) * (W/nf + 0.18u)' nrd='0.18u / W' nrs='0.18u / W' sa=0 sb=0 sd=0
XM21 VDD net8 v_1_25 VSS nfet_03v3 L=1u W=100u nf=1 ad='int((nf+1)/2) * W/nf * 0.18u' as='int((nf+2)/2) * W/nf * 0.18u' pd='2*int((nf+1)/2) * (W/nf + 0.18u)'
+ ps='2*int((nf+2)/2) * (W/nf + 0.18u)' nrd='0.18u / W' nrs='0.18u / W' sa=0 sb=0 sd=0
XR6 VSS v_1_25 VSS ppolyf_u_1k r_width=3e-6 r_length=20e-6
XM22 V_pbias V_pbias VDD VDD pfet_03v3 L=1u W=10u nf=1 ad='int((nf+1)/2) * W/nf * 0.18u' as='int((nf+2)/2) * W/nf * 0.18u' pd='2*int((nf+1)/2) * (W/nf + 0.18u)'
+ ps='2*int((nf+2)/2) * (W/nf + 0.18u)' nrd='0.18u / W' nrs='0.18u / W' sa=0 sb=0 sd=0
XR7 VSS V_pbias VSS ppolyf_u_1k r_width=3e-6 r_length=150e-6
XM1 net4 V_I_1_65 net3 VSS nfet_03v3 L=2u W=10u nf=1 ad='int((nf+1)/2) * W/nf * 0.18u' as='int((nf+2)/2) * W/nf * 0.18u' pd='2*int((nf+1)/2) * (W/nf + 0.18u)'
+ ps='2*int((nf+2)/2) * (W/nf + 0.18u)' nrd='0.18u / W' nrs='0.18u / W' sa=0 sb=0 sd=0
XM2 net5 v_1_65 net3 VSS nfet_03v3 L=2u W=10u nf=1 ad='int((nf+1)/2) * W/nf * 0.18u' as='int((nf+2)/2) * W/nf * 0.18u' pd='2*int((nf+1)/2) * (W/nf + 0.18u)'
+ ps='2*int((nf+2)/2) * (W/nf + 0.18u)' nrd='0.18u / W' nrs='0.18u / W' sa=0 sb=0 sd=0
XM3 net3 V_nbias VSS VSS nfet_03v3 L=2u W=10u nf=1 ad='int((nf+1)/2) * W/nf * 0.18u' as='int((nf+2)/2) * W/nf * 0.18u' pd='2*int((nf+1)/2) * (W/nf + 0.18u)'
+ ps='2*int((nf+2)/2) * (W/nf + 0.18u)' nrd='0.18u / W' nrs='0.18u / W' sa=0 sb=0 sd=0
XM4 net4 net4 VDD VDD pfet_03v3 L=2u W=20u nf=1 ad='int((nf+1)/2) * W/nf * 0.18u' as='int((nf+2)/2) * W/nf * 0.18u' pd='2*int((nf+1)/2) * (W/nf + 0.18u)'
+ ps='2*int((nf+2)/2) * (W/nf + 0.18u)' nrd='0.18u / W' nrs='0.18u / W' sa=0 sb=0 sd=0
XM5 net5 net4 VDD VDD pfet_03v3 L=2u W=20u nf=1 ad='int((nf+1)/2) * W/nf * 0.18u' as='int((nf+2)/2) * W/nf * 0.18u' pd='2*int((nf+1)/2) * (W/nf + 0.18u)'
+ ps='2*int((nf+2)/2) * (W/nf + 0.18u)' nrd='0.18u / W' nrs='0.18u / W' sa=0 sb=0 sd=0
XM23 V_nbias V_nbias VSS VSS nfet_03v3 L=1u W=10u nf=1 ad='int((nf+1)/2) * W/nf * 0.18u' as='int((nf+2)/2) * W/nf * 0.18u' pd='2*int((nf+1)/2) * (W/nf + 0.18u)'
+ ps='2*int((nf+2)/2) * (W/nf + 0.18u)' nrd='0.18u / W' nrs='0.18u / W' sa=0 sb=0 sd=0
XR8 V_nbias VDD VSS ppolyf_u_1k r_width=3e-6 r_length=150e-6
XM6 net7 V_I_1_25 net6 VSS nfet_03v3 L=2u W=10u nf=1 ad='int((nf+1)/2) * W/nf * 0.18u' as='int((nf+2)/2) * W/nf * 0.18u' pd='2*int((nf+1)/2) * (W/nf + 0.18u)'
+ ps='2*int((nf+2)/2) * (W/nf + 0.18u)' nrd='0.18u / W' nrs='0.18u / W' sa=0 sb=0 sd=0
XM7 net8 v_1_25 net6 VSS nfet_03v3 L=2u W=10u nf=1 ad='int((nf+1)/2) * W/nf * 0.18u' as='int((nf+2)/2) * W/nf * 0.18u' pd='2*int((nf+1)/2) * (W/nf + 0.18u)'
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
XM32 net7 VDD VDD VDD pfet_03v3 L=2u W=20u nf=1 ad='int((nf+1)/2) * W/nf * 0.18u' as='int((nf+2)/2) * W/nf * 0.18u' pd='2*int((nf+1)/2) * (W/nf + 0.18u)'
+ ps='2*int((nf+2)/2) * (W/nf + 0.18u)' nrd='0.18u / W' nrs='0.18u / W' sa=0 sb=0 sd=0
.ends


* expanding   symbol:  analog-perceptron-gf180mcu/lvs/schematics/tanh_ota.sym # of pins=6
** sym_path: /foss/designs/analog-perceptron-gf180mcu/lvs/schematics/tanh_ota.sym
** sch_path: /foss/designs/analog-perceptron-gf180mcu/lvs/schematics/tanh_ota.sch
.subckt tanh_ota VDD V_ref V_out V_in_p V_in_n VSS
*.PININFO VDD:B VSS:B V_in_p:I V_in_n:I V_out:O V_ref:B
XM1 net2 V_in_p net1 VSS nfet_03v3 L=0.5u W=10u nf=1 ad='int((nf+1)/2) * W/nf * 0.18u' as='int((nf+2)/2) * W/nf * 0.18u' pd='2*int((nf+1)/2) * (W/nf + 0.18u)'
+ ps='2*int((nf+2)/2) * (W/nf + 0.18u)' nrd='0.18u / W' nrs='0.18u / W' sa=0 sb=0 sd=0
XM2 V_out V_in_n net1 VSS nfet_03v3 L=0.5u W=10u nf=1 ad='int((nf+1)/2) * W/nf * 0.18u' as='int((nf+2)/2) * W/nf * 0.18u' pd='2*int((nf+1)/2) * (W/nf + 0.18u)'
+ ps='2*int((nf+2)/2) * (W/nf + 0.18u)' nrd='0.18u / W' nrs='0.18u / W' sa=0 sb=0 sd=0
XM3 net1 net3 VSS VSS nfet_03v3 L=0.5u W=3u nf=1 ad='int((nf+1)/2) * W/nf * 0.18u' as='int((nf+2)/2) * W/nf * 0.18u' pd='2*int((nf+1)/2) * (W/nf + 0.18u)'
+ ps='2*int((nf+2)/2) * (W/nf + 0.18u)' nrd='0.18u / W' nrs='0.18u / W' sa=0 sb=0 sd=0
XM4 net2 net2 VDD VDD pfet_03v3 L=0.5u W=20u nf=1 ad='int((nf+1)/2) * W/nf * 0.18u' as='int((nf+2)/2) * W/nf * 0.18u' pd='2*int((nf+1)/2) * (W/nf + 0.18u)'
+ ps='2*int((nf+2)/2) * (W/nf + 0.18u)' nrd='0.18u / W' nrs='0.18u / W' sa=0 sb=0 sd=0
XM5 V_out net2 VDD VDD pfet_03v3 L=0.5u W=20u nf=1 ad='int((nf+1)/2) * W/nf * 0.18u' as='int((nf+2)/2) * W/nf * 0.18u' pd='2*int((nf+1)/2) * (W/nf + 0.18u)'
+ ps='2*int((nf+2)/2) * (W/nf + 0.18u)' nrd='0.18u / W' nrs='0.18u / W' sa=0 sb=0 sd=0
XR6 V_out V_ref VSS ppolyf_u_1k r_width=3e-6 r_length=45e-6
XM6 net3 net3 VSS VSS nfet_03v3 L=0.5u W=30u nf=1 ad='int((nf+1)/2) * W/nf * 0.18u' as='int((nf+2)/2) * W/nf * 0.18u' pd='2*int((nf+1)/2) * (W/nf + 0.18u)'
+ ps='2*int((nf+2)/2) * (W/nf + 0.18u)' nrd='0.18u / W' nrs='0.18u / W' sa=0 sb=0 sd=0
XR1 net3 VDD VSS ppolyf_u_1k r_width=3e-6 r_length=110e-6
XM7 VSS VSS VSS VSS nfet_03v3 L=0.5u W=3u nf=1 ad='int((nf+1)/2) * W/nf * 0.18u' as='int((nf+2)/2) * W/nf * 0.18u' pd='2*int((nf+1)/2) * (W/nf + 0.18u)'
+ ps='2*int((nf+2)/2) * (W/nf + 0.18u)' nrd='0.18u / W' nrs='0.18u / W' sa=0 sb=0 sd=0
XM8 net2 VSS VSS VSS nfet_03v3 L=0.5u W=10u nf=1 ad='int((nf+1)/2) * W/nf * 0.18u' as='int((nf+2)/2) * W/nf * 0.18u' pd='2*int((nf+1)/2) * (W/nf + 0.18u)'
+ ps='2*int((nf+2)/2) * (W/nf + 0.18u)' nrd='0.18u / W' nrs='0.18u / W' sa=0 sb=0 sd=0
XM9 net2 VDD VDD VDD pfet_03v3 L=0.5u W=10u nf=1 ad='int((nf+1)/2) * W/nf * 0.18u' as='int((nf+2)/2) * W/nf * 0.18u' pd='2*int((nf+1)/2) * (W/nf + 0.18u)'
+ ps='2*int((nf+2)/2) * (W/nf + 0.18u)' nrd='0.18u / W' nrs='0.18u / W' sa=0 sb=0 sd=0
.ends
