valrek-sol/analog-perceptron-gf180mcu/pex/out/pex/perceptron_core_pex_c.spice

* perceptron_core_pex_c — Magic C extraction of perceptron_core (layout/perceptron/perceptron_core.gds)
* generated by pex/pex.tcl, see pex/out/env.txt for provenance
* ports (schematic order): VDD V_shift V_w1 I_x1 V_out_perceptron V_b I_x2 V_w2 VSS
* NGSPICE file created from perceptron_core.ext - technology: gf180mcuD

.subckt perceptron_core_pex_c VDD V_shift V_w1 I_x1 V_out_perceptron V_b I_x2 V_w2 VSS
X0 a_8355_9194# tanh_ota_0.V_ref tanh_ota_0.V_in_p VSS nfet_03v3 ad=0.65p pd=3.02u as=0.65p ps=3.02u w=2.5u l=0.5u
X1 a_3415_6100# tanh_ota_0.V_ref tanh_ota_0.V_in_n VSS nfet_03v3 ad=0.65p pd=3.02u as=0.65p ps=3.02u w=2.5u l=0.5u
X2 a_2717_18262# a_2717_15824# VSS ppolyf_u_1k r_width=3u r_length=11.55u
X3 a_8355_9194# V_b tanh_ota_0.V_in_n VSS nfet_03v3 ad=0.65p pd=3.02u as=0.65p ps=3.02u w=2.5u l=0.5u
X4 VDD a_14690_20226# a_14690_20226# VDD pfet_03v3 ad=2.6p pd=10.52u as=2.6p ps=10.52u w=10u l=2u
X5 a_8355_9194# V_b tanh_ota_0.V_in_n VSS nfet_03v3 ad=0.65p pd=3.02u as=0.65p ps=3.02u w=2.5u l=0.5u
X6 a_3415_6100# V_w2 tanh_ota_0.V_in_p VSS nfet_03v3 ad=0.65p pd=3.02u as=0.65p ps=3.02u w=2.5u l=0.5u
X7 a_3619_22696# V_w1 tanh_ota_0.V_in_n VSS nfet_03v3 ad=0.65p pd=3.02u as=0.65p ps=3.02u w=2.5u l=0.5u
X8 a_3598_19300# voltage_reference_0.v_1_25 a_3619_22696# VSS nfet_03v3 ad=1.3p pd=5.52u as=1.3p ps=5.52u w=5u l=0.5u
X9 a_7766_18788# VDD VDD VDD pfet_03v3 ad=1.3p pd=5.52u as=3.25p ps=11.3u w=5u l=0.5u
X10 a_19854_15770# a_26642_16152# VSS ppolyf_u_1k r_width=3u r_length=23u
X11 a_8355_9194# tanh_ota_0.V_ref tanh_ota_0.V_in_p VSS nfet_03v3 ad=0.65p pd=3.02u as=0.65p ps=3.02u w=2.5u l=0.5u
X12 a_3619_22696# tanh_ota_0.V_ref tanh_ota_0.V_in_p VSS nfet_03v3 ad=0.65p pd=3.02u as=0.65p ps=3.02u w=2.5u l=0.5u
X13 a_3619_22696# tanh_ota_0.V_ref tanh_ota_0.V_in_p VSS nfet_03v3 ad=0.65p pd=3.02u as=0.65p ps=3.02u w=2.5u l=0.5u
X14 a_8559_11644# VSS VSS VSS nfet_03v3 ad=1.3p pd=5.52u as=3.05p ps=11.22u w=5u l=0.5u
X15 a_3619_22696# V_w1 tanh_ota_0.V_in_n VSS nfet_03v3 ad=0.65p pd=3.02u as=0.65p ps=3.02u w=2.5u l=0.5u
X16 a_3415_21020# tanh_ota_0.V_ref tanh_ota_0.V_in_n VSS nfet_03v3 ad=0.65p pd=3.02u as=0.65p ps=3.02u w=2.5u l=0.5u
X17 a_11555_17360# a_11555_17360# VSS VSS nfet_03v3 ad=0.39p pd=2.02u as=0.39p ps=2.02u w=1.5u l=0.5u
X18 a_11555_17360# a_11555_17360# VSS VSS nfet_03v3 ad=0.39p pd=2.02u as=0.39p ps=2.02u w=1.5u l=0.5u
X19 a_13330_17856# VDD VSS ppolyf_u_1k r_width=3u r_length=30u
X20 a_3619_2602# V_w2 tanh_ota_0.V_in_n VSS nfet_03v3 ad=0.65p pd=3.02u as=0.65p ps=3.02u w=2.5u l=0.5u
X21 a_3415_21020# V_w1 tanh_ota_0.V_in_p VSS nfet_03v3 ad=0.65p pd=3.02u as=0.65p ps=3.02u w=2.5u l=0.5u
X22 VDD a_13492_24053# voltage_reference_0.v_1_25 VSS nfet_03v3 ad=2.6p pd=10.52u as=2.6p ps=10.52u w=10u l=1u
X23 a_7766_18788# VSS VSS VSS nfet_03v3 ad=1.3p pd=5.52u as=3.05p ps=11.22u w=5u l=0.5u
X24 a_13250_5878# VSS VSS VSS nfet_03v3 ad=1.3p pd=5.52u as=3.05p ps=11.22u w=5u l=1u
X25 VSS VSS tanh_ota_0.V_in_n VSS nfet_03v3 ad=1.525p pd=6.22u as=0.65p ps=3.02u w=2.5u l=0.5u
X26 a_3598_19300# a_4405_15824# VSS ppolyf_u_1k r_width=3u r_length=11.55u
X27 a_23777_13400# VDD VDD VDD pfet_03v3 ad=2.6p pd=10.52u as=6.5p ps=21.3u w=10u l=1u
X28 a_3561_18262# a_4405_15824# VSS ppolyf_u_1k r_width=3u r_length=11.55u
X29 VSS VSS tanh_ota_0.V_in_n VSS nfet_03v3 ad=1.525p pd=6.22u as=0.65p ps=3.02u w=2.5u l=0.5u
X30 a_3415_6100# tanh_ota_0.V_ref tanh_ota_0.V_in_n VSS nfet_03v3 ad=0.65p pd=3.02u as=0.65p ps=3.02u w=2.5u l=0.5u
X31 a_7657_6436# VSS VSS VSS nfet_03v3 ad=1.04p pd=4.52u as=2.44p ps=9.22u w=4u l=1u
X32 VSS a_11555_17360# a_11555_17360# VSS nfet_03v3 ad=0.39p pd=2.02u as=0.39p ps=2.02u w=1.5u l=0.5u
X33 VSS a_11555_17360# a_11555_17360# VSS nfet_03v3 ad=0.39p pd=2.02u as=0.39p ps=2.02u w=1.5u l=0.5u
X34 VSS voltage_reference_0.v_1_25 VSS ppolyf_u_1k r_width=3u r_length=20u
X35 tanh_ota_0.V_in_n tanh_ota_0.V_ref a_8559_11644# VSS nfet_03v3 ad=0.65p pd=3.02u as=0.65p ps=3.02u w=2.5u l=0.5u
X36 tanh_ota_0.V_in_p VSS VSS VSS nfet_03v3 ad=0.65p pd=3.02u as=1.525p ps=6.22u w=2.5u l=0.5u
X37 a_7766_18788# tanh_ota_0.V_in_p a_10295_19296# VSS nfet_03v3 ad=1.3p pd=5.52u as=1.3p ps=5.52u w=5u l=0.5u
X38 VSS VSS a_13382_5774# VSS nfet_03v3 ad=1.525p pd=6.22u as=0.65p ps=3.02u w=2.5u l=2u
X39 VDD a_13492_24053# voltage_reference_0.v_1_25 VSS nfet_03v3 ad=2.6p pd=10.52u as=2.6p ps=10.52u w=10u l=1u
X40 a_8355_9194# tanh_ota_0.V_ref tanh_ota_0.V_in_p VSS nfet_03v3 ad=0.65p pd=3.02u as=0.65p ps=3.02u w=2.5u l=0.5u
X41 tanh_ota_0.V_in_n tanh_ota_0.V_ref a_8559_11644# VSS nfet_03v3 ad=0.65p pd=3.02u as=0.65p ps=3.02u w=2.5u l=0.5u
X42 VDD a_7766_18788# a_7766_18788# VDD pfet_03v3 ad=1.3p pd=5.52u as=1.3p ps=5.52u w=5u l=0.5u
X43 a_8355_9194# V_b tanh_ota_0.V_in_n VSS nfet_03v3 ad=0.65p pd=3.02u as=0.65p ps=3.02u w=2.5u l=0.5u
X44 VSS VSS a_3415_21020# VSS nfet_03v3 ad=3.05p pd=11.22u as=1.3p ps=5.52u w=5u l=0.5u
X45 a_23777_13400# a_19854_15770# a_22199_13400# VDD pfet_03v3 ad=2.6p pd=10.52u as=2.6p ps=10.52u w=10u l=1u
X46 VSS a_13250_5878# a_13382_5774# VSS nfet_03v3 ad=0.65p pd=3.02u as=0.65p ps=3.02u w=2.5u l=2u
X47 a_3415_6100# VSS VSS VSS nfet_03v3 ad=1.3p pd=5.52u as=3.05p ps=11.22u w=5u l=0.5u
X48 a_3619_22696# V_w1 tanh_ota_0.V_in_n VSS nfet_03v3 ad=0.65p pd=3.02u as=0.65p ps=3.02u w=2.5u l=0.5u
X49 a_2717_18262# gilbert_multiplier_current_2.V_x_n a_3415_21020# VSS nfet_03v3 ad=1.3p pd=5.52u as=1.3p ps=5.52u w=5u l=0.5u
X50 a_3619_2602# tanh_ota_0.V_ref tanh_ota_0.V_in_p VSS nfet_03v3 ad=0.65p pd=3.02u as=0.65p ps=3.02u w=2.5u l=0.5u
X51 a_3619_22696# tanh_ota_0.V_ref tanh_ota_0.V_in_p VSS nfet_03v3 ad=0.65p pd=3.02u as=0.65p ps=3.02u w=2.5u l=0.5u
X52 VDD a_13492_1131# tanh_ota_0.V_ref VSS nfet_03v3 ad=2.6p pd=10.52u as=2.6p ps=10.52u w=10u l=1u
X53 a_3415_21020# tanh_ota_0.V_ref tanh_ota_0.V_in_n VSS nfet_03v3 ad=0.65p pd=3.02u as=0.65p ps=3.02u w=2.5u l=0.5u
X54 VSS a_11555_17360# a_11555_17360# VSS nfet_03v3 ad=0.39p pd=2.02u as=0.39p ps=2.02u w=1.5u l=0.5u
X55 VSS VSS a_13382_20226# VSS nfet_03v3 ad=1.525p pd=6.22u as=0.65p ps=3.02u w=2.5u l=2u
X56 VSS a_13250_5878# a_13382_5774# VSS nfet_03v3 ad=0.65p pd=3.02u as=0.65p ps=3.02u w=2.5u l=2u
X57 VSS VSS a_8559_11644# VSS nfet_03v3 ad=3.05p pd=11.22u as=1.3p ps=5.52u w=5u l=0.5u
X58 a_3415_21020# V_w1 tanh_ota_0.V_in_p VSS nfet_03v3 ad=0.65p pd=3.02u as=0.65p ps=3.02u w=2.5u l=0.5u
X59 a_3415_21020# V_w1 tanh_ota_0.V_in_p VSS nfet_03v3 ad=0.65p pd=3.02u as=0.65p ps=3.02u w=2.5u l=0.5u
X60 gilbert_multiplier_current_2.V_x_n voltage_reference_0.v_1_25 I_x1 VSS nfet_03v3 ad=0.65p pd=3.02u as=1.525p ps=6.22u w=2.5u l=0.5u
X61 a_3415_6100# tanh_ota_0.V_ref tanh_ota_0.V_in_n VSS nfet_03v3 ad=0.65p pd=3.02u as=0.65p ps=3.02u w=2.5u l=0.5u
X62 VDD a_11839_24980# VSS ppolyf_u_1k r_width=3u r_length=22u
X63 a_3415_21020# tanh_ota_0.V_ref tanh_ota_0.V_in_n VSS nfet_03v3 ad=0.65p pd=3.02u as=0.65p ps=3.02u w=2.5u l=0.5u
X64 VSS a_13250_5878# a_13382_20226# VSS nfet_03v3 ad=0.65p pd=3.02u as=0.65p ps=3.02u w=2.5u l=2u
X65 a_21914_17004# a_26642_17856# VSS ppolyf_u_1k r_width=3u r_length=23u
X66 a_14558_5878# a_19467_13334# VSS ppolyf_u_1k r_width=3u r_length=20u
X67 tanh_ota_0.V_ref a_13492_1131# VDD VSS nfet_03v3 ad=2.6p pd=10.52u as=2.6p ps=10.52u w=10u l=1u
X68 a_10295_19296# a_11555_17360# VSS VSS nfet_03v3 ad=0.39p pd=2.02u as=0.39p ps=2.02u w=1.5u l=0.5u
X69 VDD a_19458_12220# a_22199_13400# VDD pfet_03v3 ad=1.3p pd=5.52u as=1.3p ps=5.52u w=5u l=1u
X70 a_3619_2602# voltage_reference_0.v_1_25 a_3598_8020# VSS nfet_03v3 ad=1.3p pd=5.52u as=1.3p ps=5.52u w=5u l=0.5u
X71 V_out_perceptron a_8953_14522# VSS ppolyf_u_1k r_width=3u r_length=15u
X72 a_3598_8020# tanh_ota_0.V_ref VSS VSS nfet_03v3 ad=1.04p pd=4.52u as=1.04p ps=4.52u w=4u l=1u
X73 a_11555_17360# a_11555_17360# VSS VSS nfet_03v3 ad=0.39p pd=2.02u as=0.39p ps=2.02u w=1.5u l=0.5u
X74 VSS VSS a_14690_20226# VSS nfet_03v3 ad=3.05p pd=11.22u as=1.3p ps=5.52u w=5u l=2u
X75 tanh_ota_0.V_in_p V_b a_8559_11644# VSS nfet_03v3 ad=0.65p pd=3.02u as=0.65p ps=3.02u w=2.5u l=0.5u
X76 tanh_ota_0.V_in_p tanh_ota_0.V_ref a_3619_2602# VSS nfet_03v3 ad=0.65p pd=3.02u as=0.65p ps=3.02u w=2.5u l=0.5u
X77 a_3619_2602# V_w2 tanh_ota_0.V_in_n VSS nfet_03v3 ad=0.65p pd=3.02u as=0.65p ps=3.02u w=2.5u l=0.5u
X78 VSS tanh_ota_0.V_ref a_2717_18262# VSS nfet_03v3 ad=1.04p pd=4.52u as=1.04p ps=4.52u w=4u l=1u
X79 tanh_ota_0.V_in_n tanh_ota_0.V_ref a_8559_11644# VSS nfet_03v3 ad=0.65p pd=3.02u as=0.65p ps=3.02u w=2.5u l=0.5u
X80 a_8355_9194# VSS VSS VSS nfet_03v3 ad=1.3p pd=5.52u as=3.05p ps=11.22u w=5u l=0.5u
X81 a_3415_6100# V_w2 tanh_ota_0.V_in_p VSS nfet_03v3 ad=0.65p pd=3.02u as=0.65p ps=3.02u w=2.5u l=0.5u
X82 a_7311_22424# a_11839_23276# VSS ppolyf_u_1k r_width=3u r_length=22u
X83 voltage_reference_0.v_1_25 a_13492_24053# VDD VSS nfet_03v3 ad=2.6p pd=10.52u as=2.6p ps=10.52u w=10u l=1u
X84 a_7766_18788# a_7766_18788# VDD VDD pfet_03v3 ad=1.3p pd=5.52u as=1.3p ps=5.52u w=5u l=0.5u
X85 a_13382_20226# voltage_reference_0.v_1_25 a_13492_24053# VSS nfet_03v3 ad=1.3p pd=5.52u as=1.3p ps=5.52u w=5u l=2u
X86 tanh_ota_0.V_in_p V_b a_8559_11644# VSS nfet_03v3 ad=0.65p pd=3.02u as=0.65p ps=3.02u w=2.5u l=0.5u
X87 tanh_ota_0.V_in_n V_w2 a_3619_2602# VSS nfet_03v3 ad=0.65p pd=3.02u as=0.65p ps=3.02u w=2.5u l=0.5u
X88 VSS a_11555_17360# a_11555_17360# VSS nfet_03v3 ad=0.39p pd=2.02u as=0.39p ps=2.02u w=1.5u l=0.5u
X89 tanh_ota_0.V_in_n VSS VSS VSS nfet_03v3 ad=0.65p pd=3.02u as=1.525p ps=6.22u w=2.5u l=0.5u
X90 a_3415_6100# tanh_ota_0.V_ref tanh_ota_0.V_in_n VSS nfet_03v3 ad=0.65p pd=3.02u as=0.65p ps=3.02u w=2.5u l=0.5u
X91 VDD a_13492_24053# voltage_reference_0.v_1_25 VSS nfet_03v3 ad=2.6p pd=10.52u as=2.6p ps=10.52u w=10u l=1u
X92 a_13250_5878# a_13250_5878# VSS VSS nfet_03v3 ad=1.3p pd=5.52u as=1.3p ps=5.52u w=5u l=1u
X93 tanh_ota_0.V_in_p tanh_ota_0.V_ref a_8355_9194# VSS nfet_03v3 ad=0.65p pd=3.02u as=0.65p ps=3.02u w=2.5u l=0.5u
X94 a_8559_11644# voltage_reference_0.v_1_15 a_9196_7474# VSS nfet_03v3 ad=1.3p pd=5.52u as=1.3p ps=5.52u w=5u l=0.5u
X95 VDD VDD a_7766_18788# VDD pfet_03v3 ad=3.25p pd=11.3u as=1.3p ps=5.52u w=5u l=0.5u
X96 VSS VSS a_3619_2602# VSS nfet_03v3 ad=3.05p pd=11.22u as=1.3p ps=5.52u w=5u l=0.5u
X97 tanh_ota_0.V_in_n V_w1 a_3619_22696# VSS nfet_03v3 ad=0.65p pd=3.02u as=0.65p ps=3.02u w=2.5u l=0.5u
X98 VSS VSS a_3598_19300# VSS nfet_03v3 ad=2.44p pd=9.22u as=1.04p ps=4.52u w=4u l=1u
X99 tanh_ota_0.V_in_n V_w2 a_3619_2602# VSS nfet_03v3 ad=0.65p pd=3.02u as=0.65p ps=3.02u w=2.5u l=0.5u
X100 VSS a_11555_17360# a_11555_17360# VSS nfet_03v3 ad=0.39p pd=2.02u as=0.39p ps=2.02u w=1.5u l=0.5u
X101 a_13382_20226# a_13250_5878# VSS VSS nfet_03v3 ad=0.65p pd=3.02u as=0.65p ps=3.02u w=2.5u l=2u
X102 a_19914_7960# VDD VSS ppolyf_u_1k r_width=3u r_length=33u
X103 a_3415_21020# V_w1 tanh_ota_0.V_in_p VSS nfet_03v3 ad=0.65p pd=3.02u as=0.65p ps=3.02u w=2.5u l=0.5u
X104 a_19458_12220# VDD VDD VDD pfet_03v3 ad=1.3p pd=5.52u as=3.25p ps=11.3u w=5u l=1u
X105 a_13382_5774# a_13250_5878# VSS VSS nfet_03v3 ad=0.65p pd=3.02u as=0.65p ps=3.02u w=2.5u l=2u
X106 a_3415_21020# tanh_ota_0.V_ref tanh_ota_0.V_in_n VSS nfet_03v3 ad=0.65p pd=3.02u as=0.65p ps=3.02u w=2.5u l=0.5u
X107 voltage_reference_0.v_1_25 a_13492_24053# VDD VSS nfet_03v3 ad=2.6p pd=10.52u as=2.6p ps=10.52u w=10u l=1u
X108 a_14690_20226# VDD VDD VDD pfet_03v3 ad=2.6p pd=10.52u as=6.5p ps=21.3u w=10u l=2u
X109 VSS a_23777_13400# a_23777_13400# VSS nfet_03v3 ad=1.3p pd=5.52u as=1.3p ps=5.52u w=5u l=1u
X110 tanh_ota_0.V_in_p tanh_ota_0.V_ref a_3619_2602# VSS nfet_03v3 ad=0.65p pd=3.02u as=0.65p ps=3.02u w=2.5u l=0.5u
X111 a_13382_20226# a_13250_5878# VSS VSS nfet_03v3 ad=0.65p pd=3.02u as=0.65p ps=3.02u w=2.5u l=2u
X112 I_x2 voltage_reference_0.v_1_25 gilbert_multiplier_current_1.V_x_n VSS nfet_03v3 ad=1.525p pd=6.22u as=0.65p ps=3.02u w=2.5u l=0.5u
X113 a_13382_5774# a_13250_5878# VSS VSS nfet_03v3 ad=0.65p pd=3.02u as=0.65p ps=3.02u w=2.5u l=2u
X114 tanh_ota_0.V_in_n tanh_ota_0.V_ref a_3415_6100# VSS nfet_03v3 ad=0.65p pd=3.02u as=0.65p ps=3.02u w=2.5u l=0.5u
X115 a_13382_5774# VSS VSS VSS nfet_03v3 ad=0.65p pd=3.02u as=1.525p ps=6.22u w=2.5u l=2u
X116 tanh_ota_0.V_in_p V_w2 a_3415_6100# VSS nfet_03v3 ad=0.65p pd=3.02u as=0.65p ps=3.02u w=2.5u l=0.5u
X117 VDD VDD a_22199_13400# VDD pfet_03v3 ad=3.25p pd=11.3u as=1.3p ps=5.52u w=5u l=1u
X118 a_14558_5878# a_26642_10516# VSS ppolyf_u_1k r_width=3u r_length=33u
X119 a_14690_20226# a_14558_20330# a_13382_20226# VSS nfet_03v3 ad=1.3p pd=5.52u as=1.3p ps=5.52u w=5u l=2u
X120 tanh_ota_0.V_in_n tanh_ota_0.V_ref a_8559_11644# VSS nfet_03v3 ad=0.65p pd=3.02u as=0.65p ps=3.02u w=2.5u l=0.5u
X121 tanh_ota_0.V_in_p V_b a_8559_11644# VSS nfet_03v3 ad=0.65p pd=3.02u as=0.65p ps=3.02u w=2.5u l=0.5u
X122 VDD a_13492_1131# tanh_ota_0.V_ref VSS nfet_03v3 ad=2.6p pd=10.52u as=2.6p ps=10.52u w=10u l=1u
X123 a_10295_19296# tanh_ota_0.V_in_n V_out_perceptron VSS nfet_03v3 ad=1.3p pd=5.52u as=1.3p ps=5.52u w=5u l=0.5u
X124 a_13492_24053# voltage_reference_0.v_1_25 a_13382_20226# VSS nfet_03v3 ad=1.3p pd=5.52u as=1.3p ps=5.52u w=5u l=2u
X125 a_13330_16152# a_19458_15300# VSS ppolyf_u_1k r_width=3u r_length=30u
X126 tanh_ota_0.V_in_n V_b a_8355_9194# VSS nfet_03v3 ad=0.65p pd=3.02u as=0.65p ps=3.02u w=2.5u l=0.5u
X127 tanh_ota_0.V_in_n V_b a_8355_9194# VSS nfet_03v3 ad=0.65p pd=3.02u as=0.65p ps=3.02u w=2.5u l=0.5u
X128 a_3415_6100# gilbert_multiplier_current_1.V_x_n a_2717_9730# VSS nfet_03v3 ad=1.3p pd=5.52u as=1.3p ps=5.52u w=5u l=0.5u
X129 a_7766_18788# a_7766_18788# VDD VDD pfet_03v3 ad=1.3p pd=5.52u as=1.3p ps=5.52u w=5u l=0.5u
X130 VSS a_11555_17360# a_11555_17360# VSS nfet_03v3 ad=0.39p pd=2.02u as=0.39p ps=2.02u w=1.5u l=0.5u
X131 VSS a_11555_17360# a_11555_17360# VSS nfet_03v3 ad=0.39p pd=2.02u as=0.39p ps=2.02u w=1.5u l=0.5u
X132 tanh_ota_0.V_in_p VSS VSS VSS nfet_03v3 ad=0.65p pd=3.02u as=1.525p ps=6.22u w=2.5u l=0.5u
X133 VSS VSS VDD VSS nfet_03v3 ad=6.1p pd=21.22u as=2.6p ps=10.52u w=10u l=1u
X134 voltage_reference_0.v_1_25 a_13492_24053# VDD VSS nfet_03v3 ad=2.6p pd=10.52u as=2.6p ps=10.52u w=10u l=1u
X135 tanh_ota_0.V_in_p tanh_ota_0.V_ref a_3619_22696# VSS nfet_03v3 ad=0.65p pd=3.02u as=0.65p ps=3.02u w=2.5u l=0.5u
X136 tanh_ota_0.V_in_p tanh_ota_0.V_ref a_3619_22696# VSS nfet_03v3 ad=0.65p pd=3.02u as=0.65p ps=3.02u w=2.5u l=0.5u
X137 a_22199_13400# a_19458_12220# VDD VDD pfet_03v3 ad=1.3p pd=5.52u as=1.3p ps=5.52u w=5u l=1u
X138 a_3415_6100# V_w2 tanh_ota_0.V_in_p VSS nfet_03v3 ad=0.65p pd=3.02u as=0.65p ps=3.02u w=2.5u l=0.5u
X139 tanh_ota_0.V_in_n VSS VSS VSS nfet_03v3 ad=0.65p pd=3.02u as=1.525p ps=6.22u w=2.5u l=0.5u
X140 a_2717_12168# a_2717_9730# VSS ppolyf_u_1k r_width=3u r_length=11.55u
X141 tanh_ota_0.V_in_p V_w1 a_3415_21020# VSS nfet_03v3 ad=0.65p pd=3.02u as=0.65p ps=3.02u w=2.5u l=0.5u
X142 a_9805_17650# tanh_ota_0.V_ref VSS ppolyf_u_1k r_width=3u r_length=15u
X143 tanh_ota_0.V_in_n VSS VSS VSS nfet_03v3 ad=0.65p pd=3.02u as=1.525p ps=6.22u w=2.5u l=0.5u
X144 VSS tanh_ota_0.V_ref a_9196_7474# VSS nfet_03v3 ad=1.04p pd=4.52u as=1.04p ps=4.52u w=4u l=1u
X145 a_11555_17360# a_11555_17360# VSS VSS nfet_03v3 ad=0.39p pd=2.02u as=0.39p ps=2.02u w=1.5u l=0.5u
X146 a_2717_9730# tanh_ota_0.V_ref VSS VSS nfet_03v3 ad=1.04p pd=4.52u as=1.04p ps=4.52u w=4u l=1u
X147 VSS VSS a_3598_8020# VSS nfet_03v3 ad=2.44p pd=9.22u as=1.04p ps=4.52u w=4u l=1u
X148 VDD a_13492_1131# tanh_ota_0.V_ref VSS nfet_03v3 ad=2.6p pd=10.52u as=2.6p ps=10.52u w=10u l=1u
X149 a_13330_9664# a_19458_8812# VSS ppolyf_u_1k r_width=3u r_length=30u
X150 VDD VSS VSS VSS nfet_03v3 ad=2.6p pd=10.52u as=6.1p ps=21.22u w=10u l=1u
X151 a_13330_11368# a_19458_12220# VSS ppolyf_u_1k r_width=3u r_length=30u
X152 a_8355_9194# voltage_reference_0.v_1_25 a_7657_6436# VSS nfet_03v3 ad=1.3p pd=5.52u as=1.3p ps=5.52u w=5u l=0.5u
X153 tanh_ota_0.V_in_n V_w2 a_3619_2602# VSS nfet_03v3 ad=0.65p pd=3.02u as=0.65p ps=3.02u w=2.5u l=0.5u
X154 VSS a_11555_17360# a_11555_17360# VSS nfet_03v3 ad=0.39p pd=2.02u as=0.39p ps=2.02u w=1.5u l=0.5u
X155 voltage_reference_0.v_1_25 a_13492_24053# VDD VSS nfet_03v3 ad=2.6p pd=10.52u as=2.6p ps=10.52u w=10u l=1u
X156 VSS a_13250_5878# a_13250_5878# VSS nfet_03v3 ad=1.3p pd=5.52u as=1.3p ps=5.52u w=5u l=1u
X157 tanh_ota_0.V_in_p V_w2 a_3415_6100# VSS nfet_03v3 ad=0.65p pd=3.02u as=0.65p ps=3.02u w=2.5u l=0.5u
X158 VDD a_7766_18788# V_out_perceptron VDD pfet_03v3 ad=1.3p pd=5.52u as=1.3p ps=5.52u w=5u l=0.5u
X159 a_22199_13400# a_19854_15770# a_23777_13400# VDD pfet_03v3 ad=2.6p pd=10.52u as=2.6p ps=10.52u w=10u l=1u
X160 tanh_ota_0.V_in_p VSS VSS VSS nfet_03v3 ad=0.65p pd=3.02u as=1.525p ps=6.22u w=2.5u l=0.5u
X161 VSS a_13250_5878# a_13382_20226# VSS nfet_03v3 ad=0.65p pd=3.02u as=0.65p ps=3.02u w=2.5u l=2u
X162 a_21914_17004# a_26642_16152# VSS ppolyf_u_1k r_width=3u r_length=23u
X163 tanh_ota_0.V_in_p tanh_ota_0.V_ref a_8355_9194# VSS nfet_03v3 ad=0.65p pd=3.02u as=0.65p ps=3.02u w=2.5u l=0.5u
X164 tanh_ota_0.V_in_p tanh_ota_0.V_ref a_8355_9194# VSS nfet_03v3 ad=0.65p pd=3.02u as=0.65p ps=3.02u w=2.5u l=0.5u
X165 tanh_ota_0.V_in_n tanh_ota_0.V_ref a_3415_6100# VSS nfet_03v3 ad=0.65p pd=3.02u as=0.65p ps=3.02u w=2.5u l=0.5u
X166 a_7311_22424# a_11555_17360# VSS ppolyf_u_1k r_width=3u r_length=22u
X167 tanh_ota_0.V_in_n VSS VSS VSS nfet_03v3 ad=0.65p pd=3.02u as=1.525p ps=6.22u w=2.5u l=0.5u
X168 tanh_ota_0.V_in_n V_b a_8355_9194# VSS nfet_03v3 ad=0.65p pd=3.02u as=0.65p ps=3.02u w=2.5u l=0.5u
X169 VSS VSS a_14690_5774# VSS nfet_03v3 ad=3.05p pd=11.22u as=1.3p ps=5.52u w=5u l=2u
X170 a_19914_9664# a_26642_8812# VSS ppolyf_u_1k r_width=3u r_length=33u
X171 tanh_ota_0.V_in_n V_w1 a_3619_22696# VSS nfet_03v3 ad=0.65p pd=3.02u as=0.65p ps=3.02u w=2.5u l=0.5u
X172 a_19458_12220# a_19458_12220# VDD VDD pfet_03v3 ad=1.3p pd=5.52u as=1.3p ps=5.52u w=5u l=1u
X173 tanh_ota_0.V_in_p tanh_ota_0.V_ref a_3619_22696# VSS nfet_03v3 ad=0.65p pd=3.02u as=0.65p ps=3.02u w=2.5u l=0.5u
X174 tanh_ota_0.V_in_n V_w1 a_3619_22696# VSS nfet_03v3 ad=0.65p pd=3.02u as=0.65p ps=3.02u w=2.5u l=0.5u
X175 a_3415_21020# gilbert_multiplier_current_2.V_x_n a_2717_18262# VSS nfet_03v3 ad=1.3p pd=5.52u as=1.3p ps=5.52u w=5u l=0.5u
X176 VSS a_23777_13400# voltage_reference_0.v_1_15 VSS nfet_03v3 ad=1.3p pd=5.52u as=1.3p ps=5.52u w=5u l=1u
X177 tanh_ota_0.V_in_p VSS VSS VSS nfet_03v3 ad=0.65p pd=3.02u as=1.525p ps=6.22u w=2.5u l=0.5u
X178 tanh_ota_0.V_in_p VSS VSS VSS nfet_03v3 ad=0.65p pd=3.02u as=1.525p ps=6.22u w=2.5u l=0.5u
X179 a_3415_21020# VSS VSS VSS nfet_03v3 ad=1.3p pd=5.52u as=3.05p ps=11.22u w=5u l=0.5u
X180 VSS tanh_ota_0.V_ref a_3598_19300# VSS nfet_03v3 ad=1.04p pd=4.52u as=1.04p ps=4.52u w=4u l=1u
X181 VDD a_13492_1131# tanh_ota_0.V_ref VSS nfet_03v3 ad=2.6p pd=10.52u as=2.6p ps=10.52u w=10u l=1u
X182 a_13382_5774# tanh_ota_0.V_ref a_13492_1131# VSS nfet_03v3 ad=1.3p pd=5.52u as=1.3p ps=5.52u w=5u l=2u
X183 tanh_ota_0.V_in_p tanh_ota_0.V_ref a_3619_2602# VSS nfet_03v3 ad=0.65p pd=3.02u as=0.65p ps=3.02u w=2.5u l=0.5u
X184 tanh_ota_0.V_in_n tanh_ota_0.V_ref a_3415_21020# VSS nfet_03v3 ad=0.65p pd=3.02u as=0.65p ps=3.02u w=2.5u l=0.5u
X185 a_13330_17856# a_19458_17004# VSS ppolyf_u_1k r_width=3u r_length=30u
X186 a_22199_13400# VDD VDD VDD pfet_03v3 ad=1.3p pd=5.52u as=3.25p ps=11.3u w=5u l=1u
X187 tanh_ota_0.V_in_p VSS VSS VSS nfet_03v3 ad=0.65p pd=3.02u as=1.525p ps=6.22u w=2.5u l=0.5u
X188 VSS a_11555_17360# a_11555_17360# VSS nfet_03v3 ad=0.39p pd=2.02u as=0.39p ps=2.02u w=1.5u l=0.5u
X189 VSS VSS tanh_ota_0.V_in_n VSS nfet_03v3 ad=1.525p pd=6.22u as=0.65p ps=3.02u w=2.5u l=0.5u
X190 a_13382_5774# a_14558_5878# a_14690_5774# VSS nfet_03v3 ad=1.3p pd=5.52u as=1.3p ps=5.52u w=5u l=2u
X191 tanh_ota_0.V_in_n tanh_ota_0.V_ref a_3415_21020# VSS nfet_03v3 ad=0.65p pd=3.02u as=0.65p ps=3.02u w=2.5u l=0.5u
X192 VSS a_11555_17360# a_11555_17360# VSS nfet_03v3 ad=0.39p pd=2.02u as=0.39p ps=2.02u w=1.5u l=0.5u
X193 a_13382_20226# a_14558_20330# a_14690_20226# VSS nfet_03v3 ad=1.3p pd=5.52u as=1.3p ps=5.52u w=5u l=2u
X194 tanh_ota_0.V_in_p V_w2 a_3415_6100# VSS nfet_03v3 ad=0.65p pd=3.02u as=0.65p ps=3.02u w=2.5u l=0.5u
X195 VSS tanh_ota_0.V_ref a_7657_6436# VSS nfet_03v3 ad=1.04p pd=4.52u as=1.04p ps=4.52u w=4u l=1u
X196 VDD a_7766_18788# V_out_perceptron VDD pfet_03v3 ad=1.3p pd=5.52u as=1.3p ps=5.52u w=5u l=0.5u
X197 a_7657_6436# a_7657_3998# VSS ppolyf_u_1k r_width=3u r_length=11.55u
X198 a_8559_11644# tanh_ota_0.V_ref tanh_ota_0.V_in_n VSS nfet_03v3 ad=0.65p pd=3.02u as=0.65p ps=3.02u w=2.5u l=0.5u
X199 tanh_ota_0.V_ref a_13492_1131# VDD VSS nfet_03v3 ad=2.6p pd=10.52u as=2.6p ps=10.52u w=10u l=1u
X200 a_11555_17360# a_11555_17360# VSS VSS nfet_03v3 ad=0.39p pd=2.02u as=0.39p ps=2.02u w=1.5u l=0.5u
X201 a_8559_11644# V_b tanh_ota_0.V_in_p VSS nfet_03v3 ad=0.65p pd=3.02u as=0.65p ps=3.02u w=2.5u l=0.5u
X202 a_3598_8020# VSS VSS VSS nfet_03v3 ad=1.04p pd=4.52u as=2.44p ps=9.22u w=4u l=1u
X203 VDD a_13492_1131# tanh_ota_0.V_ref VSS nfet_03v3 ad=2.6p pd=10.52u as=2.6p ps=10.52u w=10u l=1u
X204 tanh_ota_0.V_in_n V_b a_8355_9194# VSS nfet_03v3 ad=0.65p pd=3.02u as=0.65p ps=3.02u w=2.5u l=0.5u
X205 VSS VSS tanh_ota_0.V_in_p VSS nfet_03v3 ad=1.525p pd=6.22u as=0.65p ps=3.02u w=2.5u l=0.5u
X206 tanh_ota_0.V_in_p tanh_ota_0.V_ref a_8355_9194# VSS nfet_03v3 ad=0.65p pd=3.02u as=0.65p ps=3.02u w=2.5u l=0.5u
X207 a_22199_13400# a_19458_12220# VDD VDD pfet_03v3 ad=1.3p pd=5.52u as=1.3p ps=5.52u w=5u l=1u
X208 a_19914_9664# a_26642_10516# VSS ppolyf_u_1k r_width=3u r_length=33u
X209 a_3619_22696# voltage_reference_0.v_1_25 a_3598_19300# VSS nfet_03v3 ad=1.3p pd=5.52u as=1.3p ps=5.52u w=5u l=0.5u
X210 VDD tanh_ota_0.V_in_n VSS ppolyf_u_1k r_width=3u r_length=7.3u
X211 V_out_perceptron tanh_ota_0.V_in_n a_10295_19296# VSS nfet_03v3 ad=1.3p pd=5.52u as=1.3p ps=5.52u w=5u l=0.5u
X212 a_2717_9730# gilbert_multiplier_current_1.V_x_n a_3415_6100# VSS nfet_03v3 ad=1.3p pd=5.52u as=1.3p ps=5.52u w=5u l=0.5u
X213 tanh_ota_0.V_in_p tanh_ota_0.V_ref a_3619_22696# VSS nfet_03v3 ad=0.65p pd=3.02u as=0.65p ps=3.02u w=2.5u l=0.5u
X214 a_3619_22696# VSS VSS VSS nfet_03v3 ad=1.3p pd=5.52u as=3.05p ps=11.22u w=5u l=0.5u
X215 tanh_ota_0.V_in_n V_w1 a_3619_22696# VSS nfet_03v3 ad=0.65p pd=3.02u as=0.65p ps=3.02u w=2.5u l=0.5u
X216 a_11555_17360# a_11555_17360# VSS VSS nfet_03v3 ad=0.39p pd=2.02u as=0.39p ps=2.02u w=1.5u l=0.5u
X217 VSS VSS tanh_ota_0.V_in_p VSS nfet_03v3 ad=1.525p pd=6.22u as=0.65p ps=3.02u w=2.5u l=0.5u
X218 tanh_ota_0.V_in_p V_w1 a_3415_21020# VSS nfet_03v3 ad=0.65p pd=3.02u as=0.65p ps=3.02u w=2.5u l=0.5u
X219 a_13250_5878# a_19458_15300# VSS ppolyf_u_1k r_width=3u r_length=30u
X220 tanh_ota_0.V_in_n tanh_ota_0.V_ref a_3415_21020# VSS nfet_03v3 ad=0.65p pd=3.02u as=0.65p ps=3.02u w=2.5u l=0.5u
X221 VDD VDD a_14690_20226# VDD pfet_03v3 ad=6.5p pd=21.3u as=2.6p ps=10.52u w=10u l=2u
X222 a_21914_18708# a_26642_17856# VSS ppolyf_u_1k r_width=3u r_length=23u
X223 tanh_ota_0.V_in_p tanh_ota_0.V_ref a_3619_2602# VSS nfet_03v3 ad=0.65p pd=3.02u as=0.65p ps=3.02u w=2.5u l=0.5u
X224 VDD a_13492_24053# voltage_reference_0.v_1_25 VSS nfet_03v3 ad=2.6p pd=10.52u as=2.6p ps=10.52u w=10u l=1u
X225 a_11555_17360# a_11555_17360# VSS VSS nfet_03v3 ad=0.39p pd=2.02u as=0.39p ps=2.02u w=1.5u l=0.5u
X226 VSS VSS tanh_ota_0.V_in_p VSS nfet_03v3 ad=1.525p pd=6.22u as=0.65p ps=3.02u w=2.5u l=0.5u
X227 a_7657_6436# tanh_ota_0.V_ref VSS VSS nfet_03v3 ad=1.04p pd=4.52u as=1.04p ps=4.52u w=4u l=1u
X228 tanh_ota_0.V_in_p V_w1 a_3415_21020# VSS nfet_03v3 ad=0.65p pd=3.02u as=0.65p ps=3.02u w=2.5u l=0.5u
X229 a_13330_11368# a_19458_10516# VSS ppolyf_u_1k r_width=3u r_length=30u
X230 tanh_ota_0.V_in_n VSS VSS VSS nfet_03v3 ad=0.65p pd=3.02u as=1.525p ps=6.22u w=2.5u l=0.5u
X231 tanh_ota_0.V_in_n VSS VSS VSS nfet_03v3 ad=0.65p pd=3.02u as=1.525p ps=6.22u w=2.5u l=0.5u
X232 voltage_reference_0.v_1_25 a_13492_24053# VDD VSS nfet_03v3 ad=2.6p pd=10.52u as=2.6p ps=10.52u w=10u l=1u
X233 VSS VSS VSS VSS nfet_03v3 ad=0.39p pd=2.02u as=0.18551n ps=0.72964m w=1.5u l=0.5u
X234 VDD a_14690_20226# a_13492_24053# VDD pfet_03v3 ad=2.6p pd=10.52u as=2.6p ps=10.52u w=10u l=2u
X235 a_21914_18708# VSS VSS ppolyf_u_1k r_width=3u r_length=23u
X236 VSS VSS a_23777_13400# VSS nfet_03v3 ad=3.05p pd=11.22u as=1.3p ps=5.52u w=5u l=1u
X237 a_7311_24128# a_11839_24980# VSS ppolyf_u_1k r_width=3u r_length=22u
X238 gilbert_multiplier_current_1.V_x_n voltage_reference_0.v_1_25 I_x2 VSS nfet_03v3 ad=0.65p pd=3.02u as=1.525p ps=6.22u w=2.5u l=0.5u
X239 VSS VSS a_13250_5878# VSS nfet_03v3 ad=3.05p pd=11.22u as=1.3p ps=5.52u w=5u l=1u
X240 a_14690_5774# a_14558_5878# a_13382_5774# VSS nfet_03v3 ad=1.3p pd=5.52u as=1.3p ps=5.52u w=5u l=2u
X241 a_3598_8020# voltage_reference_0.v_1_25 a_3619_2602# VSS nfet_03v3 ad=1.3p pd=5.52u as=1.3p ps=5.52u w=5u l=0.5u
X242 a_22199_13400# voltage_reference_0.v_1_15 voltage_reference_0.v_1_15 VDD pfet_03v3 ad=2.6p pd=10.52u as=2.6p ps=10.52u w=10u l=1u
X243 a_7657_6436# voltage_reference_0.v_1_25 a_8355_9194# VSS nfet_03v3 ad=1.3p pd=5.52u as=1.3p ps=5.52u w=5u l=0.5u
X244 a_7311_24128# a_11839_23276# VSS ppolyf_u_1k r_width=3u r_length=22u
X245 a_13492_1131# tanh_ota_0.V_ref a_13382_5774# VSS nfet_03v3 ad=1.3p pd=5.52u as=1.3p ps=5.52u w=5u l=2u
X246 tanh_ota_0.V_in_n tanh_ota_0.V_ref a_3415_6100# VSS nfet_03v3 ad=0.65p pd=3.02u as=0.65p ps=3.02u w=2.5u l=0.5u
X247 a_11555_17360# a_11555_17360# VSS VSS nfet_03v3 ad=0.39p pd=2.02u as=0.39p ps=2.02u w=1.5u l=0.5u
X248 a_8559_11644# tanh_ota_0.V_ref tanh_ota_0.V_in_n VSS nfet_03v3 ad=0.65p pd=3.02u as=0.65p ps=3.02u w=2.5u l=0.5u
X249 tanh_ota_0.V_ref a_13492_1131# VDD VSS nfet_03v3 ad=2.6p pd=10.52u as=2.6p ps=10.52u w=10u l=1u
X250 tanh_ota_0.V_in_n V_w2 a_3619_2602# VSS nfet_03v3 ad=0.65p pd=3.02u as=0.65p ps=3.02u w=2.5u l=0.5u
X251 VSS a_19458_8812# VSS ppolyf_u_1k r_width=3u r_length=30u
X252 VSS VSS a_7766_18788# VSS nfet_03v3 ad=3.05p pd=11.22u as=1.3p ps=5.52u w=5u l=0.5u
X253 VDD a_19458_12220# a_19458_12220# VDD pfet_03v3 ad=1.3p pd=5.52u as=1.3p ps=5.52u w=5u l=1u
X254 a_8559_11644# V_b tanh_ota_0.V_in_p VSS nfet_03v3 ad=0.65p pd=3.02u as=0.65p ps=3.02u w=2.5u l=0.5u
X255 a_8559_11644# V_b tanh_ota_0.V_in_p VSS nfet_03v3 ad=0.65p pd=3.02u as=0.65p ps=3.02u w=2.5u l=0.5u
X256 a_3619_2602# V_w2 tanh_ota_0.V_in_n VSS nfet_03v3 ad=0.65p pd=3.02u as=0.65p ps=3.02u w=2.5u l=0.5u
X257 VDD VDD a_14690_5774# VDD pfet_03v3 ad=6.5p pd=21.3u as=2.6p ps=10.52u w=10u l=2u
X258 a_14690_5774# VSS VSS VSS nfet_03v3 ad=1.3p pd=5.52u as=3.05p ps=11.22u w=5u l=2u
X259 a_3561_18262# a_2717_15824# VSS ppolyf_u_1k r_width=3u r_length=11.55u
X260 a_8559_11644# tanh_ota_0.V_ref tanh_ota_0.V_in_n VSS nfet_03v3 ad=0.65p pd=3.02u as=0.65p ps=3.02u w=2.5u l=0.5u
X261 voltage_reference_0.v_1_15 a_23777_13400# VSS VSS nfet_03v3 ad=1.3p pd=5.52u as=1.3p ps=5.52u w=5u l=1u
X262 a_3598_19300# tanh_ota_0.V_ref VSS VSS nfet_03v3 ad=1.04p pd=4.52u as=1.04p ps=4.52u w=4u l=1u
X263 VDD a_7766_18788# a_7766_18788# VDD pfet_03v3 ad=1.3p pd=5.52u as=1.3p ps=5.52u w=5u l=0.5u
X264 VDD a_14690_5774# a_13492_1131# VDD pfet_03v3 ad=2.6p pd=10.52u as=2.6p ps=10.52u w=10u l=2u
X265 tanh_ota_0.V_in_n tanh_ota_0.V_ref a_3415_6100# VSS nfet_03v3 ad=0.65p pd=3.02u as=0.65p ps=3.02u w=2.5u l=0.5u
X266 a_8501_6436# a_7657_3998# VSS ppolyf_u_1k r_width=3u r_length=11.55u
X267 VSS VSS tanh_ota_0.V_in_n VSS nfet_03v3 ad=1.525p pd=6.22u as=0.65p ps=3.02u w=2.5u l=0.5u
X268 a_14558_20330# a_19854_15770# VSS ppolyf_u_1k r_width=3u r_length=10u
X269 a_4405_12168# a_3561_9730# VSS ppolyf_u_1k r_width=3u r_length=11.55u
X270 a_9196_7474# voltage_reference_0.v_1_15 a_8559_11644# VSS nfet_03v3 ad=1.3p pd=5.52u as=1.3p ps=5.52u w=5u l=0.5u
X271 VDD a_14690_5774# a_14690_5774# VDD pfet_03v3 ad=2.6p pd=10.52u as=2.6p ps=10.52u w=10u l=2u
X272 a_19914_7960# a_26642_8812# VSS ppolyf_u_1k r_width=3u r_length=33u
X273 I_x1 voltage_reference_0.v_1_25 gilbert_multiplier_current_2.V_x_n VSS nfet_03v3 ad=1.525p pd=6.22u as=0.65p ps=3.02u w=2.5u l=0.5u
X274 tanh_ota_0.V_in_n tanh_ota_0.V_ref a_3415_21020# VSS nfet_03v3 ad=0.65p pd=3.02u as=0.65p ps=3.02u w=2.5u l=0.5u
X275 V_out_perceptron a_7766_18788# VDD VDD pfet_03v3 ad=1.3p pd=5.52u as=1.3p ps=5.52u w=5u l=0.5u
X276 a_14690_20226# a_14690_20226# VDD VDD pfet_03v3 ad=2.6p pd=10.52u as=2.6p ps=10.52u w=10u l=2u
X277 a_3619_2602# tanh_ota_0.V_ref tanh_ota_0.V_in_p VSS nfet_03v3 ad=0.65p pd=3.02u as=0.65p ps=3.02u w=2.5u l=0.5u
X278 tanh_ota_0.V_in_p V_w1 a_3415_21020# VSS nfet_03v3 ad=0.65p pd=3.02u as=0.65p ps=3.02u w=2.5u l=0.5u
X279 a_13382_20226# VSS VSS VSS nfet_03v3 ad=0.65p pd=3.02u as=1.525p ps=6.22u w=2.5u l=2u
X280 tanh_ota_0.V_ref a_13492_1131# VDD VSS nfet_03v3 ad=2.6p pd=10.52u as=2.6p ps=10.52u w=10u l=1u
X281 VSS VSS tanh_ota_0.V_in_n VSS nfet_03v3 ad=1.525p pd=6.22u as=0.65p ps=3.02u w=2.5u l=0.5u
X282 VSS VSS tanh_ota_0.V_in_n VSS nfet_03v3 ad=1.525p pd=6.22u as=0.65p ps=3.02u w=2.5u l=0.5u
X283 a_11555_17360# a_11555_17360# VSS VSS nfet_03v3 ad=0.39p pd=2.02u as=0.39p ps=2.02u w=1.5u l=0.5u
X284 a_11555_17360# a_11555_17360# VSS VSS nfet_03v3 ad=0.39p pd=2.02u as=0.39p ps=2.02u w=1.5u l=0.5u
X285 a_13492_24053# a_14690_20226# VDD VDD pfet_03v3 ad=2.6p pd=10.52u as=2.6p ps=10.52u w=10u l=2u
X286 gilbert_multiplier_current_2.V_x_n voltage_reference_0.v_1_25 VSS ppolyf_u_1k r_width=3u r_length=8.1u
X287 a_3415_6100# V_w2 tanh_ota_0.V_in_p VSS nfet_03v3 ad=0.65p pd=3.02u as=0.65p ps=3.02u w=2.5u l=0.5u
X288 a_9196_7474# tanh_ota_0.V_ref VSS VSS nfet_03v3 ad=1.04p pd=4.52u as=1.04p ps=4.52u w=4u l=1u
X289 VDD a_13492_24053# voltage_reference_0.v_1_25 VSS nfet_03v3 ad=2.6p pd=10.52u as=2.6p ps=10.52u w=10u l=1u
X290 a_10295_19296# tanh_ota_0.V_in_p a_7766_18788# VSS nfet_03v3 ad=1.3p pd=5.52u as=1.3p ps=5.52u w=5u l=0.5u
X291 a_2717_12168# a_3561_9730# VSS ppolyf_u_1k r_width=3u r_length=11.55u
X292 VSS tanh_ota_0.V_ref a_3598_8020# VSS nfet_03v3 ad=1.04p pd=4.52u as=1.04p ps=4.52u w=4u l=1u
X293 V_out_perceptron a_7766_18788# VDD VDD pfet_03v3 ad=1.3p pd=5.52u as=1.3p ps=5.52u w=5u l=0.5u
X294 a_14690_20226# VSS VSS VSS nfet_03v3 ad=1.3p pd=5.52u as=3.05p ps=11.22u w=5u l=2u
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
