valrek-sol/analog-perceptron-gf180mcu/pex/out/pex/perceptron_core_pex_rc.spice

* perceptron_core_pex_rc — Magic RC extraction of perceptron_core (layout/perceptron/perceptron_core.gds)
* generated by pex/pex.tcl, see pex/out/env.txt for provenance
* ports (schematic order): VDD V_shift V_w1 I_x1 V_out_perceptron V_b I_x2 V_w2 VSS
* NGSPICE file created from perceptron_core.ext - technology: gf180mcuD

.subckt perceptron_core_pex_rc VDD V_shift V_w1 I_x1 V_out_perceptron V_b I_x2 V_w2 VSS
X0 a_8355_9194# tanh_ota_0.V_ref tanh_ota_0.V_in_p VSS.t58 nfet_03v3 ad=0.65p pd=3.02u as=0.65p ps=3.02u w=2.5u l=0.5u
X1 a_3415_6100# tanh_ota_0.V_ref tanh_ota_0.V_in_n VSS.t81 nfet_03v3 ad=0.65p pd=3.02u as=0.65p ps=3.02u w=2.5u l=0.5u
X2 a_2717_18262# a_2717_15824# VSS.t32 ppolyf_u_1k r_width=3u r_length=11.55u
X3 a_8355_9194# V_b.t13 tanh_ota_0.V_in_n VSS.t62 nfet_03v3 ad=0.65p pd=3.02u as=0.65p ps=3.02u w=2.5u l=0.5u
X4 VDD.t44 a_14690_20226# a_14690_20226# VDD.t43 pfet_03v3 ad=2.6p pd=10.52u as=2.6p ps=10.52u w=10u l=2u
X5 a_8355_9194# V_b.t2 tanh_ota_0.V_in_n VSS.t57 nfet_03v3 ad=0.65p pd=3.02u as=0.65p ps=3.02u w=2.5u l=0.5u
X6 a_3415_6100# V_w2.t7 tanh_ota_0.V_in_p VSS.t7 nfet_03v3 ad=0.65p pd=3.02u as=0.65p ps=3.02u w=2.5u l=0.5u
X7 a_3619_22696# V_w1.t0 tanh_ota_0.V_in_n VSS.t47 nfet_03v3 ad=0.65p pd=3.02u as=0.65p ps=3.02u w=2.5u l=0.5u
X8 a_3598_19300# voltage_reference_0.v_1_25 a_3619_22696# VSS.t88 nfet_03v3 ad=1.3p pd=5.52u as=1.3p ps=5.52u w=5u l=0.5u
X9 a_7766_18788# VDD.t67 VDD.t69 VDD.t68 pfet_03v3 ad=1.3p pd=5.52u as=3.25p ps=11.3u w=5u l=0.5u
X10 a_19854_15770# a_26642_16152# VSS.t9 ppolyf_u_1k r_width=3u r_length=23u
X11 a_8355_9194# tanh_ota_0.V_ref tanh_ota_0.V_in_p VSS.t60 nfet_03v3 ad=0.65p pd=3.02u as=0.65p ps=3.02u w=2.5u l=0.5u
X12 a_3619_22696# tanh_ota_0.V_ref tanh_ota_0.V_in_p VSS.t44 nfet_03v3 ad=0.65p pd=3.02u as=0.65p ps=3.02u w=2.5u l=0.5u
X13 a_3619_22696# tanh_ota_0.V_ref tanh_ota_0.V_in_p VSS.t47 nfet_03v3 ad=0.65p pd=3.02u as=0.65p ps=3.02u w=2.5u l=0.5u
X14 a_8559_11644# VSS.t206 VSS.t207 VSS.t103 nfet_03v3 ad=1.3p pd=5.52u as=3.05p ps=11.22u w=5u l=0.5u
X15 a_3619_22696# V_w1.t15 tanh_ota_0.V_in_n VSS.t44 nfet_03v3 ad=0.65p pd=3.02u as=0.65p ps=3.02u w=2.5u l=0.5u
X16 a_3415_21020# tanh_ota_0.V_ref tanh_ota_0.V_in_n VSS.t45 nfet_03v3 ad=0.65p pd=3.02u as=0.65p ps=3.02u w=2.5u l=0.5u
X17 a_11555_17360# a_11555_17360# VSS.t281 VSS.t280 nfet_03v3 ad=0.39p pd=2.02u as=0.39p ps=2.02u w=1.5u l=0.5u
X18 a_11555_17360# a_11555_17360# VSS.t295 VSS.t294 nfet_03v3 ad=0.39p pd=2.02u as=0.39p ps=2.02u w=1.5u l=0.5u
X19 a_13330_17856# VDD.t36 VSS.t102 ppolyf_u_1k r_width=3u r_length=30u
X20 a_3619_2602# V_w2.t12 tanh_ota_0.V_in_n VSS.t85 nfet_03v3 ad=0.65p pd=3.02u as=0.65p ps=3.02u w=2.5u l=0.5u
X21 a_3415_21020# V_w1.t9 tanh_ota_0.V_in_p VSS.t45 nfet_03v3 ad=0.65p pd=3.02u as=0.65p ps=3.02u w=2.5u l=0.5u
X22 VDD.t29 a_13492_24053# voltage_reference_0.v_1_25 VSS.t95 nfet_03v3 ad=2.6p pd=10.52u as=2.6p ps=10.52u w=10u l=1u
X23 a_7766_18788# VSS.t128 VSS.t130 VSS.t129 nfet_03v3 ad=1.3p pd=5.52u as=3.05p ps=11.22u w=5u l=0.5u
X24 a_13250_5878# VSS.t122 VSS.t124 VSS.t123 nfet_03v3 ad=1.3p pd=5.52u as=3.05p ps=11.22u w=5u l=1u
X25 VSS.t138 VSS.t137 tanh_ota_0.V_in_n VSS.t46 nfet_03v3 ad=1.525p pd=6.22u as=0.65p ps=3.02u w=2.5u l=0.5u
X26 a_3598_19300# a_4405_15824# VSS.t101 ppolyf_u_1k r_width=3u r_length=11.55u
X27 a_23777_13400# VDD.t85 VDD.t86 VDD.t35 pfet_03v3 ad=2.6p pd=10.52u as=6.5p ps=21.3u w=10u l=1u
X28 a_3561_18262# a_4405_15824# VSS.t5 ppolyf_u_1k r_width=3u r_length=11.55u
X29 VSS.t178 VSS.t177 tanh_ota_0.V_in_n VSS.t58 nfet_03v3 ad=1.525p pd=6.22u as=0.65p ps=3.02u w=2.5u l=0.5u
X30 a_3415_6100# tanh_ota_0.V_ref tanh_ota_0.V_in_n VSS.t85 nfet_03v3 ad=0.65p pd=3.02u as=0.65p ps=3.02u w=2.5u l=0.5u
X31 a_7657_6436# VSS.t224 VSS.t226 VSS.t225 nfet_03v3 ad=1.04p pd=4.52u as=2.44p ps=9.22u w=4u l=1u
X32 VSS.t279 a_11555_17360# a_11555_17360# VSS.t278 nfet_03v3 ad=0.39p pd=2.02u as=0.39p ps=2.02u w=1.5u l=0.5u
X33 VSS.t293 a_11555_17360# a_11555_17360# VSS.t292 nfet_03v3 ad=0.39p pd=2.02u as=0.39p ps=2.02u w=1.5u l=0.5u
X34 VSS.t259 voltage_reference_0.v_1_25 VSS.t258 ppolyf_u_1k r_width=3u r_length=20u
X35 tanh_ota_0.V_in_n tanh_ota_0.V_ref a_8559_11644# VSS.t56 nfet_03v3 ad=0.65p pd=3.02u as=0.65p ps=3.02u w=2.5u l=0.5u
X36 tanh_ota_0.V_in_p VSS.t185 VSS.t186 VSS.t116 nfet_03v3 ad=0.65p pd=3.02u as=1.525p ps=6.22u w=2.5u l=0.5u
X37 a_7766_18788# tanh_ota_0.V_in_p a_10295_19296# VSS.t107 nfet_03v3 ad=1.3p pd=5.52u as=1.3p ps=5.52u w=5u l=0.5u
X38 VSS.t244 VSS.t243 a_13382_5774# VSS.t238 nfet_03v3 ad=1.525p pd=6.22u as=0.65p ps=3.02u w=2.5u l=2u
X39 VDD.t25 a_13492_24053# voltage_reference_0.v_1_25 VSS.t91 nfet_03v3 ad=2.6p pd=10.52u as=2.6p ps=10.52u w=10u l=1u
X40 a_8355_9194# tanh_ota_0.V_ref tanh_ota_0.V_in_p VSS.t57 nfet_03v3 ad=0.65p pd=3.02u as=0.65p ps=3.02u w=2.5u l=0.5u
X41 tanh_ota_0.V_in_n tanh_ota_0.V_ref a_8559_11644# VSS.t61 nfet_03v3 ad=0.65p pd=3.02u as=0.65p ps=3.02u w=2.5u l=0.5u
X42 VDD.t16 a_7766_18788# a_7766_18788# VDD.t15 pfet_03v3 ad=1.3p pd=5.52u as=1.3p ps=5.52u w=5u l=0.5u
X43 a_8355_9194# V_b.t15 tanh_ota_0.V_in_n VSS.t60 nfet_03v3 ad=0.65p pd=3.02u as=0.65p ps=3.02u w=2.5u l=0.5u
X44 VSS.t152 VSS.t151 a_3415_21020# VSS.t88 nfet_03v3 ad=3.05p pd=11.22u as=1.3p ps=5.52u w=5u l=0.5u
X45 a_23777_13400# a_19854_15770# a_22199_13400# VDD.t35 pfet_03v3 ad=2.6p pd=10.52u as=2.6p ps=10.52u w=10u l=1u
X46 VSS.t26 a_13250_5878# a_13382_5774# VSS.t25 nfet_03v3 ad=0.65p pd=3.02u as=0.65p ps=3.02u w=2.5u l=2u
X47 a_3415_6100# VSS.t220 VSS.t221 VSS.t211 nfet_03v3 ad=1.3p pd=5.52u as=3.05p ps=11.22u w=5u l=0.5u
X48 a_3619_22696# V_w1.t2 tanh_ota_0.V_in_n VSS.t47 nfet_03v3 ad=0.65p pd=3.02u as=0.65p ps=3.02u w=2.5u l=0.5u
X49 a_2717_18262# gilbert_multiplier_current_2.V_x_n a_3415_21020# VSS.t88 nfet_03v3 ad=1.3p pd=5.52u as=1.3p ps=5.52u w=5u l=0.5u
X50 a_3619_2602# tanh_ota_0.V_ref tanh_ota_0.V_in_p VSS.t83 nfet_03v3 ad=0.65p pd=3.02u as=0.65p ps=3.02u w=2.5u l=0.5u
X51 a_3619_22696# tanh_ota_0.V_ref tanh_ota_0.V_in_p VSS.t47 nfet_03v3 ad=0.65p pd=3.02u as=0.65p ps=3.02u w=2.5u l=0.5u
X52 VDD.t56 a_13492_1131# tanh_ota_0.V_ref VSS.t313 nfet_03v3 ad=2.6p pd=10.52u as=2.6p ps=10.52u w=10u l=1u
X53 a_3415_21020# tanh_ota_0.V_ref tanh_ota_0.V_in_n VSS.t45 nfet_03v3 ad=0.65p pd=3.02u as=0.65p ps=3.02u w=2.5u l=0.5u
X54 VSS.t267 a_11555_17360# a_11555_17360# VSS.t266 nfet_03v3 ad=0.39p pd=2.02u as=0.39p ps=2.02u w=1.5u l=0.5u
X55 VSS.t163 VSS.t161 a_13382_20226# VSS.t162 nfet_03v3 ad=1.525p pd=6.22u as=0.65p ps=3.02u w=2.5u l=2u
X56 VSS.t30 a_13250_5878# a_13382_5774# VSS.t29 nfet_03v3 ad=0.65p pd=3.02u as=0.65p ps=3.02u w=2.5u l=2u
X57 VSS.t209 VSS.t208 a_8559_11644# VSS.t103 nfet_03v3 ad=3.05p pd=11.22u as=1.3p ps=5.52u w=5u l=0.5u
X58 a_3415_21020# V_w1.t11 tanh_ota_0.V_in_p VSS.t45 nfet_03v3 ad=0.65p pd=3.02u as=0.65p ps=3.02u w=2.5u l=0.5u
X59 a_3415_21020# V_w1.t4 tanh_ota_0.V_in_p VSS.t46 nfet_03v3 ad=0.65p pd=3.02u as=0.65p ps=3.02u w=2.5u l=0.5u
X60 gilbert_multiplier_current_2.V_x_n voltage_reference_0.v_1_25 I_x1.t0 VSS.t260 nfet_03v3 ad=0.65p pd=3.02u as=1.525p ps=6.22u w=2.5u l=0.5u
X61 a_3415_6100# tanh_ota_0.V_ref tanh_ota_0.V_in_n VSS.t7 nfet_03v3 ad=0.65p pd=3.02u as=0.65p ps=3.02u w=2.5u l=0.5u
X62 VDD.t47 a_11839_24980# VSS.t264 ppolyf_u_1k r_width=3u r_length=22u
X63 a_3415_21020# tanh_ota_0.V_ref tanh_ota_0.V_in_n VSS.t46 nfet_03v3 ad=0.65p pd=3.02u as=0.65p ps=3.02u w=2.5u l=0.5u
X64 VSS.t17 a_13250_5878# a_13382_20226# VSS.t16 nfet_03v3 ad=0.65p pd=3.02u as=0.65p ps=3.02u w=2.5u l=2u
X65 a_21914_17004# a_26642_17856# VSS.t9 ppolyf_u_1k r_width=3u r_length=23u
X66 a_14558_5878# a_19467_13334# VSS.t304 ppolyf_u_1k r_width=3u r_length=20u
X67 tanh_ota_0.V_ref a_13492_1131# VDD.t49 VSS.t306 nfet_03v3 ad=2.6p pd=10.52u as=2.6p ps=10.52u w=10u l=1u
X68 a_10295_19296# a_11555_17360# VSS.t283 VSS.t4 nfet_03v3 ad=0.39p pd=2.02u as=0.39p ps=2.02u w=1.5u l=0.5u
X69 VDD.t6 a_19458_12220# a_22199_13400# VDD.t4 pfet_03v3 ad=1.3p pd=5.52u as=1.3p ps=5.52u w=5u l=1u
X70 a_3619_2602# voltage_reference_0.v_1_25 a_3598_8020# VSS.t82 nfet_03v3 ad=1.3p pd=5.52u as=1.3p ps=5.52u w=5u l=0.5u
X71 V_out_perceptron.t6 a_8953_14522# VSS.t87 ppolyf_u_1k r_width=3u r_length=15u
X72 a_3598_8020# tanh_ota_0.V_ref VSS.t72 VSS.t71 nfet_03v3 ad=1.04p pd=4.52u as=1.04p ps=4.52u w=4u l=1u
X73 a_11555_17360# a_11555_17360# VSS.t299 VSS.t298 nfet_03v3 ad=0.39p pd=2.02u as=0.39p ps=2.02u w=1.5u l=0.5u
X74 VSS.t174 VSS.t173 a_14690_20226# VSS.t162 nfet_03v3 ad=3.05p pd=11.22u as=1.3p ps=5.52u w=5u l=2u
X75 tanh_ota_0.V_in_p V_b.t8 a_8559_11644# VSS.t59 nfet_03v3 ad=0.65p pd=3.02u as=0.65p ps=3.02u w=2.5u l=0.5u
X76 tanh_ota_0.V_in_p tanh_ota_0.V_ref a_3619_2602# VSS.t84 nfet_03v3 ad=0.65p pd=3.02u as=0.65p ps=3.02u w=2.5u l=0.5u
X77 a_3619_2602# V_w2.t14 tanh_ota_0.V_in_n VSS.t83 nfet_03v3 ad=0.65p pd=3.02u as=0.65p ps=3.02u w=2.5u l=0.5u
X78 VSS.t53 tanh_ota_0.V_ref a_2717_18262# VSS.t52 nfet_03v3 ad=1.04p pd=4.52u as=1.04p ps=4.52u w=4u l=1u
X79 tanh_ota_0.V_in_n tanh_ota_0.V_ref a_8559_11644# VSS.t59 nfet_03v3 ad=0.65p pd=3.02u as=0.65p ps=3.02u w=2.5u l=0.5u
X80 a_8355_9194# VSS.t204 VSS.t205 VSS.t116 nfet_03v3 ad=1.3p pd=5.52u as=3.05p ps=11.22u w=5u l=0.5u
X81 a_3415_6100# V_w2.t8 tanh_ota_0.V_in_p VSS.t85 nfet_03v3 ad=0.65p pd=3.02u as=0.65p ps=3.02u w=2.5u l=0.5u
X82 a_7311_22424# a_11839_23276# VSS.t0 ppolyf_u_1k r_width=3u r_length=22u
X83 voltage_reference_0.v_1_25 a_13492_24053# VDD.t34 VSS.t100 nfet_03v3 ad=2.6p pd=10.52u as=2.6p ps=10.52u w=10u l=1u
X84 a_7766_18788# a_7766_18788# VDD.t10 VDD.t9 pfet_03v3 ad=1.3p pd=5.52u as=1.3p ps=5.52u w=5u l=0.5u
X85 a_13382_20226# voltage_reference_0.v_1_25 a_13492_24053# VSS.t16 nfet_03v3 ad=1.3p pd=5.52u as=1.3p ps=5.52u w=5u l=2u
X86 tanh_ota_0.V_in_p V_b.t7 a_8559_11644# VSS.t56 nfet_03v3 ad=0.65p pd=3.02u as=0.65p ps=3.02u w=2.5u l=0.5u
X87 tanh_ota_0.V_in_n V_w2.t2 a_3619_2602# VSS.t80 nfet_03v3 ad=0.65p pd=3.02u as=0.65p ps=3.02u w=2.5u l=0.5u
X88 VSS.t297 a_11555_17360# a_11555_17360# VSS.t296 nfet_03v3 ad=0.39p pd=2.02u as=0.39p ps=2.02u w=1.5u l=0.5u
X89 tanh_ota_0.V_in_n VSS.t118 VSS.t119 VSS.t116 nfet_03v3 ad=0.65p pd=3.02u as=1.525p ps=6.22u w=2.5u l=0.5u
X90 a_3415_6100# tanh_ota_0.V_ref tanh_ota_0.V_in_n VSS.t83 nfet_03v3 ad=0.65p pd=3.02u as=0.65p ps=3.02u w=2.5u l=0.5u
X91 VDD.t27 a_13492_24053# voltage_reference_0.v_1_25 VSS.t93 nfet_03v3 ad=2.6p pd=10.52u as=2.6p ps=10.52u w=10u l=1u
X92 a_13250_5878# a_13250_5878# VSS.t14 VSS.t13 nfet_03v3 ad=1.3p pd=5.52u as=1.3p ps=5.52u w=5u l=1u
X93 tanh_ota_0.V_in_p tanh_ota_0.V_ref a_8355_9194# VSS.t61 nfet_03v3 ad=0.65p pd=3.02u as=0.65p ps=3.02u w=2.5u l=0.5u
X94 a_8559_11644# voltage_reference_0.v_1_15 a_9196_7474# VSS.t103 nfet_03v3 ad=1.3p pd=5.52u as=1.3p ps=5.52u w=5u l=0.5u
X95 VDD.t66 VDD.t64 a_7766_18788# VDD.t65 pfet_03v3 ad=3.25p pd=11.3u as=1.3p ps=5.52u w=5u l=0.5u
X96 VSS.t219 VSS.t218 a_3619_2602# VSS.t214 nfet_03v3 ad=3.05p pd=11.22u as=1.3p ps=5.52u w=5u l=0.5u
X97 tanh_ota_0.V_in_n V_w1.t14 a_3619_22696# VSS.t44 nfet_03v3 ad=0.65p pd=3.02u as=0.65p ps=3.02u w=2.5u l=0.5u
X98 VSS.t160 VSS.t158 a_3598_19300# VSS.t159 nfet_03v3 ad=2.44p pd=9.22u as=1.04p ps=4.52u w=4u l=1u
X99 tanh_ota_0.V_in_n V_w2.t13 a_3619_2602# VSS.t84 nfet_03v3 ad=0.65p pd=3.02u as=0.65p ps=3.02u w=2.5u l=0.5u
X100 VSS.t284 a_11555_17360# a_11555_17360# VSS.t126 nfet_03v3 ad=0.39p pd=2.02u as=0.39p ps=2.02u w=1.5u l=0.5u
X101 a_13382_20226# a_13250_5878# VSS.t15 VSS.t11 nfet_03v3 ad=0.65p pd=3.02u as=0.65p ps=3.02u w=2.5u l=2u
X102 a_19914_7960# VDD.t93 VSS.t35 ppolyf_u_1k r_width=3u r_length=33u
X103 a_3415_21020# V_w1.t6 tanh_ota_0.V_in_p VSS.t46 nfet_03v3 ad=0.65p pd=3.02u as=0.65p ps=3.02u w=2.5u l=0.5u
X104 a_19458_12220# VDD.t61 VDD.t63 VDD.t62 pfet_03v3 ad=1.3p pd=5.52u as=3.25p ps=11.3u w=5u l=1u
X105 a_13382_5774# a_13250_5878# VSS.t24 VSS.t23 nfet_03v3 ad=0.65p pd=3.02u as=0.65p ps=3.02u w=2.5u l=2u
X106 a_3415_21020# tanh_ota_0.V_ref tanh_ota_0.V_in_n VSS.t46 nfet_03v3 ad=0.65p pd=3.02u as=0.65p ps=3.02u w=2.5u l=0.5u
X107 voltage_reference_0.v_1_25 a_13492_24053# VDD.t30 VSS.t96 nfet_03v3 ad=2.6p pd=10.52u as=2.6p ps=10.52u w=10u l=1u
X108 a_14690_20226# VDD.t73 VDD.t75 VDD.t74 pfet_03v3 ad=2.6p pd=10.52u as=6.5p ps=21.3u w=10u l=2u
X109 VSS.t41 a_23777_13400# a_23777_13400# VSS.t40 nfet_03v3 ad=1.3p pd=5.52u as=1.3p ps=5.52u w=5u l=1u
X110 tanh_ota_0.V_in_p tanh_ota_0.V_ref a_3619_2602# VSS.t80 nfet_03v3 ad=0.65p pd=3.02u as=0.65p ps=3.02u w=2.5u l=0.5u
X111 a_13382_20226# a_13250_5878# VSS.t19 VSS.t18 nfet_03v3 ad=0.65p pd=3.02u as=0.65p ps=3.02u w=2.5u l=2u
X112 I_x2.t1 voltage_reference_0.v_1_25 gilbert_multiplier_current_1.V_x_n VSS.t261 nfet_03v3 ad=1.525p pd=6.22u as=0.65p ps=3.02u w=2.5u l=0.5u
X113 a_13382_5774# a_13250_5878# VSS.t28 VSS.t27 nfet_03v3 ad=0.65p pd=3.02u as=0.65p ps=3.02u w=2.5u l=2u
X114 tanh_ota_0.V_in_n tanh_ota_0.V_ref a_3415_6100# VSS.t84 nfet_03v3 ad=0.65p pd=3.02u as=0.65p ps=3.02u w=2.5u l=0.5u
X115 a_13382_5774# VSS.t245 VSS.t246 VSS.t241 nfet_03v3 ad=0.65p pd=3.02u as=1.525p ps=6.22u w=2.5u l=2u
X116 tanh_ota_0.V_in_p V_w2.t6 a_3415_6100# VSS.t80 nfet_03v3 ad=0.65p pd=3.02u as=0.65p ps=3.02u w=2.5u l=0.5u
X117 VDD.t80 VDD.t79 a_22199_13400# VDD.t4 pfet_03v3 ad=3.25p pd=11.3u as=1.3p ps=5.52u w=5u l=1u
X118 a_14558_5878# a_26642_10516# VSS.t35 ppolyf_u_1k r_width=3u r_length=33u
X119 a_14690_20226# a_14558_20330# a_13382_20226# VSS.t11 nfet_03v3 ad=1.3p pd=5.52u as=1.3p ps=5.52u w=5u l=2u
X120 tanh_ota_0.V_in_n tanh_ota_0.V_ref a_8559_11644# VSS.t63 nfet_03v3 ad=0.65p pd=3.02u as=0.65p ps=3.02u w=2.5u l=0.5u
X121 tanh_ota_0.V_in_p V_b.t5 a_8559_11644# VSS.t63 nfet_03v3 ad=0.65p pd=3.02u as=0.65p ps=3.02u w=2.5u l=0.5u
X122 VDD.t54 a_13492_1131# tanh_ota_0.V_ref VSS.t311 nfet_03v3 ad=2.6p pd=10.52u as=2.6p ps=10.52u w=10u l=1u
X123 a_10295_19296# tanh_ota_0.V_in_n V_out_perceptron.t0 VSS.t3 nfet_03v3 ad=1.3p pd=5.52u as=1.3p ps=5.52u w=5u l=0.5u
X124 a_13492_24053# voltage_reference_0.v_1_25 a_13382_20226# VSS.t18 nfet_03v3 ad=1.3p pd=5.52u as=1.3p ps=5.52u w=5u l=2u
X125 a_13330_16152# a_19458_15300# VSS.t10 ppolyf_u_1k r_width=3u r_length=30u
X126 tanh_ota_0.V_in_n V_b.t14 a_8355_9194# VSS.t61 nfet_03v3 ad=0.65p pd=3.02u as=0.65p ps=3.02u w=2.5u l=0.5u
X127 tanh_ota_0.V_in_n V_b.t3 a_8355_9194# VSS.t56 nfet_03v3 ad=0.65p pd=3.02u as=0.65p ps=3.02u w=2.5u l=0.5u
X128 a_3415_6100# gilbert_multiplier_current_1.V_x_n a_2717_9730# VSS.t8 nfet_03v3 ad=1.3p pd=5.52u as=1.3p ps=5.52u w=5u l=0.5u
X129 a_7766_18788# a_7766_18788# VDD.t18 VDD.t17 pfet_03v3 ad=1.3p pd=5.52u as=1.3p ps=5.52u w=5u l=0.5u
X130 VSS.t271 a_11555_17360# a_11555_17360# VSS.t270 nfet_03v3 ad=0.39p pd=2.02u as=0.39p ps=2.02u w=1.5u l=0.5u
X131 VSS.t286 a_11555_17360# a_11555_17360# VSS.t108 nfet_03v3 ad=0.39p pd=2.02u as=0.39p ps=2.02u w=1.5u l=0.5u
X132 tanh_ota_0.V_in_p VSS.t189 VSS.t190 VSS.t116 nfet_03v3 ad=0.65p pd=3.02u as=1.525p ps=6.22u w=2.5u l=0.5u
X133 VSS.t253 VSS.t251 VDD.t60 VSS.t252 nfet_03v3 ad=6.1p pd=21.22u as=2.6p ps=10.52u w=10u l=1u
X134 voltage_reference_0.v_1_25 a_13492_24053# VDD.t32 VSS.t98 nfet_03v3 ad=2.6p pd=10.52u as=2.6p ps=10.52u w=10u l=1u
X135 tanh_ota_0.V_in_p tanh_ota_0.V_ref a_3619_22696# VSS.t44 nfet_03v3 ad=0.65p pd=3.02u as=0.65p ps=3.02u w=2.5u l=0.5u
X136 tanh_ota_0.V_in_p tanh_ota_0.V_ref a_3619_22696# VSS.t47 nfet_03v3 ad=0.65p pd=3.02u as=0.65p ps=3.02u w=2.5u l=0.5u
X137 a_22199_13400# a_19458_12220# VDD.t7 VDD.t4 pfet_03v3 ad=1.3p pd=5.52u as=1.3p ps=5.52u w=5u l=1u
X138 a_3415_6100# V_w2.t10 tanh_ota_0.V_in_p VSS.t83 nfet_03v3 ad=0.65p pd=3.02u as=0.65p ps=3.02u w=2.5u l=0.5u
X139 tanh_ota_0.V_in_n VSS.t109 VSS.t110 VSS.t44 nfet_03v3 ad=0.65p pd=3.02u as=1.525p ps=6.22u w=2.5u l=0.5u
X140 a_2717_12168# a_2717_9730# VSS.t32 ppolyf_u_1k r_width=3u r_length=11.55u
X141 tanh_ota_0.V_in_p V_w1.t10 a_3415_21020# VSS.t45 nfet_03v3 ad=0.65p pd=3.02u as=0.65p ps=3.02u w=2.5u l=0.5u
X142 a_9805_17650# tanh_ota_0.V_ref VSS.t87 ppolyf_u_1k r_width=3u r_length=15u
X143 tanh_ota_0.V_in_n VSS.t247 VSS.t248 VSS.t211 nfet_03v3 ad=0.65p pd=3.02u as=1.525p ps=6.22u w=2.5u l=0.5u
X144 VSS.t79 tanh_ota_0.V_ref a_9196_7474# VSS.t75 nfet_03v3 ad=1.04p pd=4.52u as=1.04p ps=4.52u w=4u l=1u
X145 a_11555_17360# a_11555_17360# VSS.t269 VSS.t268 nfet_03v3 ad=0.39p pd=2.02u as=0.39p ps=2.02u w=1.5u l=0.5u
X146 a_2717_9730# tanh_ota_0.V_ref VSS.t66 VSS.t65 nfet_03v3 ad=1.04p pd=4.52u as=1.04p ps=4.52u w=4u l=1u
X147 VSS.t203 VSS.t201 a_3598_8020# VSS.t202 nfet_03v3 ad=2.44p pd=9.22u as=1.04p ps=4.52u w=4u l=1u
X148 VDD.t50 a_13492_1131# tanh_ota_0.V_ref VSS.t307 nfet_03v3 ad=2.6p pd=10.52u as=2.6p ps=10.52u w=10u l=1u
X149 a_13330_9664# a_19458_8812# VSS.t320 ppolyf_u_1k r_width=3u r_length=30u
X150 VDD.t46 VSS.t146 VSS.t148 VSS.t147 nfet_03v3 ad=2.6p pd=10.52u as=6.1p ps=21.22u w=10u l=1u
X151 a_13330_11368# a_19458_12220# VSS.t90 ppolyf_u_1k r_width=3u r_length=30u
X152 a_8355_9194# voltage_reference_0.v_1_25 a_7657_6436# VSS.t56 nfet_03v3 ad=1.3p pd=5.52u as=1.3p ps=5.52u w=5u l=0.5u
X153 tanh_ota_0.V_in_n V_w2.t0 a_3619_2602# VSS.t82 nfet_03v3 ad=0.65p pd=3.02u as=0.65p ps=3.02u w=2.5u l=0.5u
X154 VSS.t301 a_11555_17360# a_11555_17360# VSS.t300 nfet_03v3 ad=0.39p pd=2.02u as=0.39p ps=2.02u w=1.5u l=0.5u
X155 voltage_reference_0.v_1_25 a_13492_24053# VDD.t28 VSS.t94 nfet_03v3 ad=2.6p pd=10.52u as=2.6p ps=10.52u w=10u l=1u
X156 VSS.t22 a_13250_5878# a_13250_5878# VSS.t21 nfet_03v3 ad=1.3p pd=5.52u as=1.3p ps=5.52u w=5u l=1u
X157 tanh_ota_0.V_in_p V_w2.t9 a_3415_6100# VSS.t84 nfet_03v3 ad=0.65p pd=3.02u as=0.65p ps=3.02u w=2.5u l=0.5u
X158 VDD.t12 a_7766_18788# V_out_perceptron.t2 VDD.t11 pfet_03v3 ad=1.3p pd=5.52u as=1.3p ps=5.52u w=5u l=0.5u
X159 a_22199_13400# a_19854_15770# a_23777_13400# VDD.t35 pfet_03v3 ad=2.6p pd=10.52u as=2.6p ps=10.52u w=10u l=1u
X160 tanh_ota_0.V_in_p VSS.t210 VSS.t212 VSS.t211 nfet_03v3 ad=0.65p pd=3.02u as=1.525p ps=6.22u w=2.5u l=0.5u
X161 VSS.t20 a_13250_5878# a_13382_20226# VSS.t12 nfet_03v3 ad=0.65p pd=3.02u as=0.65p ps=3.02u w=2.5u l=2u
X162 a_21914_17004# a_26642_16152# VSS.t9 ppolyf_u_1k r_width=3u r_length=23u
X163 tanh_ota_0.V_in_p tanh_ota_0.V_ref a_8355_9194# VSS.t56 nfet_03v3 ad=0.65p pd=3.02u as=0.65p ps=3.02u w=2.5u l=0.5u
X164 tanh_ota_0.V_in_p tanh_ota_0.V_ref a_8355_9194# VSS.t64 nfet_03v3 ad=0.65p pd=3.02u as=0.65p ps=3.02u w=2.5u l=0.5u
X165 tanh_ota_0.V_in_n tanh_ota_0.V_ref a_3415_6100# VSS.t80 nfet_03v3 ad=0.65p pd=3.02u as=0.65p ps=3.02u w=2.5u l=0.5u
X166 a_7311_22424# a_11555_17360# VSS.t34 ppolyf_u_1k r_width=3u r_length=22u
X167 tanh_ota_0.V_in_n VSS.t115 VSS.t117 VSS.t116 nfet_03v3 ad=0.65p pd=3.02u as=1.525p ps=6.22u w=2.5u l=0.5u
X168 tanh_ota_0.V_in_n V_b.t1 a_8355_9194# VSS.t64 nfet_03v3 ad=0.65p pd=3.02u as=0.65p ps=3.02u w=2.5u l=0.5u
X169 VSS.t239 VSS.t237 a_14690_5774# VSS.t238 nfet_03v3 ad=3.05p pd=11.22u as=1.3p ps=5.52u w=5u l=2u
X170 a_19914_9664# a_26642_8812# VSS.t35 ppolyf_u_1k r_width=3u r_length=33u
X171 tanh_ota_0.V_in_n V_w1.t12 a_3619_22696# VSS.t44 nfet_03v3 ad=0.65p pd=3.02u as=0.65p ps=3.02u w=2.5u l=0.5u
X172 a_19458_12220# a_19458_12220# VDD.t1 VDD.t0 pfet_03v3 ad=1.3p pd=5.52u as=1.3p ps=5.52u w=5u l=1u
X173 tanh_ota_0.V_in_p tanh_ota_0.V_ref a_3619_22696# VSS.t44 nfet_03v3 ad=0.65p pd=3.02u as=0.65p ps=3.02u w=2.5u l=0.5u
X174 tanh_ota_0.V_in_n V_w1.t3 a_3619_22696# VSS.t47 nfet_03v3 ad=0.65p pd=3.02u as=0.65p ps=3.02u w=2.5u l=0.5u
X175 a_3415_21020# gilbert_multiplier_current_2.V_x_n a_2717_18262# VSS.t88 nfet_03v3 ad=1.3p pd=5.52u as=1.3p ps=5.52u w=5u l=0.5u
X176 VSS.t39 a_23777_13400# voltage_reference_0.v_1_15 VSS.t38 nfet_03v3 ad=1.3p pd=5.52u as=1.3p ps=5.52u w=5u l=1u
X177 tanh_ota_0.V_in_p VSS.t233 VSS.t234 VSS.t211 nfet_03v3 ad=0.65p pd=3.02u as=1.525p ps=6.22u w=2.5u l=0.5u
X178 tanh_ota_0.V_in_p VSS.t139 VSS.t140 VSS.t47 nfet_03v3 ad=0.65p pd=3.02u as=1.525p ps=6.22u w=2.5u l=0.5u
X179 a_3415_21020# VSS.t149 VSS.t150 VSS.t88 nfet_03v3 ad=1.3p pd=5.52u as=3.05p ps=11.22u w=5u l=0.5u
X180 VSS.t49 tanh_ota_0.V_ref a_3598_19300# VSS.t48 nfet_03v3 ad=1.04p pd=4.52u as=1.04p ps=4.52u w=4u l=1u
X181 VDD.t52 a_13492_1131# tanh_ota_0.V_ref VSS.t309 nfet_03v3 ad=2.6p pd=10.52u as=2.6p ps=10.52u w=10u l=1u
X182 a_13382_5774# tanh_ota_0.V_ref a_13492_1131# VSS.t25 nfet_03v3 ad=1.3p pd=5.52u as=1.3p ps=5.52u w=5u l=2u
X183 tanh_ota_0.V_in_p tanh_ota_0.V_ref a_3619_2602# VSS.t82 nfet_03v3 ad=0.65p pd=3.02u as=0.65p ps=3.02u w=2.5u l=0.5u
X184 tanh_ota_0.V_in_n tanh_ota_0.V_ref a_3415_21020# VSS.t45 nfet_03v3 ad=0.65p pd=3.02u as=0.65p ps=3.02u w=2.5u l=0.5u
X185 a_13330_17856# a_19458_17004# VSS.t105 ppolyf_u_1k r_width=3u r_length=30u
X186 a_22199_13400# VDD.t81 VDD.t82 VDD.t4 pfet_03v3 ad=1.3p pd=5.52u as=3.25p ps=11.3u w=5u l=1u
X187 tanh_ota_0.V_in_p VSS.t133 VSS.t134 VSS.t45 nfet_03v3 ad=0.65p pd=3.02u as=1.525p ps=6.22u w=2.5u l=0.5u
X188 VSS.t275 a_11555_17360# a_11555_17360# VSS.t274 nfet_03v3 ad=0.39p pd=2.02u as=0.39p ps=2.02u w=1.5u l=0.5u
X189 VSS.t250 VSS.t249 tanh_ota_0.V_in_n VSS.t214 nfet_03v3 ad=1.525p pd=6.22u as=0.65p ps=3.02u w=2.5u l=0.5u
X190 a_13382_5774# a_14558_5878# a_14690_5774# VSS.t29 nfet_03v3 ad=1.3p pd=5.52u as=1.3p ps=5.52u w=5u l=2u
X191 tanh_ota_0.V_in_n tanh_ota_0.V_ref a_3415_21020# VSS.t46 nfet_03v3 ad=0.65p pd=3.02u as=0.65p ps=3.02u w=2.5u l=0.5u
X192 VSS.t289 a_11555_17360# a_11555_17360# VSS.t288 nfet_03v3 ad=0.39p pd=2.02u as=0.39p ps=2.02u w=1.5u l=0.5u
X193 a_13382_20226# a_14558_20330# a_14690_20226# VSS.t12 nfet_03v3 ad=1.3p pd=5.52u as=1.3p ps=5.52u w=5u l=2u
X194 tanh_ota_0.V_in_p V_w2.t4 a_3415_6100# VSS.t82 nfet_03v3 ad=0.65p pd=3.02u as=0.65p ps=3.02u w=2.5u l=0.5u
X195 VSS.t74 tanh_ota_0.V_ref a_7657_6436# VSS.t73 nfet_03v3 ad=1.04p pd=4.52u as=1.04p ps=4.52u w=4u l=1u
X196 VDD.t20 a_7766_18788# V_out_perceptron.t3 VDD.t19 pfet_03v3 ad=1.3p pd=5.52u as=1.3p ps=5.52u w=5u l=0.5u
X197 a_7657_6436# a_7657_3998# VSS.t321 ppolyf_u_1k r_width=3u r_length=11.55u
X198 a_8559_11644# tanh_ota_0.V_ref tanh_ota_0.V_in_n VSS.t59 nfet_03v3 ad=0.65p pd=3.02u as=0.65p ps=3.02u w=2.5u l=0.5u
X199 tanh_ota_0.V_ref a_13492_1131# VDD.t55 VSS.t312 nfet_03v3 ad=2.6p pd=10.52u as=2.6p ps=10.52u w=10u l=1u
X200 a_11555_17360# a_11555_17360# VSS.t287 VSS.t129 nfet_03v3 ad=0.39p pd=2.02u as=0.39p ps=2.02u w=1.5u l=0.5u
X201 a_8559_11644# V_b.t9 tanh_ota_0.V_in_p VSS.t62 nfet_03v3 ad=0.65p pd=3.02u as=0.65p ps=3.02u w=2.5u l=0.5u
X202 a_3598_8020# VSS.t198 VSS.t200 VSS.t199 nfet_03v3 ad=1.04p pd=4.52u as=2.44p ps=9.22u w=4u l=1u
X203 VDD.t48 a_13492_1131# tanh_ota_0.V_ref VSS.t305 nfet_03v3 ad=2.6p pd=10.52u as=2.6p ps=10.52u w=10u l=1u
X204 tanh_ota_0.V_in_n V_b.t12 a_8355_9194# VSS.t58 nfet_03v3 ad=0.65p pd=3.02u as=0.65p ps=3.02u w=2.5u l=0.5u
X205 VSS.t215 VSS.t213 tanh_ota_0.V_in_p VSS.t214 nfet_03v3 ad=1.525p pd=6.22u as=0.65p ps=3.02u w=2.5u l=0.5u
X206 tanh_ota_0.V_in_p tanh_ota_0.V_ref a_8355_9194# VSS.t58 nfet_03v3 ad=0.65p pd=3.02u as=0.65p ps=3.02u w=2.5u l=0.5u
X207 a_22199_13400# a_19458_12220# VDD.t5 VDD.t4 pfet_03v3 ad=1.3p pd=5.52u as=1.3p ps=5.52u w=5u l=1u
X208 a_19914_9664# a_26642_10516# VSS.t35 ppolyf_u_1k r_width=3u r_length=33u
X209 a_3619_22696# voltage_reference_0.v_1_25 a_3598_19300# VSS.t88 nfet_03v3 ad=1.3p pd=5.52u as=1.3p ps=5.52u w=5u l=0.5u
X210 VDD.t45 tanh_ota_0.V_in_n VSS.t33 ppolyf_u_1k r_width=3u r_length=7.3u
X211 V_out_perceptron.t1 tanh_ota_0.V_in_n a_10295_19296# VSS.t4 nfet_03v3 ad=1.3p pd=5.52u as=1.3p ps=5.52u w=5u l=0.5u
X212 a_2717_9730# gilbert_multiplier_current_1.V_x_n a_3415_6100# VSS.t7 nfet_03v3 ad=1.3p pd=5.52u as=1.3p ps=5.52u w=5u l=0.5u
X213 tanh_ota_0.V_in_p tanh_ota_0.V_ref a_3619_22696# VSS.t47 nfet_03v3 ad=0.65p pd=3.02u as=0.65p ps=3.02u w=2.5u l=0.5u
X214 a_3619_22696# VSS.t153 VSS.t154 VSS.t88 nfet_03v3 ad=1.3p pd=5.52u as=3.05p ps=11.22u w=5u l=0.5u
X215 tanh_ota_0.V_in_n V_w1.t1 a_3619_22696# VSS.t47 nfet_03v3 ad=0.65p pd=3.02u as=0.65p ps=3.02u w=2.5u l=0.5u
X216 a_11555_17360# a_11555_17360# VSS.t273 VSS.t272 nfet_03v3 ad=0.39p pd=2.02u as=0.39p ps=2.02u w=1.5u l=0.5u
X217 VSS.t236 VSS.t235 tanh_ota_0.V_in_p VSS.t214 nfet_03v3 ad=1.525p pd=6.22u as=0.65p ps=3.02u w=2.5u l=0.5u
X218 tanh_ota_0.V_in_p V_w1.t8 a_3415_21020# VSS.t45 nfet_03v3 ad=0.65p pd=3.02u as=0.65p ps=3.02u w=2.5u l=0.5u
X219 a_13250_5878# a_19458_15300# VSS.t86 ppolyf_u_1k r_width=3u r_length=30u
X220 tanh_ota_0.V_in_n tanh_ota_0.V_ref a_3415_21020# VSS.t45 nfet_03v3 ad=0.65p pd=3.02u as=0.65p ps=3.02u w=2.5u l=0.5u
X221 VDD.t72 VDD.t70 a_14690_20226# VDD.t71 pfet_03v3 ad=6.5p pd=21.3u as=2.6p ps=10.52u w=10u l=2u
X222 a_21914_18708# a_26642_17856# VSS.t9 ppolyf_u_1k r_width=3u r_length=23u
X223 tanh_ota_0.V_in_p tanh_ota_0.V_ref a_3619_2602# VSS.t8 nfet_03v3 ad=0.65p pd=3.02u as=0.65p ps=3.02u w=2.5u l=0.5u
X224 VDD.t33 a_13492_24053# voltage_reference_0.v_1_25 VSS.t99 nfet_03v3 ad=2.6p pd=10.52u as=2.6p ps=10.52u w=10u l=1u
X225 a_11555_17360# a_11555_17360# VSS.t285 VSS.t107 nfet_03v3 ad=0.39p pd=2.02u as=0.39p ps=2.02u w=1.5u l=0.5u
X226 VSS.t188 VSS.t187 tanh_ota_0.V_in_p VSS.t59 nfet_03v3 ad=1.525p pd=6.22u as=0.65p ps=3.02u w=2.5u l=0.5u
X227 a_7657_6436# tanh_ota_0.V_ref VSS.t76 VSS.t75 nfet_03v3 ad=1.04p pd=4.52u as=1.04p ps=4.52u w=4u l=1u
X228 tanh_ota_0.V_in_p V_w1.t7 a_3415_21020# VSS.t46 nfet_03v3 ad=0.65p pd=3.02u as=0.65p ps=3.02u w=2.5u l=0.5u
X229 a_13330_11368# a_19458_10516# VSS.t106 ppolyf_u_1k r_width=3u r_length=30u
X230 tanh_ota_0.V_in_n VSS.t229 VSS.t230 VSS.t211 nfet_03v3 ad=0.65p pd=3.02u as=1.525p ps=6.22u w=2.5u l=0.5u
X231 tanh_ota_0.V_in_n VSS.t113 VSS.t114 VSS.t46 nfet_03v3 ad=0.65p pd=3.02u as=1.525p ps=6.22u w=2.5u l=0.5u
X232 voltage_reference_0.v_1_25 a_13492_24053# VDD.t26 VSS.t92 nfet_03v3 ad=2.6p pd=10.52u as=2.6p ps=10.52u w=10u l=1u
X233 VSS.t172 VSS.t170 VSS.t172 VSS.t171 nfet_03v3 ad=0.39p pd=2.02u as=0 ps=0 w=1.5u l=0.5u
X234 VDD.t40 a_14690_20226# a_13492_24053# VDD.t39 pfet_03v3 ad=2.6p pd=10.52u as=2.6p ps=10.52u w=10u l=2u
X235 a_21914_18708# VSS.t263 VSS.t9 ppolyf_u_1k r_width=3u r_length=23u
X236 VSS.t195 VSS.t193 a_23777_13400# VSS.t194 nfet_03v3 ad=3.05p pd=11.22u as=1.3p ps=5.52u w=5u l=1u
X237 a_7311_24128# a_11839_24980# VSS.t2 ppolyf_u_1k r_width=3u r_length=22u
X238 gilbert_multiplier_current_1.V_x_n voltage_reference_0.v_1_25 I_x2.t0 VSS.t260 nfet_03v3 ad=0.65p pd=3.02u as=1.525p ps=6.22u w=2.5u l=0.5u
X239 VSS.t181 VSS.t179 a_13250_5878# VSS.t180 nfet_03v3 ad=3.05p pd=11.22u as=1.3p ps=5.52u w=5u l=1u
X240 a_14690_5774# a_14558_5878# a_13382_5774# VSS.t23 nfet_03v3 ad=1.3p pd=5.52u as=1.3p ps=5.52u w=5u l=2u
X241 a_3598_8020# voltage_reference_0.v_1_25 a_3619_2602# VSS.t85 nfet_03v3 ad=1.3p pd=5.52u as=1.3p ps=5.52u w=5u l=0.5u
X242 a_22199_13400# voltage_reference_0.v_1_15 voltage_reference_0.v_1_15 VDD.t35 pfet_03v3 ad=2.6p pd=10.52u as=2.6p ps=10.52u w=10u l=1u
X243 a_7657_6436# voltage_reference_0.v_1_25 a_8355_9194# VSS.t60 nfet_03v3 ad=1.3p pd=5.52u as=1.3p ps=5.52u w=5u l=0.5u
X244 a_7311_24128# a_11839_23276# VSS.t1 ppolyf_u_1k r_width=3u r_length=22u
X245 a_13492_1131# tanh_ota_0.V_ref a_13382_5774# VSS.t27 nfet_03v3 ad=1.3p pd=5.52u as=1.3p ps=5.52u w=5u l=2u
X246 tanh_ota_0.V_in_n tanh_ota_0.V_ref a_3415_6100# VSS.t82 nfet_03v3 ad=0.65p pd=3.02u as=0.65p ps=3.02u w=2.5u l=0.5u
X247 a_11555_17360# a_11555_17360# VSS.t303 VSS.t302 nfet_03v3 ad=0.39p pd=2.02u as=0.39p ps=2.02u w=1.5u l=0.5u
X248 a_8559_11644# tanh_ota_0.V_ref tanh_ota_0.V_in_n VSS.t57 nfet_03v3 ad=0.65p pd=3.02u as=0.65p ps=3.02u w=2.5u l=0.5u
X249 tanh_ota_0.V_ref a_13492_1131# VDD.t57 VSS.t314 nfet_03v3 ad=2.6p pd=10.52u as=2.6p ps=10.52u w=10u l=1u
X250 tanh_ota_0.V_in_n V_w2.t15 a_3619_2602# VSS.t8 nfet_03v3 ad=0.65p pd=3.02u as=0.65p ps=3.02u w=2.5u l=0.5u
X251 VSS.t319 a_19458_8812# VSS.t318 ppolyf_u_1k r_width=3u r_length=30u
X252 VSS.t127 VSS.t125 a_7766_18788# VSS.t126 nfet_03v3 ad=3.05p pd=11.22u as=1.3p ps=5.52u w=5u l=0.5u
X253 VDD.t3 a_19458_12220# a_19458_12220# VDD.t2 pfet_03v3 ad=1.3p pd=5.52u as=1.3p ps=5.52u w=5u l=1u
X254 a_8559_11644# V_b.t11 tanh_ota_0.V_in_p VSS.t60 nfet_03v3 ad=0.65p pd=3.02u as=0.65p ps=3.02u w=2.5u l=0.5u
X255 a_8559_11644# V_b.t4 tanh_ota_0.V_in_p VSS.t63 nfet_03v3 ad=0.65p pd=3.02u as=0.65p ps=3.02u w=2.5u l=0.5u
X256 a_3619_2602# V_w2.t1 tanh_ota_0.V_in_n VSS.t81 nfet_03v3 ad=0.65p pd=3.02u as=0.65p ps=3.02u w=2.5u l=0.5u
X257 VDD.t89 VDD.t87 a_14690_5774# VDD.t88 pfet_03v3 ad=6.5p pd=21.3u as=2.6p ps=10.52u w=10u l=2u
X258 a_14690_5774# VSS.t240 VSS.t242 VSS.t241 nfet_03v3 ad=1.3p pd=5.52u as=3.05p ps=11.22u w=5u l=2u
X259 a_3561_18262# a_2717_15824# VSS.t31 ppolyf_u_1k r_width=3u r_length=11.55u
X260 a_8559_11644# tanh_ota_0.V_ref tanh_ota_0.V_in_n VSS.t62 nfet_03v3 ad=0.65p pd=3.02u as=0.65p ps=3.02u w=2.5u l=0.5u
X261 voltage_reference_0.v_1_15 a_23777_13400# VSS.t43 VSS.t42 nfet_03v3 ad=1.3p pd=5.52u as=1.3p ps=5.52u w=5u l=1u
X262 a_3598_19300# tanh_ota_0.V_ref VSS.t55 VSS.t54 nfet_03v3 ad=1.04p pd=4.52u as=1.04p ps=4.52u w=4u l=1u
X263 VDD.t22 a_7766_18788# a_7766_18788# VDD.t21 pfet_03v3 ad=1.3p pd=5.52u as=1.3p ps=5.52u w=5u l=0.5u
X264 VDD.t97 a_14690_5774# a_13492_1131# VDD.t96 pfet_03v3 ad=2.6p pd=10.52u as=2.6p ps=10.52u w=10u l=2u
X265 tanh_ota_0.V_in_n tanh_ota_0.V_ref a_3415_6100# VSS.t8 nfet_03v3 ad=0.65p pd=3.02u as=0.65p ps=3.02u w=2.5u l=0.5u
X266 a_8501_6436# a_7657_3998# VSS.t257 ppolyf_u_1k r_width=3u r_length=11.55u
X267 VSS.t112 VSS.t111 tanh_ota_0.V_in_n VSS.t44 nfet_03v3 ad=1.525p pd=6.22u as=0.65p ps=3.02u w=2.5u l=0.5u
X268 a_14558_20330# a_19854_15770# VSS.t104 ppolyf_u_1k r_width=3u r_length=10u
X269 a_4405_12168# a_3561_9730# VSS.t5 ppolyf_u_1k r_width=3u r_length=11.55u
X270 a_9196_7474# voltage_reference_0.v_1_15 a_8559_11644# VSS.t103 nfet_03v3 ad=1.3p pd=5.52u as=1.3p ps=5.52u w=5u l=0.5u
X271 VDD.t101 a_14690_5774# a_14690_5774# VDD.t100 pfet_03v3 ad=2.6p pd=10.52u as=2.6p ps=10.52u w=10u l=2u
X272 a_19914_7960# a_26642_8812# VSS.t35 ppolyf_u_1k r_width=3u r_length=33u
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
