valrek-sol/analog-perceptron-gf180mcu/pex/out/pex/perceptron_pex_c.spice

* perceptron_pex_c — Magic C extraction of perceptron (gds/perceptron.gds)
* generated by pex/pex.tcl, see pex/out/env.txt for provenance
* ports (schematic order): VDD V_shift V_w1 I_x1 V_out_perceptron V_b I_x2 V_w2 VSS
* NGSPICE file created from perceptron.ext - technology: gf180mcuD

.subckt perceptron_pex_c VDD V_shift V_w1 I_x1 V_out_perceptron V_b I_x2 V_w2 VSS
X0 VSS VSS VSS VSS nfet_03v3 ad=0.915p pd=4.22u as=0.18551n ps=0.72964m w=1.5u l=0.5u
D0 VSS I_x1_core diode_nd2ps_06v0 pj=40u area=99.99999p
D1 VSS V_w2_core diode_nd2ps_06v0 pj=40u area=99.99999p
X1 a_49135_56824# perceptron_core_0.tanh_ota_0.V_ref perceptron_core_0.tanh_ota_0.V_in_n VSS nfet_03v3 ad=0.65p pd=3.02u as=0.65p ps=3.02u w=2.5u l=0.5u
X2 a_50871_64476# a_52131_62540# VSS VSS nfet_03v3 ad=0.39p pd=2.02u as=0.39p ps=2.02u w=1.5u l=0.5u
X3 a_49135_56824# perceptron_core_0.voltage_reference_0.v_1_15 a_49772_52654# VSS nfet_03v3 ad=1.3p pd=5.52u as=1.3p ps=5.52u w=5u l=0.5u
X4 a_49135_56824# V_b_core perceptron_core_0.tanh_ota_0.V_in_p VSS nfet_03v3 ad=0.65p pd=3.02u as=0.65p ps=3.02u w=2.5u l=0.5u
X5 perceptron_core_0.gilbert_multiplier_current_2.V_x_n perceptron_core_0.voltage_reference_0.v_1_25 I_x1_core VSS nfet_03v3 ad=0.65p pd=3.02u as=1.525p ps=6.22u w=2.5u l=0.5u
X6 a_62490_62184# a_67218_61332# VSS ppolyf_u_1k r_width=3u r_length=23u
X7 a_49135_56824# VSS VSS VSS nfet_03v3 ad=1.3p pd=5.52u as=3.05p ps=11.22u w=5u l=0.5u
X8 a_49135_56824# perceptron_core_0.tanh_ota_0.V_ref perceptron_core_0.tanh_ota_0.V_in_n VSS nfet_03v3 ad=0.65p pd=3.02u as=0.65p ps=3.02u w=2.5u l=0.5u
X9 a_53906_61332# a_60034_62184# VSS ppolyf_u_1k r_width=3u r_length=30u
D2 VSS I_x1_core diode_nd2ps_06v0 pj=40u area=99.99999p
X10 perceptron_core_0.voltage_reference_0.v_1_25 a_54068_69233# VDD VSS nfet_03v3 ad=2.6p pd=10.52u as=2.6p ps=10.52u w=10u l=1u
X11 perceptron_core_0.tanh_ota_0.V_in_p V_b_core a_49135_56824# VSS nfet_03v3 ad=0.65p pd=3.02u as=0.65p ps=3.02u w=2.5u l=0.5u
D3 I_x2_core VDD diode_pd2nw_06v0 pj=40u area=99.99999p
X12 a_55266_65406# a_55134_65510# a_53958_65406# VSS nfet_03v3 ad=1.3p pd=5.52u as=1.3p ps=5.52u w=5u l=2u
X13 perceptron_core_0.tanh_ota_0.V_in_n perceptron_core_0.tanh_ota_0.V_ref a_49135_56824# VSS nfet_03v3 ad=0.65p pd=3.02u as=0.65p ps=3.02u w=2.5u l=0.5u
X14 VDD VDD a_55266_65406# VDD pfet_03v3 ad=6.5p pd=21.3u as=2.6p ps=10.52u w=10u l=2u
X15 VSS a_52131_62540# a_52131_62540# VSS nfet_03v3 ad=0.39p pd=2.02u as=0.39p ps=2.02u w=1.5u l=0.5u
D4 VSS V_shift_core diode_nd2ps_06v0 pj=40u area=99.99999p
D5 V_shift_core VDD diode_pd2nw_06v0 pj=40u area=99.99999p
X16 VDD a_54068_69233# perceptron_core_0.voltage_reference_0.v_1_25 VSS nfet_03v3 ad=2.6p pd=10.52u as=2.6p ps=10.52u w=10u l=1u
X17 VSS perceptron_core_0.tanh_ota_0.V_ref a_48233_51616# VSS nfet_03v3 ad=1.04p pd=4.52u as=1.04p ps=4.52u w=4u l=1u
X18 VDD a_54068_46311# perceptron_core_0.tanh_ota_0.V_ref VSS nfet_03v3 ad=2.6p pd=10.52u as=2.6p ps=10.52u w=10u l=1u
X19 VDD a_48342_63968# a_48342_63968# VDD pfet_03v3 ad=1.3p pd=5.52u as=1.3p ps=5.52u w=5u l=0.5u
X20 a_53906_56548# a_60034_55696# VSS ppolyf_u_1k r_width=3u r_length=30u
X21 a_54068_69233# perceptron_core_0.voltage_reference_0.v_1_25 a_53958_65406# VSS nfet_03v3 ad=1.3p pd=5.52u as=1.3p ps=5.52u w=5u l=2u
X22 VSS VSS perceptron_core_0.tanh_ota_0.V_in_n VSS nfet_03v3 ad=1.525p pd=6.22u as=0.65p ps=3.02u w=2.5u l=0.5u
D6 V_w1_core VDD diode_pd2nw_06v0 pj=40u area=99.99999p
X23 perceptron_core_0.tanh_ota_0.V_in_p V_w2_core a_43991_51280# VSS nfet_03v3 ad=0.65p pd=3.02u as=0.65p ps=3.02u w=2.5u l=0.5u
X24 VSS VSS a_64353_58580# VSS nfet_03v3 ad=3.05p pd=11.22u as=1.3p ps=5.52u w=5u l=1u
X25 VDD a_55266_65406# a_54068_69233# VDD pfet_03v3 ad=2.6p pd=10.52u as=2.6p ps=10.52u w=10u l=2u
X26 VSS VSS VDD VSS nfet_03v3 ad=6.1p pd=21.22u as=2.6p ps=10.52u w=10u l=1u
X27 a_44195_67876# perceptron_core_0.tanh_ota_0.V_ref perceptron_core_0.tanh_ota_0.V_in_p VSS nfet_03v3 ad=0.65p pd=3.02u as=0.65p ps=3.02u w=2.5u l=0.5u
X28 perceptron_core_0.tanh_ota_0.V_in_n V_w2_core a_44195_47782# VSS nfet_03v3 ad=0.65p pd=3.02u as=0.65p ps=3.02u w=2.5u l=0.5u
X29 perceptron_core_0.tanh_ota_0.V_in_n perceptron_core_0.tanh_ota_0.V_ref a_43991_66200# VSS nfet_03v3 ad=0.65p pd=3.02u as=0.65p ps=3.02u w=2.5u l=0.5u
X30 perceptron_core_0.tanh_ota_0.V_in_p perceptron_core_0.tanh_ota_0.V_ref a_44195_47782# VSS nfet_03v3 ad=0.65p pd=3.02u as=0.65p ps=3.02u w=2.5u l=0.5u
X31 a_55266_65406# VSS VSS VSS nfet_03v3 ad=1.3p pd=5.52u as=3.05p ps=11.22u w=5u l=2u
X32 VDD VSS VSS VSS nfet_03v3 ad=2.6p pd=10.52u as=6.1p ps=21.22u w=10u l=1u
X33 perceptron_core_0.tanh_ota_0.V_in_n perceptron_core_0.tanh_ota_0.V_ref a_43991_51280# VSS nfet_03v3 ad=0.65p pd=3.02u as=0.65p ps=3.02u w=2.5u l=0.5u
X34 a_53958_65406# a_53826_51058# VSS VSS nfet_03v3 ad=0.65p pd=3.02u as=0.65p ps=3.02u w=2.5u l=2u
X35 VSS VSS a_48931_54374# VSS nfet_03v3 ad=3.05p pd=11.22u as=1.3p ps=5.52u w=5u l=0.5u
X36 a_55134_51058# a_67218_55696# VSS ppolyf_u_1k r_width=3u r_length=33u
X37 perceptron_core_0.tanh_ota_0.V_in_p V_w2_core a_43991_51280# VSS nfet_03v3 ad=0.65p pd=3.02u as=0.65p ps=3.02u w=2.5u l=0.5u
X38 V_w2 V_w2_core VDD ppolyf_u r_width=40u r_length=10u
X39 VSS a_53826_51058# a_53826_51058# VSS nfet_03v3 ad=1.3p pd=5.52u as=1.3p ps=5.52u w=5u l=1u
X40 a_48233_51616# perceptron_core_0.voltage_reference_0.v_1_25 a_48931_54374# VSS nfet_03v3 ad=1.3p pd=5.52u as=1.3p ps=5.52u w=5u l=0.5u
X41 VSS VSS perceptron_core_0.tanh_ota_0.V_in_p VSS nfet_03v3 ad=1.525p pd=6.22u as=0.65p ps=3.02u w=2.5u l=0.5u
X42 VSS perceptron_core_0.tanh_ota_0.V_ref a_43293_54910# VSS nfet_03v3 ad=1.04p pd=4.52u as=1.04p ps=4.52u w=4u l=1u
X43 a_49135_56824# V_b_core perceptron_core_0.tanh_ota_0.V_in_p VSS nfet_03v3 ad=0.65p pd=3.02u as=0.65p ps=3.02u w=2.5u l=0.5u
X44 V_shift V_shift_core VDD ppolyf_u r_width=40u r_length=10u
X45 perceptron_core_0.tanh_ota_0.V_in_n VSS VSS VSS nfet_03v3 ad=0.65p pd=3.02u as=1.525p ps=6.22u w=2.5u l=0.5u
X46 a_43991_51280# V_w2_core perceptron_core_0.tanh_ota_0.V_in_p VSS nfet_03v3 ad=0.65p pd=3.02u as=0.65p ps=3.02u w=2.5u l=0.5u
X47 perceptron_core_0.tanh_ota_0.V_ref a_54068_46311# VDD VSS nfet_03v3 ad=2.6p pd=10.52u as=2.6p ps=10.52u w=10u l=1u
X48 a_53958_65406# a_53826_51058# VSS VSS nfet_03v3 ad=0.65p pd=3.02u as=0.65p ps=3.02u w=2.5u l=2u
X49 a_44195_47782# V_w2_core perceptron_core_0.tanh_ota_0.V_in_n VSS nfet_03v3 ad=0.65p pd=3.02u as=0.65p ps=3.02u w=2.5u l=0.5u
X50 a_62775_58580# a_60430_60950# a_64353_58580# VDD pfet_03v3 ad=2.6p pd=10.52u as=2.6p ps=10.52u w=10u l=1u
X51 a_49135_56824# perceptron_core_0.tanh_ota_0.V_ref perceptron_core_0.tanh_ota_0.V_in_n VSS nfet_03v3 ad=0.65p pd=3.02u as=0.65p ps=3.02u w=2.5u l=0.5u
X52 a_50381_62830# a_49529_59702# VSS ppolyf_u_1k r_width=3u r_length=15u
X53 VSS a_52131_62540# a_52131_62540# VSS nfet_03v3 ad=0.39p pd=2.02u as=0.39p ps=2.02u w=1.5u l=0.5u
X54 a_48342_63968# VSS VSS VSS nfet_03v3 ad=1.3p pd=5.52u as=3.05p ps=11.22u w=5u l=0.5u
X55 perceptron_core_0.tanh_ota_0.V_in_p perceptron_core_0.tanh_ota_0.V_ref a_48931_54374# VSS nfet_03v3 ad=0.65p pd=3.02u as=0.65p ps=3.02u w=2.5u l=0.5u
X56 a_49135_56824# V_b_core perceptron_core_0.tanh_ota_0.V_in_p VSS nfet_03v3 ad=0.65p pd=3.02u as=0.65p ps=3.02u w=2.5u l=0.5u
X57 a_43991_66200# perceptron_core_0.tanh_ota_0.V_ref perceptron_core_0.tanh_ota_0.V_in_n VSS nfet_03v3 ad=0.65p pd=3.02u as=0.65p ps=3.02u w=2.5u l=0.5u
X58 a_43991_51280# perceptron_core_0.gilbert_multiplier_current_1.V_x_n a_43293_54910# VSS nfet_03v3 ad=1.3p pd=5.52u as=1.3p ps=5.52u w=5u l=0.5u
X59 perceptron_core_0.tanh_ota_0.V_in_n V_b_core a_48931_54374# VSS nfet_03v3 ad=0.65p pd=3.02u as=0.65p ps=3.02u w=2.5u l=0.5u
X60 a_53958_65406# VSS VSS VSS nfet_03v3 ad=0.65p pd=3.02u as=1.525p ps=6.22u w=2.5u l=2u
X61 VSS a_52131_62540# a_52131_62540# VSS nfet_03v3 ad=0.39p pd=2.02u as=0.39p ps=2.02u w=1.5u l=0.5u
D7 VSS V_out_perceptron_core diode_nd2ps_06v0 pj=40u area=99.99999p
X62 VSS a_64353_58580# perceptron_core_0.voltage_reference_0.v_1_15 VSS nfet_03v3 ad=1.3p pd=5.52u as=1.3p ps=5.52u w=5u l=1u
X63 a_62775_58580# a_60034_57400# VDD VDD pfet_03v3 ad=1.3p pd=5.52u as=1.3p ps=5.52u w=5u l=1u
X64 VSS VSS a_55266_50954# VSS nfet_03v3 ad=3.05p pd=11.22u as=1.3p ps=5.52u w=5u l=2u
D8 VSS I_x1_core diode_nd2ps_06v0 pj=40u area=99.99999p
D9 V_w1_core VDD diode_pd2nw_06v0 pj=40u area=99.99999p
X65 perceptron_core_0.tanh_ota_0.V_in_p VSS VSS VSS nfet_03v3 ad=0.65p pd=3.02u as=1.525p ps=6.22u w=2.5u l=0.5u
X66 a_60034_57400# a_60034_57400# VDD VDD pfet_03v3 ad=1.3p pd=5.52u as=1.3p ps=5.52u w=5u l=1u
X67 a_55134_65510# a_60430_60950# VSS ppolyf_u_1k r_width=3u r_length=10u
X68 a_53958_50954# perceptron_core_0.tanh_ota_0.V_ref a_54068_46311# VSS nfet_03v3 ad=1.3p pd=5.52u as=1.3p ps=5.52u w=5u l=2u
X69 VSS perceptron_core_0.tanh_ota_0.V_ref a_43293_63442# VSS nfet_03v3 ad=1.04p pd=4.52u as=1.04p ps=4.52u w=4u l=1u
D10 V_b_core VDD diode_pd2nw_06v0 pj=40u area=99.99999p
X70 VDD a_54068_46311# perceptron_core_0.tanh_ota_0.V_ref VSS nfet_03v3 ad=2.6p pd=10.52u as=2.6p ps=10.52u w=10u l=1u
X71 a_62490_63888# a_67218_63036# VSS ppolyf_u_1k r_width=3u r_length=23u
D11 VSS V_out_perceptron_core diode_nd2ps_06v0 pj=40u area=99.99999p
X72 a_53958_50954# a_55134_51058# a_55266_50954# VSS nfet_03v3 ad=1.3p pd=5.52u as=1.3p ps=5.52u w=5u l=2u
X73 perceptron_core_0.tanh_ota_0.V_in_n V_b_core a_48931_54374# VSS nfet_03v3 ad=0.65p pd=3.02u as=0.65p ps=3.02u w=2.5u l=0.5u
X74 a_53906_63036# VDD VSS ppolyf_u_1k r_width=3u r_length=30u
X75 a_48931_54374# perceptron_core_0.tanh_ota_0.V_ref perceptron_core_0.tanh_ota_0.V_in_p VSS nfet_03v3 ad=0.65p pd=3.02u as=0.65p ps=3.02u w=2.5u l=0.5u
X76 a_53958_65406# a_55134_65510# a_55266_65406# VSS nfet_03v3 ad=1.3p pd=5.52u as=1.3p ps=5.52u w=5u l=2u
X77 VSS VSS a_53958_50954# VSS nfet_03v3 ad=1.525p pd=6.22u as=0.65p ps=3.02u w=2.5u l=2u
D12 V_w2_core VDD diode_pd2nw_06v0 pj=40u area=99.99999p
X78 perceptron_core_0.tanh_ota_0.V_in_p perceptron_core_0.tanh_ota_0.V_ref a_48931_54374# VSS nfet_03v3 ad=0.65p pd=3.02u as=0.65p ps=3.02u w=2.5u l=0.5u
X79 perceptron_core_0.tanh_ota_0.V_in_n V_w2_core a_44195_47782# VSS nfet_03v3 ad=0.65p pd=3.02u as=0.65p ps=3.02u w=2.5u l=0.5u
X80 a_48931_54374# V_b_core perceptron_core_0.tanh_ota_0.V_in_n VSS nfet_03v3 ad=0.65p pd=3.02u as=0.65p ps=3.02u w=2.5u l=0.5u
X81 VSS a_52131_62540# a_52131_62540# VSS nfet_03v3 ad=0.39p pd=2.02u as=0.39p ps=2.02u w=1.5u l=0.5u
X82 a_48931_54374# perceptron_core_0.tanh_ota_0.V_ref perceptron_core_0.tanh_ota_0.V_in_p VSS nfet_03v3 ad=0.65p pd=3.02u as=0.65p ps=3.02u w=2.5u l=0.5u
X83 VDD a_54068_69233# perceptron_core_0.voltage_reference_0.v_1_25 VSS nfet_03v3 ad=2.6p pd=10.52u as=2.6p ps=10.52u w=10u l=1u
D13 V_b_core VDD diode_pd2nw_06v0 pj=40u area=99.99999p
X84 perceptron_core_0.tanh_ota_0.V_in_n perceptron_core_0.tanh_ota_0.V_ref a_43991_51280# VSS nfet_03v3 ad=0.65p pd=3.02u as=0.65p ps=3.02u w=2.5u l=0.5u
X85 VSS a_53826_51058# a_53958_50954# VSS nfet_03v3 ad=0.65p pd=3.02u as=0.65p ps=3.02u w=2.5u l=2u
X86 perceptron_core_0.tanh_ota_0.V_ref VSS VSS ppolyf_u_1k r_width=3u r_length=20u
D14 VSS V_b_core diode_nd2ps_06v0 pj=40u area=99.99999p
X87 a_52131_62540# a_52131_62540# VSS VSS nfet_03v3 ad=0.39p pd=2.02u as=0.39p ps=2.02u w=1.5u l=0.5u
X88 a_55266_65406# a_55266_65406# VDD VDD pfet_03v3 ad=2.6p pd=10.52u as=2.6p ps=10.52u w=10u l=2u
X89 perceptron_core_0.tanh_ota_0.V_in_p perceptron_core_0.tanh_ota_0.V_ref a_44195_67876# VSS nfet_03v3 ad=0.65p pd=3.02u as=0.65p ps=3.02u w=2.5u l=0.5u
X90 VSS a_53826_51058# a_53958_50954# VSS nfet_03v3 ad=0.65p pd=3.02u as=0.65p ps=3.02u w=2.5u l=2u
X91 perceptron_core_0.tanh_ota_0.V_ref a_54068_46311# VDD VSS nfet_03v3 ad=2.6p pd=10.52u as=2.6p ps=10.52u w=10u l=1u
X92 VSS a_53826_51058# a_53958_65406# VSS nfet_03v3 ad=0.65p pd=3.02u as=0.65p ps=3.02u w=2.5u l=2u
X93 VDD VDD a_64353_58580# VDD pfet_03v3 ad=6.5p pd=21.3u as=2.6p ps=10.52u w=10u l=1u
X94 a_44195_47782# V_w2_core perceptron_core_0.tanh_ota_0.V_in_n VSS nfet_03v3 ad=0.65p pd=3.02u as=0.65p ps=3.02u w=2.5u l=0.5u
X95 a_54068_69233# a_55266_65406# VDD VDD pfet_03v3 ad=2.6p pd=10.52u as=2.6p ps=10.52u w=10u l=2u
D15 VSS V_b_core diode_nd2ps_06v0 pj=40u area=99.99999p
X96 a_48931_54374# V_b_core perceptron_core_0.tanh_ota_0.V_in_n VSS nfet_03v3 ad=0.65p pd=3.02u as=0.65p ps=3.02u w=2.5u l=0.5u
X97 VSS VSS VSS VSS nfet_03v3 ad=0.39p pd=2.02u as=0 ps=0 w=1.5u l=0.5u
X98 a_43991_51280# perceptron_core_0.tanh_ota_0.V_ref perceptron_core_0.tanh_ota_0.V_in_n VSS nfet_03v3 ad=0.65p pd=3.02u as=0.65p ps=3.02u w=2.5u l=0.5u
X99 a_44174_53200# perceptron_core_0.tanh_ota_0.V_ref VSS VSS nfet_03v3 ad=1.04p pd=4.52u as=1.04p ps=4.52u w=4u l=1u
X100 a_48931_54374# perceptron_core_0.tanh_ota_0.V_ref perceptron_core_0.tanh_ota_0.V_in_p VSS nfet_03v3 ad=0.65p pd=3.02u as=0.65p ps=3.02u w=2.5u l=0.5u
X101 a_55266_65406# VDD VDD VDD pfet_03v3 ad=2.6p pd=10.52u as=6.5p ps=21.3u w=10u l=2u
X102 VDD a_48342_63968# V_out_perceptron_core VDD pfet_03v3 ad=1.3p pd=5.52u as=1.3p ps=5.52u w=5u l=0.5u
X103 a_62775_58580# VDD VDD VDD pfet_03v3 ad=1.3p pd=5.52u as=3.25p ps=11.3u w=5u l=1u
X104 a_55266_50954# a_55134_51058# a_53958_50954# VSS nfet_03v3 ad=1.3p pd=5.52u as=1.3p ps=5.52u w=5u l=2u
X105 a_48931_54374# V_b_core perceptron_core_0.tanh_ota_0.V_in_n VSS nfet_03v3 ad=0.65p pd=3.02u as=0.65p ps=3.02u w=2.5u l=0.5u
X106 perceptron_core_0.tanh_ota_0.V_in_n V_w2_core a_44195_47782# VSS nfet_03v3 ad=0.65p pd=3.02u as=0.65p ps=3.02u w=2.5u l=0.5u
X107 a_55134_65510# a_60043_58514# VSS ppolyf_u_1k r_width=3u r_length=20u
X108 a_44195_67876# perceptron_core_0.tanh_ota_0.V_ref perceptron_core_0.tanh_ota_0.V_in_p VSS nfet_03v3 ad=0.65p pd=3.02u as=0.65p ps=3.02u w=2.5u l=0.5u
X109 VDD a_54068_69233# perceptron_core_0.voltage_reference_0.v_1_25 VSS nfet_03v3 ad=2.6p pd=10.52u as=2.6p ps=10.52u w=10u l=1u
X110 a_60430_60950# a_67218_61332# VSS ppolyf_u_1k r_width=3u r_length=23u
X111 VSS VSS a_43991_66200# VSS nfet_03v3 ad=3.05p pd=11.22u as=1.3p ps=5.52u w=5u l=0.5u
X112 a_44195_67876# V_w1_core perceptron_core_0.tanh_ota_0.V_in_n VSS nfet_03v3 ad=0.65p pd=3.02u as=0.65p ps=3.02u w=2.5u l=0.5u
X113 VSS perceptron_core_0.tanh_ota_0.V_ref a_44174_53200# VSS nfet_03v3 ad=1.04p pd=4.52u as=1.04p ps=4.52u w=4u l=1u
X114 a_53906_61332# a_60034_60480# VSS ppolyf_u_1k r_width=3u r_length=30u
X115 a_54068_46311# perceptron_core_0.tanh_ota_0.V_ref a_53958_50954# VSS nfet_03v3 ad=1.3p pd=5.52u as=1.3p ps=5.52u w=5u l=2u
X116 VDD a_54068_69233# perceptron_core_0.voltage_reference_0.v_1_25 VSS nfet_03v3 ad=2.6p pd=10.52u as=2.6p ps=10.52u w=10u l=1u
X117 a_43991_66200# V_w1_core perceptron_core_0.tanh_ota_0.V_in_p VSS nfet_03v3 ad=0.65p pd=3.02u as=0.65p ps=3.02u w=2.5u l=0.5u
X118 a_52131_62540# a_52131_62540# VSS VSS nfet_03v3 ad=0.39p pd=2.02u as=0.39p ps=2.02u w=1.5u l=0.5u
D16 VSS V_out_perceptron_core diode_nd2ps_06v0 pj=40u area=99.99999p
D17 V_out_perceptron_core VDD diode_pd2nw_06v0 pj=40u area=99.99999p
D18 VSS V_out_perceptron_core diode_nd2ps_06v0 pj=40u area=99.99999p
X119 VSS VSS a_53826_51058# VSS nfet_03v3 ad=3.05p pd=11.22u as=1.3p ps=5.52u w=5u l=1u
X120 a_48342_63968# a_48342_63968# VDD VDD pfet_03v3 ad=1.3p pd=5.52u as=1.3p ps=5.52u w=5u l=0.5u
X121 a_43991_66200# perceptron_core_0.tanh_ota_0.V_ref perceptron_core_0.tanh_ota_0.V_in_n VSS nfet_03v3 ad=0.65p pd=3.02u as=0.65p ps=3.02u w=2.5u l=0.5u
X122 a_52131_62540# a_52131_62540# VSS VSS nfet_03v3 ad=0.39p pd=2.02u as=0.39p ps=2.02u w=1.5u l=0.5u
X123 a_55266_50954# VSS VSS VSS nfet_03v3 ad=1.3p pd=5.52u as=3.05p ps=11.22u w=5u l=2u
X124 perceptron_core_0.tanh_ota_0.V_ref a_54068_46311# VDD VSS nfet_03v3 ad=2.6p pd=10.52u as=2.6p ps=10.52u w=10u l=1u
X125 a_62775_58580# perceptron_core_0.voltage_reference_0.v_1_15 perceptron_core_0.voltage_reference_0.v_1_15 VDD pfet_03v3 ad=2.6p pd=10.52u as=2.6p ps=10.52u w=10u l=1u
X126 a_44195_47782# perceptron_core_0.voltage_reference_0.v_1_25 a_44174_53200# VSS nfet_03v3 ad=1.3p pd=5.52u as=1.3p ps=5.52u w=5u l=0.5u
X127 a_49772_52654# perceptron_core_0.tanh_ota_0.V_ref VSS VSS nfet_03v3 ad=1.04p pd=4.52u as=1.04p ps=4.52u w=4u l=1u
X128 perceptron_core_0.gilbert_multiplier_current_2.V_x_n perceptron_core_0.voltage_reference_0.v_1_25 VSS ppolyf_u_1k r_width=3u r_length=8.1u
X129 a_53958_50954# a_53826_51058# VSS VSS nfet_03v3 ad=0.65p pd=3.02u as=0.65p ps=3.02u w=2.5u l=2u
X130 a_44195_47782# VSS VSS VSS nfet_03v3 ad=1.3p pd=5.52u as=3.05p ps=11.22u w=5u l=0.5u
X131 VDD VDD a_55266_50954# VDD pfet_03v3 ad=6.5p pd=21.3u as=2.6p ps=10.52u w=10u l=2u
D19 VSS I_x2_core diode_nd2ps_06v0 pj=40u area=99.99999p
X132 a_44174_64480# perceptron_core_0.tanh_ota_0.V_ref VSS VSS nfet_03v3 ad=1.04p pd=4.52u as=1.04p ps=4.52u w=4u l=1u
D20 VSS V_w1_core diode_nd2ps_06v0 pj=40u area=99.99999p
X133 a_53958_50954# a_53826_51058# VSS VSS nfet_03v3 ad=0.65p pd=3.02u as=0.65p ps=3.02u w=2.5u l=2u
X134 a_62775_58580# a_60034_57400# VDD VDD pfet_03v3 ad=1.3p pd=5.52u as=1.3p ps=5.52u w=5u l=1u
X135 VSS a_60034_53992# VSS ppolyf_u_1k r_width=3u r_length=30u
X136 VDD a_55266_50954# a_54068_46311# VDD pfet_03v3 ad=2.6p pd=10.52u as=2.6p ps=10.52u w=10u l=2u
D21 VSS I_x2_core diode_nd2ps_06v0 pj=40u area=99.99999p
X137 a_49772_52654# a_49921_49178# VSS ppolyf_u_1k r_width=3u r_length=11.55u
X138 perceptron_core_0.voltage_reference_0.v_1_15 a_64353_58580# VSS VSS nfet_03v3 ad=1.3p pd=5.52u as=1.3p ps=5.52u w=5u l=1u
X139 perceptron_core_0.gilbert_multiplier_current_1.V_x_n perceptron_core_0.voltage_reference_0.v_1_25 VSS ppolyf_u_1k r_width=3u r_length=8.1u
X140 VSS perceptron_core_0.tanh_ota_0.V_ref a_44174_64480# VSS nfet_03v3 ad=1.04p pd=4.52u as=1.04p ps=4.52u w=4u l=1u
X141 V_out_perceptron V_out_perceptron_core VDD ppolyf_u r_width=40u r_length=10u
X142 a_53958_50954# VSS VSS VSS nfet_03v3 ad=0.65p pd=3.02u as=1.525p ps=6.22u w=2.5u l=2u
X143 VDD a_60034_57400# a_60034_57400# VDD pfet_03v3 ad=1.3p pd=5.52u as=1.3p ps=5.52u w=5u l=1u
X144 VDD a_55266_50954# a_55266_50954# VDD pfet_03v3 ad=2.6p pd=10.52u as=2.6p ps=10.52u w=10u l=2u
X145 a_48342_63968# perceptron_core_0.tanh_ota_0.V_in_p a_50871_64476# VSS nfet_03v3 ad=1.3p pd=5.52u as=1.3p ps=5.52u w=5u l=0.5u
X146 a_47887_67604# a_52415_68456# VSS ppolyf_u_1k r_width=3u r_length=22u
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
