valrek-sol/analog-perceptron-gf180mcu/(commit log)

2026-07-07 schematics initial commit
    [diff_pair.sch, untitled.sch]
2026-07-07 gilbert cell schematic done with full quadrant sweep sim
    [gilbert_multiplier.sch, tb_gilbert_multiplier.sch, untitled.sch]
2026-07-07 completed block level schema and sim
    [cg_amp_tia.sch, tanh_ota.sch, tb_cg_amp_tia.sch, tb_tanh_ota.sch]
2026-07-07 completed top module first pass
    [cg_amp_tia.sch, diff_pair.sch, gilbert_multiplier_current.sch, perceptron.sch, tanh_ota.sch, tb_cg_amp_tia.sch, tb_gilbert_multiplier_current.sch, tb_perceptron.sch]
2026-07-07 partial commit
    [perceptron.sch, tb_perceptron.sch]
2026-07-07 added (uv) python for plotting, with simulation results
    [tb_cg_amp_tia.sch, tb_gilbert_multiplier_current.sch, tb_perceptron.sch, tb_tanh_ota.sch]
2026-07-07 phase 1 schematic simulation artifacts done
    [tb_cg_amp_tia.sch, tb_gilbert_multiplier_current.sch, tb_tanh_ota.sch]
2026-08-03 implemented V_Shift for theta param activation function
    [perceptron.sch, tb_perceptron.sch]
2026-08-07 Added Voltage Reference Block, Realistic Testbench (wip) , operating point analysis
    [cg_amp_tia.sch, gilbert_multiplier_current.sch, perceptron.sch, tanh_ota.sch, tb_cg_amp_tia.sch, tb_gilbert_multiplier_current.sch, tb_realistic_perceptron .sch, tb_tanh_ota.sch]
2026-08-07 finalized schematic, ac/transient analysis done, scripts done.
    [tb_demo_perceptron.sch, tb_realistic_perceptron .sch]
2026-08-08 stable voltage reference and consistent simulation results
    [cg_amp_tia.sch, gilbert_multiplier.sch, gilbert_multiplier_current.sch, perceptron.sch, tanh_ota.sch, tb_demo_perceptron.sch, tb_gilbert_multiplier.sch, tb_gilbert_multiplier_current.sch]
2026-08-08 final schematic, i hope. kept layout in mind
    [voltage_reference.sch]
2026-08-08 silly commit
    [tb_demo_perceptron.sch, tb_voltage_reference.sch]
2026-08-11 tanh_ota LVS and DRC Passed
    [tanh_ota.sch]
2026-08-11 tanh ota refined (LVS and DRC clean still)
    [tanh_ota.sch]
2026-08-12 Voltage Reference DRC LVS clean Layout done.
2026-08-12 adjusted voltage reference pins
2026-08-14 Layout complete
    [voltage_reference.sch]
2026-08-14 realistic perceptron sim
    [tb_realistic_perceptron .sch]
2026-08-15 added info.yaml pin configuration
2026-08-19 ran some tests, changed some, tanh ota self biases now
    [cg_amp_tia.sch, perceptron.sch, tanh_ota.sch, tb_cg_amp_tia.sch, tb_gilbert_multiplier_current.sch, tb_realistic_perceptron .sch, tb_tanh_ota.sch]
2026-08-19 refined the schematics for PVT
    [gilbert_multiplier_current.sch, perceptron.sch, tb_cg_amp_tia.sch, tb_gilbert_multiplier_current.sch, tb_realistic_perceptron .sch, tb_tanh_ota.sch, tb_voltage_reference.sch]
2026-08-19 refined the schematics for PVT again
    [gilbert_multiplier_current.sch, tanh_ota.sch]
2026-08-19 finalized schematic for better pvt circuit, handles every corner well. sizings changed, so layout v2 will need work
    [perceptron.sch, tb_voltage_reference.sch, voltage_reference.sch]
2026-08-21 added VSS pin to info.yaml
2026-08-21 added VSS pin to info.yaml refined
2026-08-23 fixed vss io_type to ground
2026-08-25 2d common centroid LVS DRC clean gilbert cell done
    [gilbert_multiplier_current.sch]
2026-08-25 DRC LVS clean tanh_ota with 1D common centroid, dummies, etc.,
    [tanh_ota.sch]
2026-08-26 partial commit for voltage reference
2026-08-26 voltage reference LVS DRC clean common centroid symmetric dummy done
    [voltage_reference.sch]
2026-08-27 DRC LVS Clean Layout (much better) v2 done
    Gilbert cell 2d 4 row 8 column common centroid !
    all others DABBAD common centroid wherever applicable
    DAAD , DAAAAD, etc., (D for dummy)
    tighter routing, no metal 4 used ever. m1,m2,m3 only.
    Voltage reference more robust and compact-er
    Transistors are actually larger in average.
    How is this? second attempt at my first layout project ever!
    yay.
2026-08-28 corrected pin names
2026-08-31 partial refactor commit
    [cg_amp_tia.sch, gilbert_multiplier_current.sch, perceptron.sch, tanh_ota.sch, tb_cg_amp_tia.sch, tb_demo_perceptron.sch, tb_gilbert_multiplier_current.sch, tb_perceptron.sch]
2026-08-31 partial refactor done, simulations pending
    [io_secondary_5p0.sch, perceptron.sch, perceptron_core.sch, tanh_ota.sch, tb_cg_amp_tia.sch, tb_demo_perceptron_core.sch, tb_gilbert_multiplier_current.sch, tb_perceptron_core.sch]
2026-08-31 partial commit : good circuit even with ESD protection. verified with simulation
    All that is left is diagrams, organizing stuff, and lvs schematics with sims verified,
    along with proper lvs schematics for perceptron_core and perceptron
    [tb_perceptron.sch, tb_perceptron_core.sch, tb_realistic_perceptron .sch, tb_realistic_perceptron_core.sch]
2026-09-01 schematics lvs and non lvs done
    [io_secondary_5p0.sch, perceptron.sch, perceptron_core.sch, tb_cg_amp_tia.sch, tb_demo_perceptron_core.sch, tb_gilbert_multiplier_current.sch, tb_perceptron.sch, tb_perceptron_core.sch]
2026-09-01 completed LVS and DRC clean integration with ESD, pictures, schematic segregation
    [perceptron.sch, perceptron_core.sch]
2026-09-01 diagrams updated
    [perceptron.sch]
2026-09-11 added inverted colors of xschem schematics for dark mode
